refaqt/aqtuator/README.md

# AQTUATOR

A product line of linear stages.

Each stage family is a module of this repository. A Mekanika Pro milling machine is the test bench
the stages are measured on.

Folder names say what a stage is, not what it is called on a price list. A commercial name belongs
in a family's `catalog.toml` when there is one.

| Family | What |
| --- | --- |
| [`modules/flexure-ball-screw-servo-stage/`](modules/flexure-ball-screw-servo-stage/) | Linear stage with active chatter suppression: flexure guidance, ball screw, servo drive |
| [`modules/compact-stage/`](modules/compact-stage/) | Compact linear stage. Name reserved, nothing designed yet |

The flexure ball-screw servo stage is the work that started this project. Chatter — self-excited
vibration between tool and workpiece — sets the maximum depth of cut a machine can take. The work so far has been measurement:
frequency response functions at the tool and spindle, and cutting stability limits, across three
drive configurations (stepper, servo with rotary encoder feedback, servo with linear encoder
feedback). Those measurements are what an actuator design can be held against.

## Layout

This repository follows [doqs](https://github.com/refaqt/doqs), included as a submodule at
[`doqs/`](doqs/). Every folder is a module with the same internal structure.

| Folder | What |
| --- | --- |
| [`modules/`](modules/) | The stage families, each a module of its own |
| [`cad/`](cad/) | FreeCAD models |
| [`architecture/`](architecture/) | SysML requirements and block definitions |
| [`simulation/`](simulation/) | Design-time models — structural dynamics, PWM/RC trade-off |
| [`docs/`](docs/) | Activity log, decisions, mistakes, patterns |

The measurement campaigns, the firmware and the host software sit inside the family they belong to,
at [`modules/flexure-ball-screw-servo-stage/`](modules/flexure-ball-screw-servo-stage/). They move with that family if it ever becomes its own
repository.

Start with [`docs/architecture.md`](docs/architecture.md) for the technical overview, or
[`docs/log/`](docs/log/) for the chronological story — 71 entries from June 2025 onward.
For the servo drive choice, see [`docs/servo-drive-selection.md`](docs/servo-drive-selection.md).
For the linear encoder choice, see [`docs/linear-encoder-selection.md`](docs/linear-encoder-selection.md).

## Clone

```bash
git clone --recurse-submodules https://github.com/refaqt/aqtuator.git
cd aqtuator
pip install -e modules/flexure-ball-screw-servo-stage/software/identification -e modules/flexure-ball-screw-servo-stage/software/measurement-tools
```

If you already cloned without submodules, or `doqs/` / `.agents/` is empty: `bash setup-tooling.sh`
from the repo root (agents, any OS). Humans on Windows may double-click `setup-tooling.bat`. Without
`doqs/` and `.agents/`, layout validators and shared agent rules/skills are unavailable.

## Measurement data

Raw data is **not in this repository**. 1 659 files and 1.88 GB live on the `3 - Projects` Google
Drive shared drive;
[`modules/flexure-ball-screw-servo-stage/measurement/data-index.csv`](modules/flexure-ball-screw-servo-stage/measurement/data-index.csv)
describes every one of them with a checksum and parsed metadata, so the archive can be queried
without downloading it.

See [`modules/flexure-ball-screw-servo-stage/measurement/README.md`](modules/flexure-ball-screw-servo-stage/measurement/README.md) for access and
the reasoning.

## Agents

Cursor, Claude Code, and cloud agents: start at [`AGENTS.md`](AGENTS.md). Shared kit is in
[`.agents/`](.agents/); repo-specific rules and skills in [`.agents-local/`](.agents-local/).

## Hardware

- Mekanika Pro milling machine with PlanetCNC control
- ODrive S1 servo drive, linear and rotary encoder feedback. **The ODrive is for testing only. We will
  not use it in future developments.** See the
  [decision record](docs/decisions/2026-10-02_odrive-is-for-testing-only.md).
- Controllino MICRO (RP2040) for torque excitation and acquisition
- DATAQ WinDaq HiRes DAQ, 8 channels, accelerometers and impact hammer

## Licence

Copyright © 2025–2026 Refaqt (BE 0804.145.539) and contributors. Contributions are accepted under the [Refaqt Contributor Licence Agreement](https://github.com/refaqt/.github/blob/main/CLA.md).

This repository uses different licences for different kinds of content:

- **Hardware** (`cad/`, `architecture/`, `manufacturing/`, `bom/`, `builds/`, `modules/`) —
  [CERN-OHL-S v2.0](LICENSES/CERN-OHL-S-2.0.txt)
- **Firmware & software** (`simulation/`, and the `firmware/` and `software/` folders inside a
  module) — [GPL-3.0](LICENSES/GPL-3.0.txt)
- **Media & documentation** (`docs/`, and the `measurement/` folder inside a module) —
  [CC BY-SA 4.0](LICENSES/CC-BY-SA-4.0.txt)

A module carries its own `LICENSE` stub wherever its content type differs from the CERN-OHL-S that
covers `modules/`.

The REFAQT name and logo, and the AQTUATOR name and logo, are trademarks and
are not covered by the above — see [TRADEMARKS.md](TRADEMARKS.md).

See [LICENSE](LICENSE) for the full overview and directory mapping.
