refaqt/aqtuator/simulation/README.md

# Simulation

Design-time analysis: models that predict behaviour before or instead of measuring it. The measured
counterpart lives in [`modules/flexure-ball-screw-servo-stage/measurement/`](../modules/flexure-ball-screw-servo-stage/measurement/) — see
[`doqs/docs/architecture.md`](../doqs/docs/architecture.md) for the distinction.

| Case | Tool | Question |
| --- | --- | --- |
| [`encoder-stray-field`](cases/encoder-stray-field/) | Python (`magpylib`) | How strong is the linear motor field at the encoder read head, and how much does a steel plate lower it? (Magnet sizes are a worst-case guess; measure before ordering.) |
| [`housing-vibrations`](cases/housing-vibrations/) | Octave (`control`) | How do stage, housing, base and reaction masses respond to feed-driven acceleration? |
| [`mass-system`](cases/mass-system/) | Octave (`symbolic`) | Symbolic equivalent mass of the coupled two-mass system |
| [`pwm-rc-filter`](cases/pwm-rc-filter/) | Python | What PWM resolution and RC corner give the best torque-command ENOB? |
| [`short-stroke-actuator-concepts`](cases/short-stroke-actuator-concepts/) | Python | Can a two-sided 0.1 mm / > 10 Hz actuator fit 50 × 50 × 20 mm under 100 EUR? (200 N reluctance is pole-face Maxwell, not packaged continuous — Fluxthor catalog check in the case README.) |
| [`strip-seal-fatigue`](cases/strip-seal-fatigue/) | Python | Which strip material and roller size does the seal need, and how should its life be stated? (Fatigue values are measured supplier data, and they hold for dry air only.) |
| [`strip-seal-preload`](cases/strip-seal-preload/) | Python (`numpy`, `scipy`) | Which radius does a 0.25 mm strip really take over 10 mm rollers, how does the pull change it, and can 304 replace 301? (Layout read off a sketch; confirm against CAD.) |
| [`strip-seal-designer`](cases/strip-seal-designer/) | HTML + JavaScript (Node for checks) | How does the strip bend over the rollers, what force does each roller carry, and how much screw travel gives how much preload? Web page on GitHub Pages. (Magnet strip stiffness is an estimate.) |
| [`cutting-force-rejection`](cases/cutting-force-rejection/) | HTML + JavaScript (Node for checks) | How much does the stage move under a milling force? Compares a linear motor with a ball-screw servo, read at the motor or at the stage. Web page on GitHub Pages. (Coupling and axial stiffness, one sine force.) |
| [`damper-sizing`](cases/damper-sizing/) | HTML + JavaScript (Node for checks) | How fast does the stage hit its end damper after a runaway, and what damper stops it? Shows force, speed and energy along the damper stroke. Web page on GitHub Pages. (One rigid mass, no field weakening, damper force c·vⁿ.) |
| [`hard-turning-stability`](cases/hard-turning-stability/) | HTML + JavaScript (Node for checks) | Can two stacked compact stages hard turn steel at 61 to 63 HRC? Stiffness at the tool tip and stability lobes for a given depth of cut, feed and cutting speed. Web page on GitHub Pages. (Damping, thrust ratio and holder are estimates; motor loop and guides added in series.) |

Results summaries belong in `results/<case-slug>/summary.md`. Heavy outputs
(`results/<case>/exports/`) are gitignored.

## Running

```bash
octave simulation/cases/housing-vibrations/housing_vibrations.m
python simulation/cases/pwm-rc-filter/pwm_filter_optimizer.py
python3 simulation/cases/short-stroke-actuator-concepts/size_concepts.py
python3 simulation/cases/encoder-stray-field/stray_field.py
python3 simulation/cases/strip-seal-preload/strip_seal_preload.py
node simulation/cases/strip-seal-designer/check_model.mjs
node simulation/cases/cutting-force-rejection/check_model.mjs
node simulation/cases/damper-sizing/check_model.mjs
node simulation/cases/hard-turning-stability/check_model.mjs
```

Octave cases need `pkg load control` and `pkg load symbolic`.
