refaqt/aqtuator/docs/log/README.md

# Activity log

Chronological record of work on this project (engineering and business). Entries follow
`YYYY-MM-DD_topic.md`, newest listed last. Every entry must include **Role(s)**.

These entries were converted from the original `log.docx` (itself an export of the
*AQTUATOR - project log* Google Doc) and later extended. **Git is the source of truth** —
the Google Doc is retained as a historical archive and is no longer edited.

To add an entry, see [`.agents/skills/log/SKILL.md`](../../.agents/skills/log/SKILL.md).

| Date | Topic | Role(s) | Images |
| ---- | ----- | --- | -----: |
| 2025-06-26 | [Chatter mass-spring-damper model](2025-06-26_chatter-mass-spring-damper-model.md) | engineering |  |
| 2025-06-27 | [High-Z axis Z-plate modification](2025-06-27_high-z-axis-z-plate-modification.md) | engineering |  |
| 2025-08-14 | [Z motor range PlanetCNC](2025-08-14_z-motor-range-planetcnc.md) | engineering |  |
| 2025-08-28 | [Accelerometer selection IEPE](2025-08-28_accelerometer-selection-iepe.md) | engineering |  |
| 2025-09-09 | [Xcos Coselica mass-spring-damper model](2025-09-09_xcos-coselica-mass-spring-damper.md) | engineering | 2 |
| 2025-09-22 | [Actuator power requirement](2025-09-22_actuator-power-requirement.md) | engineering |  |
| 2025-09-24 | [Chatter intuitive model](2025-09-24_chatter-intuitive-model.md) | engineering |  |
| 2025-09-25 | [Laplace domain system diagram](2025-09-25_laplace-domain-system-diagram.md) | engineering |  |
| 2025-09-30 | [Milling parameters cutting stability](2025-09-30_milling-parameters-cutting-stability.md) | engineering |  |
| 2025-10-06 | [Experiment parameters tool stickout](2025-10-06_experiment-parameters-tool-stickout.md) | engineering |  |
| 2025-10-08 | [Inertia matching research](2025-10-08_inertia-matching-research.md) | engineering |  |
| 2025-10-09 | [Maximum cutting depth vs damping and stiffness](2025-10-09_max-cutting-depth-damping-stiffness.md) | engineering | 2 |
| 2025-10-10 | [Tool experiments](2025-10-10_tool-experiments.md) | engineering |  |
| 2025-10-14 | [Rotary encoder for commutation](2025-10-14_rotary-encoder-for-commutation.md) | engineering |  |
| 2025-10-16 | [Spindle speed verification](2025-10-16_spindle-speed-verification.md) | engineering |  |
| 2025-10-17 | [Meeting notes](2025-10-17_meeting-notes.md) | engineering |  |
| 2025-10-21 | [Shaft coupling selection](2025-10-21_shaft-coupling-selection.md) | engineering |  |
| 2025-11-03 | [Opta A0602 analog outputs](2025-11-03_opta-a0602-analog-outputs.md) | engineering |  |
| 2025-11-04 | [Servo motor setup](2025-11-04_servo-motor-setup.md) | engineering | 5 |
| 2025-11-05 | [Brake resistor and analog mapping](2025-11-05_brake-resistor-and-analog-mapping.md) | engineering |  |
| 2025-11-12 | [Thesis meeting](2025-11-12_thesis-meeting.md) | engineering |  |
| 2025-11-14 | [Opta analog bandwidth limit](2025-11-14_opta-analog-bandwidth-limit.md) | engineering |  |
| 2025-11-20 | [Arduino Giga system identification](2025-11-20_arduino-giga-system-identification.md) | engineering |  |
| 2025-11-24 | [Dampers and stops](2025-11-24_dampers-and-stops.md) | engineering |  |
| 2025-11-26 | [ODrive analog input stuck at 4 V](2025-11-26_odrive-analog-input-stuck-4v.md) | engineering |  |
| 2025-11-27 | [Stepper drive pulse/direction control](2025-11-27_stepper-drive-pulse-direction.md) | engineering | 1 |
| 2025-12-01 | [High speed circular motion steppers](2025-12-01_high-speed-circular-motion-steppers.md) | engineering |  |
| 2025-12-03 | [Linear encoder design](2025-12-03_linear-encoder-design.md) | engineering | 1 |
| 2025-12-10 | [NUCLEO ODrive CAN connection](2025-12-10_nucleo-odrive-can-connection.md) | engineering | 2 |
| 2025-12-18 | [Controllino CAN timing](2025-12-18_controllino-can-timing.md) | engineering |  |
| 2025-12-19 | [Stepper motor stiffness](2025-12-19_stepper-motor-stiffness.md) | engineering |  |
| 2026-01-06 | [Controllino ODrive CAN communication](2026-01-06_controllino-odrive-can-communication.md) | engineering | 1 |
| 2026-01-07 | [Multisine upload CAN torque](2026-01-07_multisine-upload-can-torque.md) | engineering |  |
| 2026-01-08 | [Controllino analog inputs](2026-01-08_controllino-analog-inputs.md) | engineering |  |
| 2026-01-09 | [Thesis meeting](2026-01-09_thesis-meeting.md) | engineering |  |
| 2026-01-12 | [ODrive limitations](2026-01-12_odrive-limitations.md) | engineering |  |
| 2026-01-15 | [E-stop design](2026-01-15_e-stop-design.md) | engineering |  |
| 2026-01-19 | [Thesis meeting](2026-01-19_thesis-meeting.md) | engineering |  |
| 2026-01-22 | [Z-axis accelerometer redesign](2026-01-22_z-axis-accelerometer-redesign.md) | engineering | 1 |
| 2026-01-27 | [Machine stiffness measurement](2026-01-27_machine-stiffness-measurement.md) | engineering |  |
| 2026-01-28 | [Controllino MCP analog scaling](2026-01-28_controllino-mcp-analog-scaling.md) | engineering |  |
| 2026-01-29 | [Stepper driver survey](2026-01-29_stepper-driver-survey.md) | engineering |  |
| 2026-02-02 | [Stability testing aluminium](2026-02-02_stability-testing-aluminium.md) | engineering |  |
| 2026-02-04 | [Steel cutting settings](2026-02-04_steel-cutting-settings.md) | engineering |  |
| 2026-02-05 | [Nanotec driver evaluation](2026-02-05_nanotec-driver-evaluation.md) | engineering |  |
| 2026-02-06 | [Controllino digital input shortage](2026-02-06_controllino-digital-input-shortage.md) | engineering |  |
| 2026-02-09 | [ODrive servo identification](2026-02-09_odrive-servo-identification.md) | engineering |  |
| 2026-02-12 | [Thesis meeting](2026-02-12_thesis-meeting.md) | engineering |  |
| 2026-02-24 | [Electrical cabinet electronics](2026-02-24_electrical-cabinet-electronics.md) | engineering | 1 |
| 2026-03-04 | [PlanetCNC step/dir/enable signals](2026-03-04_planetcnc-step-dir-enable.md) | engineering | 5 |
| 2026-03-05 | [RS-422 to TTL line receiver](2026-03-05_rs422-to-ttl-line-receiver.md) | engineering |  |
| 2026-03-10 | [ODrive motor noise on accelerometers](2026-03-10_odrive-motor-noise-on-accelerometers.md) | engineering | 2 |
| 2026-03-19 | [ODrive GUI configuration](2026-03-19_odrive-gui-configuration.md) | engineering | 7 |
| 2026-03-20 | [Stepper eigenfrequency](2026-03-20_stepper-eigenfrequency.md) | engineering |  |
| 2026-03-25 | [ODrive analog torque input](2026-03-25_odrive-analog-torque-input.md) | engineering | 9 |
| 2026-03-26 | [ODrive analog input mapping](2026-03-26_odrive-analog-input-mapping.md) | engineering |  |
| 2026-03-30 | [ODrive motor thermistor](2026-03-30_odrive-motor-thermistor.md) | engineering |  |
| 2026-03-31 | [Multisine identification](2026-03-31_multisine-identification.md) | engineering | 6 |
| 2026-04-01 | [Accelerometer system identification](2026-04-01_accelerometer-system-identification.md) | engineering | 5 |
| 2026-04-03 | [System non linearities](2026-04-03_system-non-linearities.md) | engineering | 4 |
| 2026-04-13 | [ODrive linear encoder integration](2026-04-13_odrive-linear-encoder-integration.md) | engineering | 1 |
| 2026-04-15 | [Meeting Joppe](2026-04-15_meeting-joppe.md) | engineering | 1 |
| 2026-04-16 | [Stability with flexibility](2026-04-16_stability-with-flexibility.md) | engineering | 4 |
| 2026-04-17 | [CAN cyclic identification](2026-04-17_can-cyclic-identification.md) | engineering |  |
| 2026-04-21 | [Linear motor suppliers](2026-04-21_linear-motor-suppliers.md) | engineering |  |
| 2026-04-22 | [FRF: flexible suspension vs stepper](2026-04-22_frf-flexible-vs-stepper.md) | engineering | 3 |
| 2026-04-24 | [Tap test reciprocating motion](2026-04-24_tap-test-reciprocating-motion.md) | engineering | 4 |
| 2026-04-29 | [Revert to stepper motors](2026-04-29_revert-to-stepper-motors.md) | engineering |  |
| 2026-05-07 | [FRF and compliance measurements](2026-05-07_frf-and-compliance-measurements.md) | engineering | 9 |
| 2026-05-20 | [Results so far](2026-05-20_results-so-far.md) | engineering |  |
| 2026-08-21 | [New ideas](2026-08-21_new-ideas.md) | engineering |  |
| 2026-08-21 | [doqs restructure](2026-08-21_doqs-restructure.md) | engineering |  |
| 2026-08-24 | [Reluctance actuator investigation](2026-08-24_reluctance-actuator-investigation.md) | engineering |  |
| 2026-08-27 | [Unify agent skills and rules](2026-08-27_unify-agent-skills-and-rules.md) | engineering |  |
| 2026-08-28 | [Slim AGENTS.md to thin stub](2026-08-28_slim-agents-md.md) | engineering |  |
| 2026-09-01 | [Always-latest tooling submodules](2026-09-01_always-latest-tooling-submodules.md) | engineering |  |
| 2026-09-01 | [Root launchers from setup-tooling](2026-09-01_root-launcher-install.md) | engineering |  |
| 2026-09-02 | [Short-stroke actuator concepts](2026-09-02_short-stroke-actuator-concepts.md) | engineering, hardware, simulation |  |
| 2026-09-02 | [Fluxthor reluctance force density](2026-09-02_fluxthor-reluctance-force-density.md) | engineering, simulation |  |
| 2026-09-16 | [Cloud agents can read the tooling submodules](2026-09-16_cloud-agent-tooling-refresh.md) | engineering, software |  |
| 2026-09-16 | [Checked every doqs template against this repository](2026-09-16_doqs-template-audit.md) | engineering, software |  |
| 2026-09-17 | [aqtuator moved to the one doqs command](2026-09-17_adopt-the-doqs-command.md) | engineering, software |  |
| 2026-09-17 | [An agent can now work in the open FreeCAD window](2026-09-17_freecad-mcp-bridge.md) | engineering, software, cad |  |
| 2026-09-18 | [AQTUATOR becomes a product line of linear stages](2026-09-18_stage-families-as-modules.md) | engineering |  |
| 2026-09-18 | [The FreeCAD bridge on the second computer](2026-09-18_freecad-bridge-second-computer.md) | engineering, software, cad |  |
| 2026-09-21 | [Bought parts move out of this repository](2026-09-21_bought-parts-move-to-the-parts-library.md) | engineering |  |
| 2026-09-22 | [How long the seal strip lasts, and how to say it](2026-09-22_strip-seal-fatigue.md) | engineering, simulation |  |
| 2026-09-22 | [The seal strip rollers were never the problem](2026-09-22_strip-seal-bending-radius.md) | engineering, simulation |  |
| 2026-09-22 | [The first step always runs now](2026-09-22_the-first-step-always-runs.md) | engineering, software |  |
| 2026-09-23 | [The motor field at the encoder, and a steel shield](2026-09-23_encoder-stray-field-shield.md) | engineering, simulation |  |
| 2026-09-25 | [A measured seal strip, and a way to preload ours](2026-09-25_strip-seal-thickness-and-preload.md) | engineering, measurement, hardware |  |
| 2026-09-25 | [The 0.25 mm seal strip: radius, pull, and 304 instead of 301](2026-09-25_strip-seal-radius-pull-and-304.md) | engineering, simulation |  |
| 2026-09-25 | [Drives and a motion controller for the MK21 linear stages](2026-09-25_linear-stage-drive-and-motion-controller-survey.md) | engineering, hardware, software, purchasing |  |
| 2026-09-28 | [A web page to design the seal strip and its screw preload](2026-09-28_strip-seal-designer.md) | engineering, simulation, software |  |
| 2026-09-28 | [A web page for the controller against the cutting force](2026-09-28_cutting-force-rejection.md) | engineering, simulation, software |  |
| 2026-09-28 | [The cutting force page compares a linear motor with a ball-screw servo](2026-09-28_ball-screw-servo-cases.md) | engineering, simulation, software |  |
| 2026-09-28 | [The ball screw gets its axial stiffness, and loses most of its lead](2026-09-28_ball-screw-axial-stiffness.md) | engineering, simulation, software |  |
| 2026-09-28 | [The cutting force page tunes every drive with robust rules](2026-09-28_robust-tuning-and-damping.md) | engineering, simulation, software |  |
| 2026-09-29 | [Why a lighter stage is less stiff, and why more gain does not help](2026-09-29_why-a-lighter-stage-is-less-stiff.md) | engineering, simulation |  |
| 2026-09-29 | [The cutting force page shows where chatter starts](2026-09-29_chatter-limit.md) | engineering, simulation, software |  |
| 2026-09-29 | [Servotronix drives with a faster position loop](2026-09-29_servotronix-drives-with-a-faster-loop.md) | engineering, hardware, purchasing |  |
| 2026-09-29 | [Drives from non-Israeli suppliers with an open control loop](2026-09-29_non-israeli-drives-with-open-control-loops.md) | engineering, hardware, purchasing |  |
| 2026-09-29 | [Drives below 800 euro per axis, from maker forums and open source](2026-09-29_drives-below-800-euro-per-axis.md) | engineering, hardware, purchasing |  |
| 2026-09-29 | [HIWIN, Delta and Kollmorgen follow-up](2026-09-29_hiwin-delta-kollmorgen-follow-up.md) | engineering, hardware, purchasing |  |
| 2026-09-29 | [Encoder converters and drives that read SSI or BiSS-C](2026-09-29_encoder-converter-and-ssi-biss-drives.md) | engineering, hardware, purchasing |  |
| 2026-09-29 | [The motor drive requirements are now in the SysML model](2026-09-29_motor-drive-requirements-in-sysml.md) | engineering, hardware, purchasing |  |
| 2026-09-30 | [Can the CDHD2S velocity loop run our own controller?](2026-09-30_cdhd2s-velocity-loop-custom-filter.md) | engineering, hardware, purchasing |  |
| 2026-09-30 | [Tonghang drives checked against the drive requirements](2026-09-30_tonghang-drives-checked-against-the-requirements.md) | engineering, purchasing |  |
| 2026-09-30 | [Delta ASDA-A3 drives checked against the drive requirements](2026-09-30_delta-asda-a3-checked-against-the-requirements.md) | engineering, purchasing |  |
| 2026-09-30 | [The linear stage requirements are now in the SysML model](2026-09-30_linear-stage-requirements-in-sysml.md) | engineering, hardware |  |
| 2026-09-30 | [The compact stage has its parts, its assembly and its interfaces](2026-09-30_compact-stage-parts-and-interfaces.md) | engineering, cad |  |
| 2026-10-01 | [The compact stage parts now sit in a Part container](2026-10-01_compact-stage-parts-in-a-part-container.md) | cad |  |
| 2026-10-02 | [The base has mounting holes and alignment tabs for the guide rails](2026-10-02_rail-mounting-holes-in-the-base.md) | cad, architecture |  |
| 2026-10-02 | [Comparison table of all linear encoders considered so far](2026-10-02_linear-encoder-comparison.md) | engineering, purchasing |  |
| 2026-10-02 | [One overview of all servo drives we considered](2026-10-02_servo-drive-selection-overview.md) | engineering, purchasing |  |
| 2026-10-06 | [Servo drives checked for a Bode plot tuning tool](2026-10-06_drives-checked-for-bode-plot-tuning.md) | engineering, purchasing |  |
| 2026-10-06 | [The linear encoder table has its own page](2026-10-06_linear-encoder-selection-page.md) | engineering, purchasing |  |
| 2026-10-06 | [Best linear encoder on paper, and what the short list costs](2026-10-06_linear-encoder-choice-and-prices.md) | engineering, purchasing |  |
| 2026-10-07 | [The rails are in the compact-stage assembly](2026-10-07_rails-in-the-compact-stage-assembly.md) | cad |  |
| 2026-10-07 | [How to mount the encoder scale tape in the pocket of the base](2026-10-07_mounting-the-encoder-scale-tape.md) | engineering, hardware |  |
| 2026-10-07 | [The rail blocks are in the compact-stage assembly](2026-10-07_rail-blocks-in-the-compact-stage-assembly.md) | cad |  |
| 2026-10-09 | [First draft of the bottom carriage](2026-10-09_first-draft-of-the-bottom-carriage.md) | cad |  |
| 2026-10-09 | [Carriage sides clear the base](2026-10-09_carriage-sides-clear-the-base.md) | cad |  |
| 2026-10-09 | [Stiffer bottom carriage](2026-10-09_stiffer-bottom-carriage.md) | cad |  |
| 2026-10-12 | [Linear motor pocket and cooling channel in the bottom carriage](2026-10-12_linear-motor-pocket-in-the-bottom-carriage.md) | cad |  |
| 2026-10-12 | [Water cooling fittings, and MK21 heat at 200 N](2026-10-12_water-cooling-fittings-and-mk21-heat-at-200-n.md) | engineering, purchasing |  |
| 2026-10-12 | [Idea: a path for the motor and reading head cables in the bottom carriage](2026-10-12_motor-cable-path-in-the-bottom-carriage.md) | cad | 2 |
| 2026-10-12 | [Lubrication of the guide blocks](2026-10-12_lubrication-of-the-guide-blocks.md) | engineering, cad, purchasing |  |
| 2026-10-13 | [Load and life of the HIWIN QE15 guide blocks](2026-10-13_qe15-guide-blocks-load-and-life.md) | engineering, purchasing |  |
| 2026-10-13 | [Smaller QEH15SA blocks and a thicker bottom carriage](2026-10-13_qeh15sa-blocks-and-thicker-bottom-carriage.md) | cad |  |
| 2026-10-13 | [Other makers for the QEH15SA block and EGR15U rail](2026-10-13_second-source-for-the-qe15-guide-blocks.md) | engineering, purchasing |  |
| 2026-10-13 | [Round connector for the MK21 motor cable](2026-10-13_mk21-motor-cable-connector.md) | engineering, purchasing |  |
| 2026-10-14 | [Call with Saho Robot: Lamotion encoder parts and the MK21 connector](2026-10-14_saho-robot-call-encoder-and-mk21-connector.md) | purchasing, engineering |  |
| 2026-10-14 | [The base has mounting frames for the EGR15U rails](2026-10-14_rail-frames-on-the-base.md) | cad, architecture |  |
| 2026-10-14 | [The bottom carriage has mounting frames for the guide blocks and the forcer](2026-10-14_block-and-forcer-frames-on-the-bottom-carriage.md) | cad, architecture |  |
| 2026-10-14 | [The rails in the base are 130 mm apart](2026-10-14_rails-130-mm-apart.md) | cad, architecture |  |
| 2026-10-14 | [The lower body of the bottom carriage is 2 mm narrower](2026-10-14_narrower-lower-body-of-the-bottom-carriage.md) | cad |  |
| 2026-10-14 | [The bottom carriage clears the top of the base, and the forcer pocket has a formula](2026-10-14_carriage-clears-the-top-of-the-base.md) | cad |  |
| 2026-10-14 | [The base is 200 mm wide, and the rails are 138 mm apart](2026-10-14_base-200-mm-and-rails-138-mm-apart.md) | cad, architecture |  |
| 2026-10-19 | [The forcer pocket is smaller and sits 16 mm away from the cable end](2026-10-19_smaller-forcer-pocket-moved-away-from-the-cable.md) | cad, architecture |  |
| 2026-10-19 | [The base is 210 mm wide, and the bottom carriage is 208 mm wide](2026-10-19_base-210-mm-and-wider-carriage.md) | cad, architecture |  |
| 2026-10-19 | [The forcer pocket has new clearances, and the forcer touches two short pads](2026-10-19_forcer-pocket-clearances-and-flange-pads.md) | cad |  |
| 2026-10-19 | [The bottom carriage is 2.5 mm taller, so the cable pocket can be 10 mm deep](2026-10-19_carriage-top-raised-for-10-mm-cable-pocket.md) | cad |  |
| 2026-10-19 | [DGSMARTWIN AKS drive checked for the MK21 with an EnDat 2.2 encoder](2026-10-19_dgsmartwin-aks-drive-for-mk21-with-endat.md) | engineering, purchasing |  |
| 2026-10-19 | [DGSMARTWIN SA32 absolute encoder: what to order and what to ask](2026-10-19_dgsmartwin-sa32-endat-encoder-order.md) | engineering, purchasing |  |
| 2026-10-19 | [Eddy current displacement sensors for the stage error motion test](2026-10-19_eddy-current-sensor-search.md) | engineering, purchasing |  |
| 2026-10-20 | [The bottom carriage is 1 mm lower, because the MK21 cable is only 8.3 mm thick](2026-10-20_carriage-1-mm-lower-for-8-3-mm-cable.md) | cad |  |
| 2026-10-20 | [A web page to size the end dampers of the compact stage](2026-10-20_damper-sizing-page.md) | engineering, simulation |  |
| 2026-10-20 | [When can the carriage hit the end damper hard?](2026-10-20_damper-impact-cases.md) | engineering |  |
| 2026-10-20 | [Systems that record three encoders at the same time](2026-10-20_encoder-recorder-search.md) | engineering, purchasing |  |
| 2026-10-20 | [The damper page can now calculate a polyurethane bumper](2026-10-20_bumper-on-damper-page.md) | engineering, simulation |  |
| 2026-10-20 | [The linear encoder is in the compact stage assembly](2026-10-20_encoder-in-the-compact-stage-assembly.md) | cad, architecture |  |
| 2026-10-21 | [The two carriage halves screw together in the compact stage](2026-10-21_carriage-halves-screwed-together.md) | cad, architecture |  |
| 2026-10-21 | [Where the end bumpers fit in the compact stage](2026-10-21_space-for-end-bumpers.md) | engineering, cad | 1 |
| 2026-10-22 | [Cheap inductive limit switches with a plug, and their cables](2026-10-22_inductive-limit-switches.md) | engineering, purchasing |  |
| 2026-10-22 | [Kollmorgen AKD2G checked as a replacement for the AKD, for a price request to DynamicDrives](2026-10-22_akd2g-instead-of-the-akd-for-dynamicdrives.md) | engineering, purchasing |  |
| 2026-10-22 | [Four ACE TA17-7 end stop dampers on the carriage](2026-10-22_end-stop-dampers.md) | engineering, cad, architecture | 1 |
| 2026-10-22 | [Guide blocks 10 mm closer together, and the travel check](2026-10-22_guide-blocks-10-mm-closer.md) | cad, engineering |  |
| 2026-10-22 | [Damper pockets in the end walls, and the guide blocks 20 mm closer](2026-10-22_damper-pockets-in-the-end-walls.md) | cad, engineering, architecture |  |
| 2026-10-22 | [Roller pockets back on the slope edge, and thicker walls at the read head](2026-10-22_roller-pockets-on-the-slope-edge.md) | cad |  |
| 2026-10-22 | [Roller pockets in the top carriage, linked to the bottom carriage](2026-10-22_roller-pockets-in-the-top-carriage.md) | cad |  |
| 2026-10-22 | [A printed scraper at each end of the carriage](2026-10-22_scraper-at-the-carriage-ends.md) | cad, engineering | 1 |
| 2026-10-27 | [The RSF MC 15 encoder replaces the LAMOTION encoder in the compact stage](2026-10-27_rsf-encoder-in-the-compact-stage.md) | cad, architecture |  |
| 2026-10-27 | [The compact stage uses the 240 mm RSF tape](2026-10-27_rsf-ml240-tape.md) | cad, architecture |  |
| 2026-10-28 | [New shape for the roller pockets, with R 3.5 corners](2026-10-28_roller-pocket-shape.md) | cad |  |
| 2026-10-28 | [How to close the gap at the sides of the carriage](2026-10-28_side-seal-of-the-carriage.md) | engineering, cad | 2 |
| 2026-10-28 | [Clamping the seal strip ends and setting the pull, together with the scraper](2026-10-28_strip-end-clamp-and-preload.md) | engineering, cad | 2 |
| 2026-10-28 | [Seal strip page updated to the current carriage, with the channel and friction](2026-10-28_strip-seal-designer-current-layout.md) | engineering, simulation, software |  |
| 2026-10-28 | [Seal strip page: the plastic strip on the ceiling is now a short pad](2026-10-28_strip-seal-short-ceiling-pad.md) | engineering, simulation, software |  |
| 2026-10-28 | [Seal strip rollers on flanged ball bearings, in the assembly](2026-10-28_seal-strip-rollers-in-the-assembly.md) | engineering, cad, architecture, purchasing |  |
| 2026-10-29 | [Two compact stages screw together as a cross table](2026-10-29_cross-table-mounting-holes.md) | engineering, cad, architecture |  |
| 2026-10-29 | [How to make the seal strip, and how to get edges without burrs](2026-10-29_strip-seal-edges-and-processes.md) | engineering, purchasing |  |
| 2026-10-30 | [Seal strip: corner slots, corner screws 1 mm in, and the flat strip](2026-10-30_strip-corner-slots.md) | cad |  |
| 2026-10-30 | [Scraper: what other makers do, why not felt, and a brass and TPU design](2026-10-30_scraper-brass-and-tpu.md) | engineering, cad | 1 |
| 2026-11-04 | [Seal strip: room at the 45° steps of the ears](2026-11-04_strip-ear-step-gap.md) | cad |  |
| 2026-11-04 | [Agito Akribis AGD155-EC checked, and a price request for the comparison](2026-11-04_agito-akribis-agd155-ec-price-request.md) | engineering, purchasing |  |
| 2026-11-04 | [The Akribis CASD drive looks like a Servotronix CDHD, and the two Akribis companies](2026-11-04_akribis-casd-looks-like-servotronix-cdhd.md) | engineering, purchasing |  |
| 2026-11-05 | [The second guide rail has no alignment tab now](2026-11-05_second-rail-without-tab.md) | cad, architecture |  |
| 2026-11-05 | [The magnet strips are in the compact stage](2026-11-05_magnet-strips-in-the-compact-stage.md) | cad, architecture, purchasing |  |
| 2026-11-05 | [HIWIN ED1 (E1) drive checked against the drive requirements](2026-11-05_hiwin-ed1-checked-against-the-requirements.md) | engineering, purchasing |  |
| 2026-11-05 | [The MK21 thermal sensor is now known](2026-11-05_mk21-thermal-sensor-known.md) | electrical engineering |  |
| 2026-11-05 | [Price request to HIWIN for the E1 drive and class H guides](2026-11-05_hiwin-e1-and-class-h-guides-request.md) | engineering, purchasing |  |
| 2026-11-06 | [Preliminary CE assessment of the compact stage](2026-11-06_compact-stage-ce-assessment.md) | engineering, safety |  |
| 2026-11-06 | [Forcer water cooling: O-ring seal, printed cooling block, hose route, cable clamp](2026-11-06_forcer-water-cooling-seal-and-block.md) | cad, engineering, purchasing |  |
| 2026-11-09 | [Parametric cooling block with Festo fittings, new cable clamps, screws in the assembly](2026-11-09_cooling-block-parametric-festo-fittings-cable-clamps.md) | cad, engineering, purchasing |  |
| 2026-11-09 | [CE assessment updated for the Machinery Regulation](2026-11-09_ce-assessment-for-the-machinery-regulation.md) | engineering, safety |  |
| 2026-11-09 | [Payload against speed table, damper overload, and earthing of the carriage](2026-11-09_payload-speed-table-and-earthing.md) | engineering, safety |  |
| 2026-11-09 | [DGSMARTWIN answers on the AKS drive and the SA32 encoder. We stop with them for now](2026-11-09_dgsmartwin-answers-and-stop.md) | engineering, purchasing |  |
| 2026-11-10 | [Carriage-bottom stress analysis runs again on the new part](2026-11-10_carriage-bottom-stress-analysis-rerun.md) | simulation, cad |  |
| 2026-11-10 | [Crash of the compact stage into its end stops at 2 m/s](2026-11-10_end-stop-crash-simulation.md) | simulation, engineering, safety |  |
| 2026-11-10 | [Interactive results page for the end-stop crash study](2026-11-10_crash-results-page.md) | simulation, engineering |  |
| 2026-11-10 | [HIWIN answers on the E1 drive and the EGR15U / QEH15SA guides](2026-11-10_hiwin-answers-e1-drive-and-guides.md) | engineering, purchasing |  |
| 2026-11-10 | [Short descriptions on the web pages overview](2026-11-10_describe-the-pages-overview.md) | engineering |  |
| 2026-11-11 | [Hard turning on two stacked compact stages](2026-11-11_hard-turning-stability.md) | simulation, engineering |  |
