refaqt/aqtuator/docs/decisions/README.md

# Decisions

Architecture decision records, one file per decision, per the doqs convention
`docs/decisions/YYYY-MM-DD_topic.md`.

Template: [`.agents/templates/adr.md`](../../.agents/templates/adr.md).

| Date | Entry |
| ---- | ----- |
| 2026-03-23 | [Blocking serial during real-time operation](2026-03-23_blocking-serial-during-real-time-operation.md) |
| 2026-03-23 | [Configure ODrive cyclic CAN capture by interval](2026-03-23_configure-odrive-cyclic-can-capture-by-interval.md) |
| 2026-03-23 | [Controllino GPIO label to Arduino pin mapping](2026-03-23_controllino-gpio-label-to-arduino-pin-mapping.md) |
| 2026-03-23 | [Defensive ODrive cleanup on exit](2026-03-23_defensive-odrive-cleanup-on-exit.md) |
| 2026-03-23 | [Handshake framing via READY/ACK/NACK and DATA_END](2026-03-23_handshake-framing-via-ready-ack-nack-and-data-end.md) |
| 2026-03-23 | [Use CSD/Welch for transfer estimates](2026-03-23_use-csd-welch-for-transfer-estimates.md) |
| 2026-03-25 | [Replace CAN torque with PWM->GPIO1 analog mapping](2026-03-25_replace-can-torque-with-pwm-to-gpio1-analog-mapping.md) |
| 2026-03-26 | [Runtime control-mode prompt with step/dir gating](2026-03-26_runtime-control-mode-prompt-with-step-dir-gating.md) |
| 2026-03-26 | [Spindle controller: pure discrete integrator with hold anti-windup](2026-03-26_spindle-integrator-anti-windup.md) |
| 2026-03-30 | [Hold 0 Nm at idle and gate ODrive analog endpoint](2026-03-30_hold-0-nm-at-idle-and-gate-odrive-analog-endpoint.md) |
| 2026-03-31 | [Add runtime-selectable PWM debug strategies](2026-03-31_add-runtime-selectable-pwm-debug-strategies.md) |
| 2026-03-31 | [Treat ODrive GPIO1 mode as a runtime invariant](2026-03-31_treat-odrive-gpio1-mode-as-a-runtime-invariant.md) |
| 2026-03-31 | [Update RP2040 PWM compare from timer ISR](2026-03-31_update-rp2040-pwm-compare-from-timer-isr.md) |
| 2026-04-17 | [Fix CANSimple node-id decode and store fresh torque+position pairs](2026-04-17_cansimple-node-id-decode-fix.md) |
| 2026-05-29 | [Workflow B acquisition via on-device high-rate capture](2026-05-29_workflow-b-acquisition-via-on-device-high-rate-capture.md) |
| 2026-08-27 | [Unify agent kit via refaqt-agents](2026-08-27_unify-agent-kit-via-refaqt-agents.md) |
| 2026-09-16 | [A session hook checks out the tooling submodules](2026-09-16_cloud-session-submodule-hook.md) |
| 2026-09-17 | [One doqs command, and the hook stays committed](2026-09-17_adopt-the-doqs-command.md) |
| 2026-09-18 | [Stage families are modules of AQTUATOR, not separate repositories](2026-09-18_stage-families-as-modules.md) |
| 2026-09-22 | [Strip seal material and roller size](2026-09-22_strip-seal-material-and-roller-size.md) |
| 2026-09-22 | [The first step lives in CLAUDE.md](2026-09-22_first-step-lives-in-claude-md.md) |
| 2026-09-22 | [Hide the tooling gitlinks from `git status`](2026-09-22_hide-the-tooling-gitlinks.md) |
| 2026-09-28 | [Tune each drive case with the same rule](2026-09-28_tune-each-drive-case-with-the-same-rule.md) |
| 2026-09-28 | [Robust tuning rules for the drive cases](2026-09-28_robust-tuning-rules-for-the-drive-cases.md) |
| 2026-09-30 | [Try the Servotronix polynomial velocity controller](2026-09-30_try-the-servotronix-polynomial-velocity-controller.md) |
| 2026-09-30 | [Delta ASDA-A3 is the fallback if the Servotronix drive does not work](2026-09-30_delta-asda-a3-as-fallback-drive.md) |
| 2026-10-02 | [The ODrive is a test drive only. We will not use it in future developments](2026-10-02_odrive-is-for-testing-only.md) |
| 2026-10-06 | [Kollmorgen AKD and Copley Xenus Plus are the drive candidates. Servotronix is out](2026-10-06_kollmorgen-akd-and-copley-xenus-plus-as-candidates.md) |
| 2026-10-09 | [Lay the encoder tape with a 3D-printed dummy guide block](2026-10-09_lay-the-encoder-tape-with-a-printed-dummy-block.md) |
| 2026-10-19 | [The encoder protocol follows the drive. BiSS-C is not required](2026-10-19_encoder-protocol-follows-the-drive.md) |
| 2026-10-28 | [The seal strip is 0.15 mm thick](2026-10-28_seal-strip-0-15-mm.md) |
| 2026-10-28 | [The seal strip rollers turn on two flanged ball bearings](2026-10-28_seal-strip-rollers-on-flanged-ball-bearings.md) |
| 2026-11-06 | [The forcer cooling is sealed with standard O-rings and a printed block](2026-11-06_forcer-cooling-sealed-with-standard-o-rings.md) |
| 2026-11-09 | [The cooling block runs to the side face and holds two Festo fittings](2026-11-09_cooling-block-to-the-edge-with-festo-fittings.md) |
| 2026-11-09 | [The compact stage is partly completed machinery, without limit switches](2026-11-09_compact-stage-is-partly-completed-machinery.md) |
| 2026-11-09 | [We do not continue with DGSMARTWIN for now](2026-11-09_no-dgsmartwin-for-now.md) |
