refaqt/aqtuator/simulation/cases/mass-system/README.md

# mass-system

Symbolic solve of the 5x5 linear system relating the accelerations of a coupled two-mass
arrangement, to obtain the equivalent mass `Meq` seen at the tool.

**Tool:** Octave with `pkg load symbolic`.

```bash
octave mass_system.m
```

Background in the dev-log entry
[2025-09-22 — Actuator power requirement](../../../docs/log/2025-09-22_actuator-power-requirement.md).
