refaqt/aqtuator/modules/compact-stage/simulation/cases/scraper-fit/README.md

# scraper-fit

Builds the printed scraper that sits at each end of carriage-top, and checks that it fits.
The scraper keeps chips off the seal strip before the strip goes under the carriage.

The case reads the compact-stage CAD files (base, carriage-bottom, carriage-top and the
assembly) and places each part where the assembly puts it. It does not need FreeCAD and it never
changes a CAD file. It adds a pocket to carriage-top in memory only.

## Running

Run from the repository root:

```bash
git lfs pull --include="modules/compact-stage/cad/**"
pip install cadquery-ocp numpy matplotlib shapely
python modules/compact-stage/simulation/cases/scraper-fit/run.py
```

The script stops with `FAILED` if the scraper overlaps carriage-top, carriage-bottom, the base
or a top roller.
It writes the figures to [`../../results/scraper-fit/`](../../results/scraper-fit/).

## Files

| File | What it does |
| --- | --- |
| `run.py` | Runs the fit checks, then draws all figures |
| `scraper.py` | All sizes of the scraper and the pocket, and the 3D shapes |
| `fcstd_shapes.py` | Reads the shapes out of the `.FCStd` files and places them |
| `render.py` | Cuts sections and fills them, for the figures |
| `raster.py` | Draws the 3D views pixel by pixel, so faces hide each other correctly |
| `fig_sections.py`, `fig_drawing.py`, `fig_3d.py` | The figures |

## What is assumed

- The seal strip is 0.15 mm thick (decision of 2026-10-28) and lies flat on the top of the base,
  at z = 40 mm. It has no geometry in CAD yet. The checks use a strip 186 mm wide (y = 12 to 198 mm), the widest strip
  that fits through the slope opening of the carriage.
- The top rollers have no part in CAD yet. Each one is a Ø10 × 20 mm cylinder with its axis on
  the low edge of the slanted face of carriage-top, 3.5 mm above its underside. The case checks
  this model against carriage-top (no overlap) and carriage-bottom (0.32 mm, as measured in
  FreeCAD).
- Only the start end is built. The end at the other side is the same part, turned 180°.
