refaqt/aqtuator/docs/log/2025-11-12_thesis-meeting.md

# 2025-11-12 — Thesis meeting

**Role(s):** engineering

<u>[Niels Bosmans](mailto:niels@thinkler.be)<joppe.verboven@student.kuleuven.be></u>

## Meeting Thesis

- Agenda

  - Literature study

  - Simulation model

- Notes

  - Equation PID controller ODrive

  - Machine stiffness:

    - We will measure the stiffness of the gantry with force spring + gauge.

    - Measure stiffness from ballscrew nut to spindle nose with 2 gauges

  - Integration

    - Move machine 5cm to right to have more space for spring suspension system.

- Actions

  - Find linear encoder (Niels)

  - Model of actuator and machine (Joppe)

  - Check PID controller equations (Joppe)

  - Find more papers, use AI (Joppe)
