refaqt/aqtuator/docs/log/2026-01-09_thesis-meeting.md

# 2026-01-09 — Thesis meeting

**Role(s):** engineering

<u>[Niels Bosmans](mailto:niels@thinkler.be)<joppe.verboven@student.kuleuven.be></u>

## Meeting thesis

- Agenda

  - Status update

    - Controller

    - Sensors

    - Stepper motor stiffness

  - Update thesis goal

    - FRF of accelerometer-controlled system shows higher stiffness than system with steppers

  - Plan for 2nd semester
