refaqt/aqtuator/docs/log/2026-01-15_e-stop-design.md

# 2026-01-15 — E-stop design

**Role(s):** engineering

Design E-stop

- When Mekanika E-stop is pressed, circuit is open (so normally-closed)

- When circuit is open (button is pressed), there is 5V on the E-stop terminals. (so pull-down?)

- Use this 5V do drive relay of 48V drive

- 48V, 10A power
