refaqt/aqtuator/docs/log/2026-01-22_z-axis-accelerometer-redesign.md

# 2026-01-22 — Z-axis accelerometer redesign

**Role(s):** engineering

**Redesign of accelerometers on z-axis**

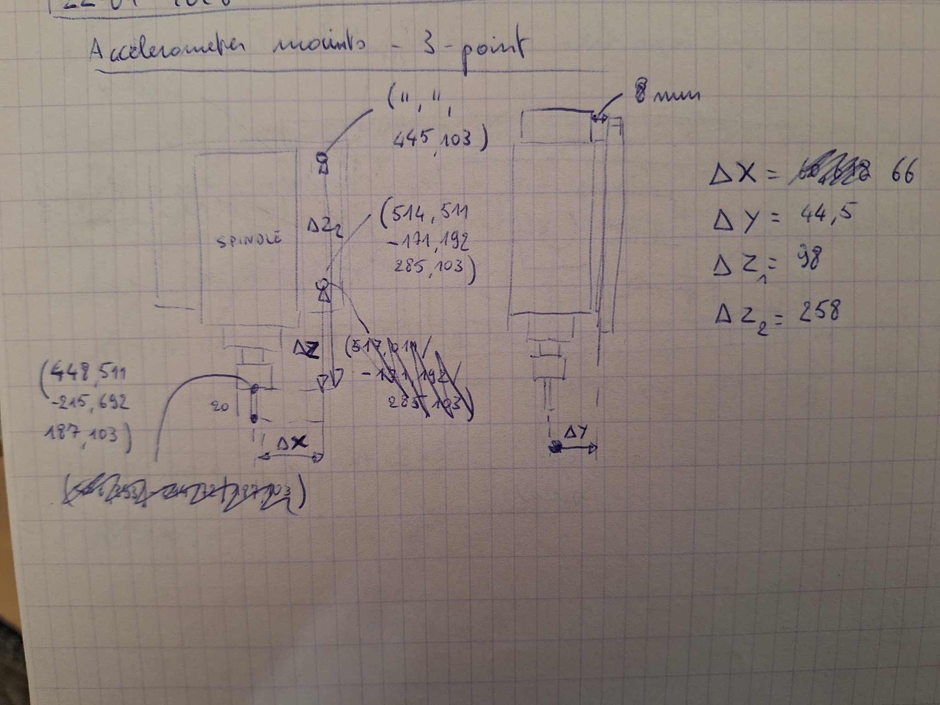
[picture p2: docs/log/images/2026-01-22-01.jpg]
