refaqt/aqtuator/docs/log/2026-02-12_thesis-meeting.md

# 2026-02-12 — Thesis meeting

**Role(s):** engineering

<u>[Niels Bosmans](mailto:niels@thinkler.be)[Joppe Verboven](mailto:joppe.verboven2003@gmail.com)</u>

**Meeting thesis**

Agenda

- Planning

  - Cabinet

  - Identification

  - Model

    - Add process

    - Add controller

    - Check eigenmodes and cuttings stiffness influence

    - Investigate damping of compliant structure

  - Design

  - Build

  - Test

- Todos overlopen

  - 3D print enclosure for ODrive

Notes

- Joppe makes planning and makes new appointment next week.
