refaqt/aqtuator/docs/linear-encoder-selection.md

# Linear encoder selection

This page shows every linear encoder we looked at for the compact stage, next to the requirements.
It is an overview, and it is still being built. The research is in the log entries linked in
[Sources](#sources). If a number here differs from a log entry, the log entry and the maker's own
data sheet win. Tell us, and we fix this page.

Last updated: 2026-10-06. The table was first made on 2026-10-02. The Heidenhain rows were read
again on 2026-10-06.

## Short answer

No encoder in the table meets all eleven requirements with a number that we read in the maker's own data sheet. ENC-11 (the allowed angle of the reading head) cannot pass or fail yet, because the stage angles are still open. It is listed as "not confirmed" in every row.

If we leave ENC-11 aside, these encoders have no failing number and no other missing number that matters. They are the short list to check first:

- RSF MS 14 MK and RSF MS 15 MK (1 Vpp, steel tape).
- Numerik Jena LIKgo, and LIKselect with no frame or with frame B (1 Vpp, steel tape).
- Numerik Jena LAKgo and LAK (absolute, BiSS-C). The data sheet does not tie the 10 m/s top speed to a resolution, so ENC-03 is open.
- AMO LMK 1005 with the high accuracy option (1 Vpp, needs an external electronics box).
- Lamotion COIN with 1 Vpp (the scale width is not given, so ENC-10 is open).
- Renishaw TONiC T1030 with an RTLC20-S tape (value taken from the earlier search).

Numerik Jena LIA, Kit L and the older LIK 21, 22, 23 and 41 parts have no published periodic error (ENC-05), so they are open on that point. They are not on the short list.

**No Heidenhain encoder meets the requirements.** On 6 October 2026 we read the current Heidenhain documents: the 02/2025 catalogue, the product sheets up to 07/2026, and the 04/2026 brochure on two-axis (Dplus) encoders. Every open Heidenhain encoder, incremental or absolute, fails at least one hard requirement on a number in those documents. Three things block them:

- Heidenhain has no BiSS-C output. Its absolute encoders (LIC) send EnDat or a Japanese serial protocol, which our drive cannot read (ENC-04).
- Most heads are 16 to 23 mm wide (ENC-06) and 46 or 50 mm long (ENC-08).
- The heads that are small enough read a glass scale that is too thick or too wide (ENC-09, ENC-10).

The three closest parts are the LIP 6081 (head fits, but the scale is 2.9 mm thick and 15 mm wide), the new LIF 6081 (head fits, but the scale is 1.13 mm thick and only made up to 130 mm long), and the LIDA 489 (thin tape, but the head is 19 × 46 mm and the tape is 13.1 mm wide).

All four makers RSF, Numerik Jena, AMO and Heidenhain belong to one group. They are not independent second sources of each other.

## What the encoder must do

The requirements are in
[`modules/compact-stage/architecture/linear-encoder.sysml`](../modules/compact-stage/architecture/linear-encoder.sysml).
That file is the source. This table is a copy for reading. Every error value is a half band:
"5 µm" means "within +/- 5 µm". The limits that say "less than" or "more than" are strict.

| Short name | Requirement |
| --- | --- |
| ENC-01 | Resolution finer than 0.2 µm |
| ENC-02 | Accuracy within +/- 5 µm over 200 mm |
| ENC-03 | Maximum speed above 3 m/s |
| ENC-04 | Output is 1 Vpp sine and cosine, or BiSS-C. Incremental and absolute are both allowed |
| ENC-05 | Periodic error within +/- 0.3 µm |
| ENC-06 | Reading head less than 15 mm wide |
| ENC-07 | Reading head less than 18 mm high |
| ENC-08 | Reading head less than 40 mm long |
| ENC-09 | Scale less than 1 mm high |
| ENC-10 | Scale less than 12 mm wide |
| ENC-11 | Reading head angle against the scale: roll, pitch and yaw each within what the data sheet allows |

## How to read the table

- A value marked "(calc)" is our own conversion. We scaled an accuracy grade in µm per metre to 200 mm. The maker does not state it for 200 mm.
- "n/c" means not confirmed. The number is not in the maker's own data sheet, or we could not open it.
- For a 1 Vpp encoder, the drive sets the resolution by cutting each signal period into steps. The table shows the signal period. We judged ENC-01 on the finest step that the data sheet allows.
- "Fails" lists only the requirements that fail on a number read in a data sheet. "Not confirmed" lists the requirements with no number.
- The head size is written as width, height and length. Width is across the direction of motion. Height is from the scale to the top of the head. Length is along the direction of motion.
- Rows for RSF, Numerik Jena, AMO, Heidenhain and Lamotion were read from the makers' own data sheets and catalogues on 2 October 2026. They list every open (exposed) model we found, incremental and absolute. Sealed (housed) models are left out.
- The Heidenhain rows were read again on 6 October 2026 from the current Heidenhain documents. The notes column names the document and edition. The LIP 382 row still comes from the 06/2021 catalogue, because the 02/2025 catalogue no longer lists it.
- For Heidenhain LIC and LIDA 400 heads, the head height is now the height of the head body (12 mm and 10 mm). The earlier 7.3 and 7.1 mm were the height of the cable outlet. Both values pass ENC-07.
- Rows under "Earlier candidates" come from the earlier searches in the business repository. They were not read again. Their verdicts are the verdicts of those searches.

## The table

| Brand | Model (head + scale) | Datasheet | Type | Principle | ENC-01 Resolution | ENC-02 Accuracy over 200 mm | ENC-03 Max speed (m/s) | ENC-04 Output | ENC-05 Periodic error (µm) | ENC-06 Head width (mm) | ENC-07 Head height (mm) | ENC-08 Head length (mm) | ENC-09 Scale height (mm) | ENC-10 Scale width (mm) | ENC-11 Roll / pitch / yaw | Fails | Not confirmed | Earlier verdict and notes |
|---|---|---|---|---|---|---|---|---|---|---|---|---|---|---|---|---|---|---|
| HEIDENHAIN | LIC 4113 / LIC 4133 / LIC 4193 (merged: same scale, other serial protocol) | [PDF](https://www.heidenhain.com/fileadmin/pdf/en/01_Products/Prospekte/PR_Exposed_Linear_Encoders_ID208960_en.pdf) | absolute | optical | 1 nm step | +/-3 um grade (+/-1, +/-5 also), ML 240-3040 | 10 (600 m/min) | EnDat 2.2 / EnDat 3 (LIC 4133) / Fanuc, Mitsubishi, Panasonic, Yaskawa | 0.02 | 19 | 12 (head body) | 46 | 3.03 (glass) | 15 | n/c / n/c / 0.55/50 mm (about 11 mrad, calc) | ENC-04, ENC-06, ENC-08, ENC-09, ENC-10 | ENC-11 | Earlier: RULED OUT 2026-09-21 (LIC 4000/4100): the drive cannot read EnDat or serial. Serial output only. Checked in edition 02/2025. |
| HEIDENHAIN | LIC 4115 / LIC 4135 / LIC 4195 (merged) | [PDF](https://www.heidenhain.com/fileadmin/pdf/en/01_Products/Prospekte/PR_Exposed_Linear_Encoders_ID208960_en.pdf) | absolute | optical | 1 nm step | +/-5 um grade, ML 140-28440 | 10 (600 m/min) | EnDat 2.2 / EnDat 3 / Fanuc, Mitsubishi, Panasonic, Yaskawa | 0.02 | 19 | 12 (head body) | 46 | n/c | 16 (extrusion) | n/c / n/c / 0.55/50 mm (about 11 mrad, calc) | ENC-04, ENC-06, ENC-08, ENC-10 | ENC-09, ENC-11 | Earlier: RULED OUT 2026-09-21 (LIC 4000/4100): the drive cannot read EnDat or serial. Tape thickness not given. Checked in edition 02/2025. |
| HEIDENHAIN | LIC 4117 / LIC 4137 / LIC 4197 (merged) | [PDF](https://www.heidenhain.com/fileadmin/pdf/en/01_Products/Prospekte/PR_Exposed_Linear_Encoders_ID208960_en.pdf) | absolute | optical | 1 nm step | +/-3 um (ML<=1040), +/-5 um (ML>=1240) | 10 (600 m/min) | EnDat 2.2 / EnDat 3 / Fanuc, Mitsubishi, Panasonic, Yaskawa | 0.02 | 19 | 12 (head body) | 46 | 2.83 (drawing, unsure) | 16 (extrusion) | n/c / n/c / 0.55/50 mm (about 11 mrad, calc) | ENC-04, ENC-06, ENC-08, ENC-09, ENC-10 | ENC-11 | Earlier: RULED OUT 2026-09-21 (LIC 4000/4100): the drive cannot read EnDat or serial. Checked in edition 02/2025. |
| HEIDENHAIN | LIC 4119 / LIC 4139 / LIC 4199 (merged) | [PDF](https://www.heidenhain.com/fileadmin/pdf/en/01_Products/Prospekte/PR_Exposed_Linear_Encoders_ID208960_en.pdf) | absolute | optical | 1 nm step | +/-3 um grade (or +/-15 um), ML 70-1020 or tape cut from roll 2, 4, 6 m | 10 (600 m/min) | EnDat 2.2 / EnDat 3 (LIC 4139) / Fanuc, Mitsubishi, Panasonic, Yaskawa | 0.02 | 19 | 12 (head body) | 46 | 0.43 (tape) | 13.14 | n/c / n/c / 0.60/50 mm (about 12 mrad, calc) | ENC-04, ENC-06, ENC-08, ENC-10 | ENC-11 | Earlier: RULED OUT 2026-09-21 (LIC 4000/4100): the drive cannot read EnDat or serial. Tape is thin enough but 13.14 wide. Checked in edition 02/2025. |
| HEIDENHAIN | LIC 4119 FS (functional safety) | [PDF](https://www.heidenhain.com/fileadmin/pdf/en/01_Products/Produktinformationen/PI_LIC4119_ID1424994_en.pdf) | absolute | optical | 1 nm step | +/-3 um grade, ML 70-1820 (selection guide 02/2025) | 10 (600 m/min) | EnDat 2.2 (SIL 2) | 0.02 | 19 | 12 (head body) | 46 | 0.43 (tape, as LIC 4119) | 13.14 | n/c / n/c / 0.55/50 mm (about 11 mrad, calc) | ENC-04, ENC-06, ENC-08, ENC-10 | ENC-11 | Earlier: RULED OUT 2026-09-21 (LIC 4000/4100): the drive cannot read EnDat or serial. Same head as LIC 4119. Product Information 02/2024. |
| HEIDENHAIN | LIC 3117 / LIC 3137 / LIC 3197 (merged) | [PDF](https://www.heidenhain.com/fileadmin/pdf/en/01_Products/Produktinformationen/PI_LIC3100_ID1312271_en.pdf) | absolute | optical | 10 nm step (8 nm with EnDat 3) | +/-15 um grade (+/-5 after software compensation), tape from roll 3, 5, 10 m | 10 (600 m/min) | EnDat 2.2 / EnDat 3 / Fanuc, Mitsubishi, Panasonic, Yaskawa | 0.1 | 19 | 12 (head body) | 46 | 2.83 (drawing, unsure) | 16 (extrusion) | n/c / n/c / 0.60/50 mm (about 12 mrad, calc) | ENC-02, ENC-04, ENC-06, ENC-08, ENC-09, ENC-10 | ENC-11 | New, not judged before. Fails on grade and output. Checked in edition 02/2025 and Product Information 11/2023. |
| HEIDENHAIN | LIC 3119 / LIC 3139 / LIC 3199 (merged) | [PDF](https://www.heidenhain.com/fileadmin/pdf/en/01_Products/Prospekte/PR_Exposed_Linear_Encoders_ID208960_en.pdf) | absolute | optical | 10 nm step (8 nm with EnDat 3) | +/-15 um grade (+/-5 after software compensation), tape from roll 3, 5, 10 m | 10 (600 m/min) | EnDat 2.2 / EnDat 3 / Fanuc, Mitsubishi, Panasonic, Yaskawa | 0.1 | 19 | 12 (head body) | 46 | 0.43 (tape) | 13.14 | n/c / n/c / 0.60/50 mm (about 12 mrad, calc) | ENC-02, ENC-04, ENC-06, ENC-08, ENC-10 | ENC-11 | New, not judged before. Checked in edition 02/2025. |
| HEIDENHAIN | LIC 2117 / LIC 2197 (merged) | [PDF](https://www.heidenhain.com/fileadmin/pdf/en/01_Products/Prospekte/PR_Exposed_Linear_Encoders_ID208960_en.pdf) | absolute | optical | 50 nm or 100 nm step | +/-15 um grade, tape from roll 3, 5, 10 m | 10 (600 m/min) | EnDat 2.2 / Fanuc, Mitsubishi, Panasonic, Yaskawa | 2 | 19 | 12 (head body) | 46 | 2.88 (drawing) | 16 (extrusion) | n/c / n/c / 1.7/50 mm (about 34 mrad, calc) | ENC-02, ENC-04, ENC-05, ENC-06, ENC-08, ENC-09, ENC-10 | ENC-11 | New, not judged before. Checked in edition 02/2025. |
| HEIDENHAIN | LIC 2119 / LIC 2199 (merged) | [PDF](https://www.heidenhain.com/fileadmin/pdf/en/01_Products/Prospekte/PR_Exposed_Linear_Encoders_ID208960_en.pdf) | absolute | optical | 50 nm or 100 nm step | +/-15 um grade, tape from roll 3, 5, 10 m | 10 (600 m/min) | EnDat 2.2 / Fanuc, Mitsubishi, Panasonic, Yaskawa | 2 | 19 | 12 (head body) | 46 | 0.33 (tape) | 12.7 | n/c / n/c / 1.7/50 mm (about 34 mrad, calc) | ENC-02, ENC-04, ENC-05, ENC-06, ENC-08, ENC-10 | ENC-11 | New, not judged before. Checked in edition 02/2025. |
| HEIDENHAIN | LIC 4113 V / LIC 4193 V (high vacuum) | [PDF](https://www.heidenhain.com/fileadmin/pdf/en/01_Products/Produktinformationen/PI_LIC4113V_LIC4193V_ID1133597_en.pdf) | absolute | optical | 1 nm step | +/-3 um grade (+/-1, +/-5 also), ML 240-3040 | 10 (600 m/min) | EnDat 2.2 / Fanuc, Mitsubishi, Panasonic, Yaskawa | 0.02 | 19 | n/c | n/c | n/c (glass scale, clamped) | n/c | n/c | ENC-04, ENC-06 | ENC-07 to ENC-11 | Earlier: RULED OUT 2026-09-21 (LIC 4000/4100): the drive cannot read EnDat or serial. Product Information 04/2026. Vacuum version of the LIC 4113. |
| HEIDENHAIN | LIC 4100 Dplus / LIC 2100 Dplus (two-axis scale, merged) | [PDF](https://www.heidenhain.com/fileadmin/pdf/en/01_Products/Produktinformationen/PI_LIC4100Dplus_ID1508595_en.pdf) | absolute | optical | 1 nm step (LIC 4100); 50 or 100 nm (LIC 2100) | +/-3 or +/-5 um grade in X, ML 240-3040 | 10 (600 m/min) | EnDat 2.2 / EnDat 3 / Fanuc, Mitsubishi, Panasonic, Yaskawa | 0.02 (LIC 4100); 0.4 (LIC 2100) | n/c (standard LIC head, 19 in the brochure) | n/c | 46 | 2.9 (glass, bonded) | 20 | n/c | ENC-04, ENC-08, ENC-09, ENC-10, ENC-05 (LIC 2100 only) | ENC-06, ENC-07, ENC-11 | New, not judged before. Adds a second track across the motion. Product Information 07/2026. |
| HEIDENHAIN | LIP 382 | [PDF](https://www.heidenhain.us/wp-content/uploads/2024/08/PR_Exposed_Linear_Encoders_ID208960_en.pdf) | incremental | optical | 1 Vpp: set by interpolation; period 0.128 um | +/-0.5 um grade, ML 70-270 | 0.127 (7.6 m/min) | 1 Vpp (via APE box) | 0.00001 | 55 (flange) | n/c | n/c | n/c | n/c | 0.5 mrad max change (axis not labelled) / n/c / n/c | ENC-03, ENC-06 | ENC-07, ENC-08, ENC-09, ENC-10, ENC-11 | New, not judged before. Very slow. Class 3B laser. From edition 06/2021. Not in the 02/2025 edition. |
| HEIDENHAIN | LIP 211 | [PDF](https://www.heidenhain.com/fileadmin/pdf/en/01_Products/Prospekte/PR_Exposed_Linear_Encoders_ID208960_en.pdf) | incremental | optical | 0.03125 nm step (EnDat) | +/-1 um or +/-3 um grade, ML 20-3040 | 2 (120 m/min) | EnDat 2.2 | 0.0004 | 20 | n/c | 27 | 2.9 (incl. glue) | 15 | n/c / n/c / 3.5 mrad | ENC-03, ENC-04, ENC-06, ENC-09, ENC-10 | ENC-07, ENC-11 | New, not judged before. Zerodur scale is thick. Checked in edition 02/2025. |
| HEIDENHAIN | LIP 291 | [PDF](https://www.heidenhain.com/fileadmin/pdf/en/01_Products/Prospekte/PR_Exposed_Linear_Encoders_ID208960_en.pdf) | incremental | optical | as LIP 211 | +/-1 um or +/-3 um grade, ML 20-3040 | 2 (120 m/min) | Fanuc / Mitsubishi serial | 0.0004 | 20 | n/c | 27 | 2.9 (incl. glue) | 15 | n/c / n/c / 3.5 mrad | ENC-03, ENC-04, ENC-06, ENC-09, ENC-10 | ENC-07, ENC-11 | New, not judged before. Checked in edition 02/2025. |
| HEIDENHAIN | LIP 281 | [PDF](https://www.heidenhain.com/fileadmin/pdf/en/01_Products/Prospekte/PR_Exposed_Linear_Encoders_ID208960_en.pdf) | incremental | optical | 1 Vpp: set by interpolation; period 0.512 um | +/-1 um or +/-3 um grade, ML 20-3040 | 1.5 (90 m/min) | 1 Vpp | 0.0004 | 20 | n/c | 27 | 2.9 (incl. glue) | 15 | n/c / n/c / 3.5 mrad | ENC-03, ENC-06, ENC-09, ENC-10 | ENC-07, ENC-11 | Earlier: RE-OPENED 2026-09-21 by the relaxed rule; no per-series error figure then. Speed 1.5 m/s is too low. Checked in edition 02/2025. |
| HEIDENHAIN | LIP 211 Dplus / LIP 281 Dplus / LIP 291 Dplus (two-axis scale, merged) | [PDF](https://www.heidenhain.com/fileadmin/pdf/en/01_Products/Prospekte/PR_MULTI-DOF_Measurement_Technology_for_Multiple_Degrees_of_Freedom_ID1349070_en.pdf) | incremental | optical | as LIP 211 / LIP 281 | +/-3 um grade in X, ML 70-720 | 2 (EnDat, serial); 1.5 (1 Vpp) | EnDat 2.2 / Fanuc / Mitsubishi / 1 Vpp (LIP 281 Dplus) | 0.0004 | n/c | n/c | n/c | n/c | n/c | n/c | ENC-03, ENC-04 (LIP 211 and 291 Dplus) | ENC-01, ENC-06 to ENC-11 | New, not judged before. Speed is too low. Multi-axis brochure 04/2026. |
| HEIDENHAIN | LIP 6081 | [PDF](https://www.heidenhain.com/fileadmin/pdf/en/01_Products/Prospekte/PR_Exposed_Linear_Encoders_ID208960_en.pdf) | incremental | optical | 1 Vpp: set by interpolation; period 4 um | +/-1 um (Zerodur) or +/-3 um grade, ML 20-3040 | 4 (240 m/min) | 1 Vpp | 0.004 | 12.7 | 6.8 | 26 | 2.9 (plus 0.13 adhesive tape when bonded) | 15 to 16 (drawing) | n/c | ENC-09, ENC-10 | ENC-01, ENC-11 | New, not judged before. Head fits, scale does not. The closest Heidenhain part on numbers. Checked in edition 02/2025. |
| HEIDENHAIN | LIP 6071 | [PDF](https://www.heidenhain.com/fileadmin/pdf/en/01_Products/Prospekte/PR_Exposed_Linear_Encoders_ID208960_en.pdf) | incremental | optical | TTL up to 500-fold: 0.008 um | +/-1 um (Zerodur) or +/-3 um grade, ML 20-3040 | 1.25 max (75 m/min); 0.0125 at 500-fold | TTL | n/c (+/-0.004 for 1 Vpp head) | 12.7 | 6.8 | 26 | 2.9 (plus 0.13 adhesive tape when bonded) | 15 to 16 (drawing) | n/c | ENC-03, ENC-04, ENC-09, ENC-10 | ENC-05, ENC-11 | New, not judged before. Checked in edition 02/2025. |
| HEIDENHAIN | LIP 6081 Dplus (two-axis scale) | [PDF](https://www.heidenhain.com/fileadmin/pdf/en/01_Products/Prospekte/PR_MULTI-DOF_Measurement_Technology_for_Multiple_Degrees_of_Freedom_ID1349070_en.pdf) | incremental | optical | 1 Vpp: set by interpolation; period 4 um | +/-3 um grade in X, ML 70-3040 | 4 (240 m/min) | 1 Vpp | 0.005 | n/c (head sits at 45 degrees) | n/c | n/c | n/c (mounting stack 10.58, as LIP 6081) | n/c | n/c | none read | ENC-01, ENC-06 to ENC-11 | New, not judged before. Two graduations at +/-45 degrees. The drawing shows a wide glass ceramic scale, but gives no scale size. Multi-axis brochure 04/2026. |
| HEIDENHAIN | LIP 6031 Dplus (two-axis scale) | [PDF](https://www.heidenhain.com/fileadmin/pdf/en/01_Products/Prospekte/PR_MULTI-DOF_Measurement_Technology_for_Multiple_Degrees_of_Freedom_ID1349070_en.pdf) | incremental | optical | 172 pm step | +/-3 um grade in X, ML 70-3040 | 4 (240 m/min) | EnDat 3 | 0.005 | n/c | n/c | n/c | n/c | n/c | n/c | ENC-04 | ENC-06 to ENC-11 | New, not judged before. Multi-axis brochure 04/2026. |
| HEIDENHAIN | LIF 6081 | [PDF](https://www.heidenhain.com/fileadmin/pdf/en/01_Products/Produktinformationen/PI_LIF6000_ID1509120_en.pdf) | incremental | optical | 1 Vpp: set by interpolation; period 4 um | +/-3 um grade, but ML only up to 130 mm | 4 (240 m/min) | 1 Vpp | 0.004 | 12.7 | 6.8 | n/c | 1.13 (drawing) | 7 | n/c | ENC-02, ENC-09 | ENC-01, ENC-08, ENC-11 | New, not judged before. Smallest Heidenhain head. Fails because the scale is too short for 200 mm and slightly too thick. Product Information 06/2026. |
| HEIDENHAIN | LIF 6071 | [PDF](https://www.heidenhain.com/fileadmin/pdf/en/01_Products/Produktinformationen/PI_LIF6000_ID1509120_en.pdf) | incremental | optical | TTL up to 500-fold: 0.008 um | +/-3 um grade, but ML only up to 130 mm | 2.5 max (150 m/min); 0.25 at 100-fold | TTL | n/c (+/-0.004 for 1 Vpp head) | 12.7 | 6.8 | n/c | 1.13 (drawing) | 7 | n/c | ENC-02, ENC-03, ENC-04, ENC-09 | ENC-05, ENC-08, ENC-11 | New, not judged before. Product Information 06/2026. |
| HEIDENHAIN | LIF 481 | [PDF](https://www.heidenhain.com/fileadmin/pdf/en/01_Products/Prospekte/PR_Exposed_Linear_Encoders_ID208960_en.pdf) | incremental | optical | 1 Vpp: set by interpolation; period 4 um | +/-1 um (Zerodur) or +/-3 um grade, ML 70-1640 | 4 (240 m/min) | 1 Vpp | 0.012 | 16 | 8 | 26 | 3.05 (incl. film) | 10 | 0.1 mrad yaw max change / n/c / n/c | ENC-06, ENC-09 | ENC-01, ENC-11 | Earlier: RE-OPENED 2026-09-21 by the relaxed rule; no per-series error figure then. Head 16 wide and scale 3 mm thick. Checked in edition 02/2025. |
| HEIDENHAIN | LIF 471 | [PDF](https://www.heidenhain.com/fileadmin/pdf/en/01_Products/Prospekte/PR_Exposed_Linear_Encoders_ID208960_en.pdf) | incremental | optical | TTL up to 100-fold: 0.04 um | +/-1 um (Zerodur) or +/-3 um grade, ML 70-1640 | 0.2 at 100-fold (12 m/min); 2 max | TTL | n/c (+/-0.012 for 1 Vpp head) | 16 | 8 | 26 | 3.05 (incl. film) | 10 | 0.1 mrad yaw max change / n/c / n/c | ENC-03, ENC-04, ENC-06, ENC-09 | ENC-05, ENC-11 | New, not judged before. Checked in edition 02/2025. |
| HEIDENHAIN | LIF 471 V / LIF 481 V / LIF 481 U (high and ultrahigh vacuum, merged) | [PDF](https://www.heidenhain.com/fileadmin/pdf/en/01_Products/Produktinformationen/PI_LIF471V_LIF481V_ID662692_en.pdf) | incremental | optical | period 4 um; TTL steps as LIF 471 | +/-3 um grade, ML 70-1640 | n/c | 1 Vpp (481 V, 481 U) / TTL (471 V) | n/c | n/c | n/c | n/c | n/c (clamped glass scale, as LIF 481) | n/c | n/c | ENC-04 (LIF 471 V only) | ENC-01, ENC-03, ENC-05 to ENC-11 | New, not judged before. Product Information 03/2024 was read for the scale only. Same scale family as LIF 481, so ENC-09 is likely to fail. |
| HEIDENHAIN | LIF 171 / LIF 181 (merged, TTL / 1 Vpp) | [PDF](https://www.heidenhain.com/fileadmin/pdf/en/01_Products/Produktinformationen/PI_LIF171_LIF181_ID595192_en.pdf) | incremental | optical | 1 Vpp: period 4 um; TTL best 0.4 um | +/-3 um (+/-1 um Zerodur up to ML 1640), ML 70-3040 | 4 for 1 Vpp (240 m/min); TTL 0.8 max | TTL (171) / 1 Vpp (181) | 0.012 | 23 | 19.9 (from mounting surface, incl. scale) | 35 | 3.3 | 20 | n/c / n/c / 1 mrad (incremental track, max change) | ENC-06, ENC-08, ENC-09, ENC-10, ENC-01, ENC-03 and ENC-04 (LIF 171 only) | ENC-01 (LIF 181), ENC-07, ENC-11 | New, not judged before. Distance-coded reference marks. Product Information 07/2018. |
| HEIDENHAIN | LIF 481 Dplus / LIF 471 Dplus (Y track added, merged) | [PDF](https://www.heidenhain.com/fileadmin/pdf/en/01_Products/Produktinformationen/PI_LIF4x1Dplus_ID1104654_en.pdf) | incremental | optical | 1 Vpp: period 4 um; TTL best 0.01 um step | +/-3 um grade in X, ML 70-3040 | 4 for 1 Vpp (240 m/min) | 1 Vpp (481) / TTL (471) | 0.012 | 16 (LIF 48 head) | n/c | n/c | n/c | n/c | n/c | ENC-06, ENC-04 (LIF 471 Dplus only) | ENC-01, ENC-07 to ENC-11 | New, not judged before. Same head as LIF 481. Product Information 02/2022. |
| HEIDENHAIN | LIDA 483 | [PDF](https://www.heidenhain.com/fileadmin/pdf/en/01_Products/Prospekte/PR_Exposed_Linear_Encoders_ID208960_en.pdf) | incremental | optical | 1 Vpp: set by interpolation; period 20 um | +/-1 um (Robax), +/-3 um or +/-5 um grade, ML 240-3040 | 10 (600 m/min) | 1 Vpp | 0.045 | 19 | 10 (head body) | 46 | 3.03 (glass) | 15 | 5 / 5 / 5 mrad (incremental track, max change) | ENC-06, ENC-08, ENC-09, ENC-10 | ENC-01, ENC-11 | Earlier: RE-OPENED 2026-09-21 by the relaxed rule; no per-series error figure then. Head 19 x 46 is too big. Checked in edition 02/2025. |
| HEIDENHAIN | LIDA 473 | [PDF](https://www.heidenhain.com/fileadmin/pdf/en/01_Products/Prospekte/PR_Exposed_Linear_Encoders_ID208960_en.pdf) | incremental | optical | TTL up to 100-fold: 0.2 um | +/-1 um (Robax), +/-3 um or +/-5 um grade, ML 240-3040 | 0.5 at 100-fold (30 m/min); 8 max | TTL | n/c (+/-0.045 for 1 Vpp head) | 19 | 10 (head body) | 46 | 3.03 (glass) | 15 | 5 / 5 / 5 mrad (incremental track, max change) | ENC-01, ENC-03, ENC-04, ENC-06, ENC-08, ENC-09, ENC-10 | ENC-05, ENC-11 | New, not judged before. Earlier list noted: not available below 240 mm. Checked in edition 02/2025. |
| HEIDENHAIN | LIDA 485 | [PDF](https://www.heidenhain.com/fileadmin/pdf/en/01_Products/Prospekte/PR_Exposed_Linear_Encoders_ID208960_en.pdf) | incremental | optical | 1 Vpp: set by interpolation; period 20 um | +/-5 um grade, ML 140-30040 | 10 (600 m/min) | 1 Vpp | 0.045 | 19 | 10 (head body) | 46 | n/c | 16 (extrusion) | 2 / 2 / 5 mrad (incremental track, max change) | ENC-06, ENC-08, ENC-10 | ENC-01, ENC-09, ENC-11 | Earlier: RE-OPENED 2026-09-21 by the relaxed rule; no per-series error figure then. Head too big. Checked in edition 02/2025. |
| HEIDENHAIN | LIDA 475 | [PDF](https://www.heidenhain.com/fileadmin/pdf/en/01_Products/Prospekte/PR_Exposed_Linear_Encoders_ID208960_en.pdf) | incremental | optical | TTL up to 100-fold: 0.2 um | +/-5 um grade, ML 140-30040 | 0.5 at 100-fold (30 m/min); 8 max | TTL | n/c (+/-0.045 for 1 Vpp head) | 19 | 10 (head body) | 46 | n/c | 16 (extrusion) | 2 / 2 / 5 mrad (incremental track, max change) | ENC-01, ENC-03, ENC-04, ENC-06, ENC-08, ENC-10 | ENC-05, ENC-09, ENC-11 | New, not judged before. Checked in edition 02/2025. |
| HEIDENHAIN | LIDA 487 | [PDF](https://www.heidenhain.com/fileadmin/pdf/en/01_Products/Prospekte/PR_Exposed_Linear_Encoders_ID208960_en.pdf) | incremental | optical | 1 Vpp: set by interpolation; period 20 um | +/-3 um (ML<=1040), +/-5 um (ML>=1240), or +/-15 um; ML 240-6040 | 10 (600 m/min) | 1 Vpp | 0.045 | 19 | 10 (head body) | 46 | 2.7 (drawing) | 16 (extrusion) | 2 / 2 / 5 mrad (incremental track, max change) | ENC-06, ENC-08, ENC-09, ENC-10 | ENC-01, ENC-11 | New, not judged before. Checked in edition 02/2025. |
| HEIDENHAIN | LIDA 477 | [PDF](https://www.heidenhain.com/fileadmin/pdf/en/01_Products/Prospekte/PR_Exposed_Linear_Encoders_ID208960_en.pdf) | incremental | optical | TTL up to 100-fold: 0.2 um | +/-3 um (ML<=1040), +/-5 um (ML>=1240), or +/-15 um; ML 240-6040 | 0.5 at 100-fold (30 m/min); 8 max | TTL | n/c (+/-0.045 for 1 Vpp head) | 19 | 10 (head body) | 46 | 2.7 (drawing) | 16 (extrusion) | 2 / 2 / 5 mrad (incremental track, max change) | ENC-01, ENC-03, ENC-04, ENC-06, ENC-08, ENC-09, ENC-10 | ENC-05, ENC-11 | New, not judged before. Checked in edition 02/2025. |
| HEIDENHAIN | LIDA 489 | [PDF](https://www.heidenhain.com/fileadmin/pdf/en/01_Products/Prospekte/PR_Exposed_Linear_Encoders_ID208960_en.pdf) | incremental | optical | 1 Vpp: set by interpolation; period 20 um | +/-3 um grade (or +/-15 um), ML 70-1020 or tape cut from roll 2, 4, 6 m | 10 (600 m/min) | 1 Vpp | 0.045 | 19 | 10 (head body) | 46 | 0.43 (tape) | 13.1 | 5 / 5 / 5 mrad (incremental track, max change) | ENC-06, ENC-08, ENC-10 | ENC-01, ENC-11 | New, not judged before. Closest on scale and speed; head and tape width fail. Checked in edition 02/2025. |
| HEIDENHAIN | LIDA 479 | [PDF](https://www.heidenhain.com/fileadmin/pdf/en/01_Products/Prospekte/PR_Exposed_Linear_Encoders_ID208960_en.pdf) | incremental | optical | TTL up to 100-fold: 0.2 um | +/-3 um grade (or +/-15 um), ML 70-1020 or tape cut from roll 2, 4, 6 m | 0.5 at 100-fold (30 m/min); 8 max | TTL | n/c (+/-0.045 for 1 Vpp head) | 19 | 10 (head body) | 46 | 0.43 (tape) | 13.1 | 5 / 5 / 5 mrad (incremental track, max change) | ENC-01, ENC-03, ENC-04, ENC-06, ENC-08, ENC-10 | ENC-05, ENC-11 | New, not judged before. Checked in edition 02/2025. |
| HEIDENHAIN | LIDA 287 / LIDA 277 (merged, 1 Vpp / TTL) | [PDF](https://www.heidenhain.com/fileadmin/pdf/en/01_Products/Prospekte/PR_Exposed_Linear_Encoders_ID208960_en.pdf) | incremental | optical | 1 Vpp: period 200 um; TTL best 2 um | +/-15 um grade (tape from roll 3, 5, 10 m) | 10 for 1 Vpp (600 m/min); TTL 5 or 2.5 | 1 Vpp (287) / TTL (277) | 2 | 21 | 8.7 | 50 | n/c | n/c | n/c / n/c / 6 mrad | ENC-02, ENC-05, ENC-06, ENC-08, ENC-04 (LIDA 277 only) | ENC-01, ENC-09, ENC-10, ENC-11 | New, not judged before. Checked in edition 02/2025. |
| HEIDENHAIN | LIDA 289 / LIDA 279 (merged, 1 Vpp / TTL) | [PDF](https://www.heidenhain.com/fileadmin/pdf/en/01_Products/Prospekte/PR_Exposed_Linear_Encoders_ID208960_en.pdf) | incremental | optical | 1 Vpp: period 200 um; TTL best 2 um | +/-15 um grade (tape from roll 3, 5, 10 m) | 10 for 1 Vpp (600 m/min); TTL 5 or 2.5 | 1 Vpp (289) / TTL (279) | 2 | 21 | 8.7 | 50 | 0.33 (tape) | 12.7 | n/c / n/c / 6 mrad | ENC-02, ENC-05, ENC-06, ENC-08, ENC-10, ENC-04 (LIDA 279 only) | ENC-01, ENC-11 | New, not judged before. Checked in edition 02/2025. |
| HEIDENHAIN | PP 281 R (two-axis grid plate) | [PDF](https://www.heidenhain.com/fileadmin/pdf/en/01_Products/Prospekte/PR_Exposed_Linear_Encoders_ID208960_en.pdf) | incremental | optical | 1 Vpp: period 4 um; steps 1 to 0.05 um | +/-2 um grade, area 68 x 68 mm (not 200 mm) | 1.2 (72 m/min) | 1 Vpp | 0.012 | n/c | n/c | n/c | 3 (grid plate) | 98 | n/c / n/c / 0.4 mrad | ENC-03, ENC-09, ENC-10 | ENC-06, ENC-07, ENC-08, ENC-11 | New, not judged before. Planar encoder, not a linear axis scale. Checked in edition 02/2025. |
| HEIDENHAIN | PP 6004 / PP 6002 with AK PP 608 (1 Vpp) or AK PP 603 (EnDat 3) | [PDF](https://www.heidenhain.com/fileadmin/pdf/en/01_Products/Prospekte/PR_MULTI-DOF_Measurement_Technology_for_Multiple_Degrees_of_Freedom_ID1349070_en.pdf) | incremental | optical | 1 Vpp: period 4 um (AK PP 608); 244 pm (EnDat 3) | +/-2 um (up to 120 x 120 mm) or +/-3 um (237 x 237 and 480 x 480 mm) | 4 (240 m/min) | 1 Vpp / EnDat 3 | 0.005 | 12.7 (as LIP 6000 head) | 6.8 | n/c | 2.9 or 10 (grid plate) | 68 to 498 (grid plate) | n/c | ENC-09, ENC-10, ENC-04 (AK PP 603 only) | ENC-01, ENC-08, ENC-11 | New, not judged before. Planar grid plate, not a linear axis scale. Multi-axis brochure 04/2026. |
| HEIDENHAIN | GAP 1081 (gap sensor on a mirror) | [PDF](https://www.heidenhain.com/fileadmin/pdf/en/01_Products/Prospekte/PR_MULTI-DOF_Measurement_Technology_for_Multiple_Degrees_of_Freedom_ID1349070_en.pdf) | incremental | optical | 1 Vpp: period 2.22 um | +/-0.2 um, but only in the gap direction (range +/-2 mm) | 0.06 (3.6 m/min) | 1 Vpp | 0.002 | n/c | n/c | n/c | n/c | n/c | n/c | ENC-02, ENC-03 | ENC-01, ENC-06 to ENC-11 | New, not judged before. Measures the height gap, not the position along the axis. Multi-axis brochure 04/2026. |
| RSF Elektronik | MS 14 MK (steel tape) | [PDF](https://www.rsf.at/wp-content/uploads/2024/10/MS14-EN.pdf) | incremental | optical | 40 um period; 1 Vpp: set by interpolation | +/-3 (calc); grade +/-15 um/m | 10 (1 Vpp) | 1 Vpp or TTL | +/-0.065 (typ, pk-pk) | 13.5 | 14.8 | 36 | 0.45 | 8 | 4.0 / 3.5 / 1.0 mrad | none | ENC-11 | New, not judged before. In the 2026-10-02 visit prep (not in CSV yet). Only grade 15 um/m, so it passes with little room. |
| RSF Elektronik | MS 14 MP (tape in Al carrier) | [PDF](https://www.rsf.at/wp-content/uploads/2024/10/MS14-EN.pdf) | incremental | optical | 40 um period; 1 Vpp: set by interpolation | +/-3 (calc); grade +/-15 um/m | 10 (1 Vpp) | 1 Vpp or TTL | +/-0.065 (typ, pk-pk) | 13.5 | 14.8 | 36 | n/c | n/c | n/c | none | ENC-09, ENC-10, ENC-11 | Same head as MK. MP drawing not read. MS 15 MP shows a 16 mm wide, 2.6 mm high carrier, so MP likely fails scale size. |
| RSF Elektronik | MS 15 MK (steel tape) | [PDF](https://www.rsf.at/wp-content/uploads/downloads/MS15-EN.pdf) | incremental | optical | 40 um period; 1 Vpp: set by interpolation | +/-1 (calc); grade +/-5 um/m (or 15) | 10 (1 Vpp) | 1 Vpp or TTL | +/-0.065 (typ, pk-pk) | 13.5 | 14.8 | 36 | 0.45 | 8 | 4.0 / 3.5 / 1.0 mrad | none | ENC-11 | New, not judged before. In the 2026-10-02 visit prep (not in CSV yet). Passes on paper with the +/-5 um/m grade. Adds two switch tracks over MS 14. |
| RSF Elektronik | MS 15 MP (tape in Al carrier) | [PDF](https://www.rsf.at/wp-content/uploads/downloads/MS15-EN.pdf) | incremental | optical | 40 um period; 1 Vpp: set by interpolation | +/-1 (calc); grade +/-5 um/m (or 15) | 10 (1 Vpp) | 1 Vpp or TTL | +/-0.065 (typ, pk-pk) | 13.5 | 14.8 | 36 | 2.6 | 16 | 4.0 / 3.5 / 1.0 mrad | ENC-09, ENC-10 | ENC-11 | New, not judged before. In the 2026-10-02 visit prep (not in CSV yet). Carrier is too big and too wide. |
| RSF Elektronik | MS 15 GK (glass, tape) | [PDF](https://www.rsf.at/wp-content/uploads/downloads/MS15-EN.pdf) | incremental | optical | 40 um period; 1 Vpp: set by interpolation | +/-0.6 (calc); grade +/-3 um/m (or 5) | 10 (1 Vpp) | 1 Vpp or TTL | +/-0.065 (typ, pk-pk) | 13.5 | 14.8 | 36 | 2.44-2.64 | 10 | 4.0 / 3.5 / 1.0 mrad | ENC-09 | ENC-11 | New, not judged before. In the 2026-10-02 visit prep (not in CSV yet). Best accuracy, but the glass is over 1 mm thick. Length only 3140 mm. |
| RSF Elektronik | MS 15 BK (glass ceramic, tape) | [PDF](https://www.rsf.at/wp-content/uploads/downloads/MS15-EN.pdf) | incremental | optical | 40 um period; 1 Vpp: set by interpolation | +/-0.6 (calc); grade +/-3 um/m (or 5) | 10 (1 Vpp) | 1 Vpp or TTL | +/-0.065 (typ, pk-pk) | 13.5 | 14.8 | 36 | 2.44-2.84 | 10 | 4.0 / 3.5 / 1.0 mrad | ENC-09 | ENC-11 | New, not judged before. In the 2026-10-02 visit prep (not in CSV yet). Same as GK but near-zero expansion. Length 1920 mm. |
| RSF Elektronik | MC 15 B + MK (steel tape) | [PDF](https://www.rsf.at/wp-content/uploads/2024/02/MC15-EN.pdf) | absolute | optical | 0.1 or 0.05 um (BiSS-C) | +/-3 (calc); grade +/-15 um/m | 10 (600 m/min) | BiSS-C (also EnDat, others) | +/-1 (approx) | 13.5 | 14.8 | 36 | 0.45 | 8 | 20 / 20 / 20 mrad | ENC-05 | ENC-11 | In CSV as MC 15 order code B. Visit prep: fails our filter at about +/-1 um. |
| RSF Elektronik | MC 15 B + MP (tape in Al carrier) | [PDF](https://www.rsf.at/wp-content/uploads/2024/02/MC15-EN.pdf) | absolute | optical | 0.1 or 0.05 um (BiSS-C) | +/-3 (calc); grade +/-15 um/m | 10 (600 m/min) | BiSS-C (also EnDat, others) | +/-1 (approx) | 13.5 | 14.8 | 36 | 2.6 | 16 | 20 / 20 / 20 mrad | ENC-05, ENC-09, ENC-10 | ENC-11 | Same head as MK. Carrier too big. Fails on error as before. |
| RSF Elektronik | MC 15 B + GK (glass, tape) | [PDF](https://www.rsf.at/wp-content/uploads/2024/02/MC15-EN.pdf) | absolute | optical | 0.1 or 0.05 um (BiSS-C) | +/-1 (calc); grade +/-5 um/m | 10 (600 m/min) | BiSS-C (also EnDat, others) | +/-1 (approx) | 13.5 | 14.8 | 36 | 2.5 | 10 | 20 / 20 / 20 mrad | ENC-05, ENC-09 | ENC-11 | Accuracy is good, but error ~1 um and the glass is too thick. |
| RSF Elektronik | MC 15 B + BK (glass ceramic, tape) | [PDF](https://www.rsf.at/wp-content/uploads/2024/02/MC15-EN.pdf) | absolute | optical | 0.1 or 0.05 um (BiSS-C) | +/-1 (calc); grade +/-5 um/m | 10 (600 m/min) | BiSS-C (also EnDat, others) | +/-1 (approx) | 13.5 | 14.8 | 36 | 2.6 | 10 | 20 / 20 / 20 mrad | ENC-05, ENC-09 | ENC-11 | Same as GK. Length 1920 mm. |
| RSF Elektronik | MS 25 MO/MK (steel tape) | [PDF](https://www.rsf.at/wp-content/uploads/2024/06/MS25-EN.pdf) | incremental | optical | 40 um period; 1 Vpp: set by interpolation | +/-1 (calc); grade +/-5 um/m (or 15) | 10 (1 Vpp) | 1 Vpp or TTL | +/-0.065 (typ, pk-pk) | 21 | 14.59 | 55 | 0.84 | 12.7 | 5.0 / 3.6 / 1.0 mrad | ENC-06, ENC-08, ENC-10 | ENC-11 | New, not judged before. Head is too big. |
| RSF Elektronik | MS 25 GK/BK (glass, tape) | [PDF](https://www.rsf.at/wp-content/uploads/2024/06/MS25-EN.pdf) | incremental | optical | 40 um period; 1 Vpp: set by interpolation | +/-0.6 (calc); grade +/-3 um/m (or 5) | 10 (1 Vpp) | 1 Vpp or TTL | +/-0.065 (typ, pk-pk) | 21 | 15.75-17.29 | 55 | n/c (tape 0.64 + glass) | 12.55 | 5.0 / 3.6 / 1.0 mrad | ENC-06, ENC-08, ENC-10 | ENC-09, ENC-11 | New, not judged before. Head too big; glass is thick, so ENC-09 likely fails. |
| RSF Elektronik | MS 25 MA/MS, MP, MT, GA (merged) | [PDF](https://www.rsf.at/wp-content/uploads/2024/06/MS25-EN.pdf) | incremental | optical | 40 um period; 1 Vpp: set by interpolation | +/-1 (calc, steel) or +/-0.6 (glass) | 10 (1 Vpp) | 1 Vpp or TTL | +/-0.065 (typ, pk-pk) | 21 | n/c | 55 | n/c | n/c | n/c | ENC-06, ENC-08 | ENC-07, ENC-09, ENC-10, ENC-11 | New, not judged before. Carrier drawings not read. Head is too big anyway. |
| RSF Elektronik | MS 45 MO/MK, MP | [PDF](https://www.rsf.at/wp-content/uploads/downloads/MS45-EN.pdf) | incremental | optical | 200 um period; 1 Vpp: set by interpolation; TTL steps n/c | +/-3 (calc); grade +/-15 um/m | 15 (1 Vpp) | 1 Vpp or TTL | +/-1 (typ, pk-pk) | 21 | 13.59 | 50 | 0.84 (MK) | 12.7 | 12.0 / 8.0 / 8.0 mrad | ENC-05, ENC-06, ENC-08, ENC-10 | ENC-11 | New, not judged before. Coarse 200 um period gives large error; head too big. |
| Numerik Jena | LIA 20 + SINGLEFLEX/DOUBLEFLEX tape | [PDF](https://www.numerikjena.com/fileadmin/Redaktion/004__PDF-Dokumente/LIA20_21/OI_LIA_082025_en.pdf) | incremental | optical | 20 um period; 1 Vpp: set by interpolation (RS-422 to 0.05 um) | +/-5 um class OK (calc from maker definition; classes 1/2/3/5) | 10 (1 Vpp) | 1 Vpp | n/c | 13.2 | 12.4 | 34 | 0.45 (0.7 DOUBLEFLEX) | 8 | 2.0 deg / 0.25 deg / 0.15 deg (roll/pitch/yaw) | none | ENC-05, ENC-11 | In the visit prep note (LIA 20). Incremental. No interpolation error found in the manual. |
| Numerik Jena | LIA 21 (as LIA 20 plus switch sensor) + same tape | [PDF](https://www.numerikjena.com/fileadmin/Redaktion/004__PDF-Dokumente/LIA20_21/OI_LIA_082025_en.pdf) | incremental | optical | 20 um period; 1 Vpp: set by interpolation (RS-422 to 0.05 um) | +/-5 um class OK (calc from maker definition; classes 1/2/3/5) | 10 (1 Vpp) | 1 Vpp | n/c | 13.2 | 12.4 | 34 | 0.45 (0.7 DOUBLEFLEX) | 8 | 2.0 deg / 0.25 deg / 0.15 deg (roll/pitch/yaw) | none | ENC-05, ENC-11 | Same numbers as LIA 20. Switch sensor is extra. New, not judged before. |
| Numerik Jena | Kit L2 bare sensor + SINGLEFLEX/DOUBLEFLEX tape | [PDF](https://www.numerikjena.com/fileadmin/Redaktion/004__PDF-Dokumente/KitL2_4/OI_Kit_L_082025_en.pdf) | incremental | optical | 20 um period; 1 Vpp: set by interpolation (RS-422 to 0.05 um) | +/-5 um class OK (calc from maker definition) | 10 (1 Vpp, no op-amp); 4 with std op-amp | 1 Vpp | n/c | 8 | 1.8 (bare, no frame) | 20 | 0.45 (0.7 DOUBLEFLEX) | 8 | 2.0 deg / 0.25 deg / 0.15 deg (roll/pitch/yaw) | none | ENC-05, ENC-11 | New, not judged before. Needs a customer frame. Frame adds height. |
| Numerik Jena | Kit L4 bare sensor + SINGLEFLEX tape (ML max 400 mm) | [PDF](https://www.numerikjena.com/fileadmin/Redaktion/004__PDF-Dokumente/KitL2_4/OI_Kit_L_082025_en.pdf) | incremental | optical | 20 um period; 1 Vpp: set by interpolation (RS-422 to 0.05 um) | +/-5 um class OK (calc from maker definition) | 10 (1 Vpp, no op-amp); 4 with std op-amp | 1 Vpp | n/c | 8 | 1.8 (bare, no frame) | 13 | 0.45 | 8 | 2.0 deg / 0.25 deg / 0.3 deg (roll/pitch/yaw) | none | ENC-05, ENC-11 | New, not judged before. One-field scanning. Tape length max 400 mm. |
| Numerik Jena | LIK 21 + SINGLEFLEX/DOUBLEFLEX tape | [PDF](https://www.numerikjena.com/fileadmin/Redaktion/004__PDF-Dokumente/LIK2x_4x/UM_LIK_eng.pdf) | incremental | optical | 20 um period; 1 Vpp: set by interpolation (RS-422 to 0.05 um) | +/-5 um class OK (calc from maker definition) | 10 (1 Vpp); 4 with std op-amp | 1 Vpp | n/c | 11 | 6 | 30 | 0.45 (0.7 DOUBLEFLEX) | 8 | n/c / n/c / n/c | none | ENC-05, ENC-11 | New, not judged before. Older manual, not on the LIK page now. |
| Numerik Jena | LIK 22 + SINGLEFLEX/DOUBLEFLEX tape | [PDF](https://www.numerikjena.com/fileadmin/Redaktion/004__PDF-Dokumente/LIK2x_4x/UM_LIK_eng.pdf) | incremental | optical | 20 um period; 1 Vpp: set by interpolation (RS-422 to 0.05 um) | +/-5 um class OK (calc from maker definition) | 10 (1 Vpp); 4 with std op-amp | 1 Vpp | n/c | 11 | 7 | 40 | 0.45 (0.7 DOUBLEFLEX) | 8 | n/c / n/c / n/c | ENC-08 | ENC-05, ENC-11 | New, not judged before. Head is 40 mm long, limit is under 40. |
| Numerik Jena | LIK 23 + SINGLEFLEX/DOUBLEFLEX tape | [PDF](https://www.numerikjena.com/fileadmin/Redaktion/004__PDF-Dokumente/LIK2x_4x/UM_LIK_eng.pdf) | incremental | optical | 20 um period; 1 Vpp: set by interpolation (RS-422 to 0.05 um) | +/-5 um class OK (calc from maker definition) | 10 (1 Vpp); 4 with std op-amp | 1 Vpp | n/c | 11 | 9.5 | 32 | 0.45 (0.7 DOUBLEFLEX) | 8 | n/c / n/c / n/c | none | ENC-05, ENC-11 | New, not judged before. Older manual. |
| Numerik Jena | LIK 41 + SINGLEFLEX tape (ML max 400 mm) | [PDF](https://www.numerikjena.com/fileadmin/Redaktion/004__PDF-Dokumente/LIK2x_4x/UM_LIK_41_eng.pdf) | incremental | optical | 20 um period; 1 Vpp: set by interpolation (RS-422 to 0.05 um) | +/-5 um class OK (calc from maker definition) | 10 (1 Vpp); 4 with std op-amp | 1 Vpp | n/c | 11 | 6 | 24 | 0.45 (0.7 DOUBLEFLEX) | 8 | n/c / n/c / n/c | none | ENC-05, ENC-11 | New, not judged before. One-field scanning. Tape length max 400 mm. |
| Numerik Jena | LIK vacuum versions of LIK 21/22/23/41 (merged, UHV) + SINGLEFLEX tape | [PDF](https://www.numerikjena.com/fileadmin/Redaktion/004__PDF-Dokumente/LIK2x_4x/UM_LIK_vac_eng.pdf) | incremental | optical | 20 um period; 1 Vpp: set by interpolation (RS-422 to 0.05 um) | +/-5 um class OK (calc from maker definition) | 10 (1 Vpp); 4 with std op-amp | 1 Vpp | n/c | 11 | 6 / 7 / 9.5 / 6 | 30 / 40 / 32 / 24 | n/c (0.45 non-vac) | n/c | n/c / n/c / n/c | ENC-08 (LIK 22 only) | ENC-05, ENC-09, ENC-10, ENC-11 | New, not judged before. Vacuum parts are a niche. Numbers per head type, same as above. |
| Numerik Jena | LIKgo (LIKG1) + MI SINGLEFLEX tape | [PDF](https://www.numerikjena.com/fileadmin/Redaktion/004__PDF-Dokumente/LIKgo_select/UM_LIKgo_en_2022_web.pdf) | incremental | optical | 20 um period; 1 Vpp: set by interpolation (RS-422 to 78 nm) | +/-3 or +/-5 um/m grade; +/-5 um OK (calc from maker definition) | 10 (1 Vpp) | 1 Vpp (or RS-422/TTL) | 0.085 (typ max, x64) | 13 | 7.5 | 28 | 0.45 | 8 | 1.0 deg / 1.0 deg / 0.2 deg (roll/pitch/yaw) | none | ENC-11 | In the visit prep note (LIKgo). Newer, smaller head, looser tolerances. Tape length max 2490 mm. |
| Numerik Jena | LIKselect A, bare sensor + MI tape | [PDF](https://www.numerikjena.com/fileadmin/Redaktion/004__PDF-Dokumente/LIKgo_select/UM_LIKselect_en_2022_web.pdf) | incremental | optical | 20 um period; 1 Vpp: set by interpolation (RS-422/TTL to 78 nm) | +/-3 or +/-5 um/m grade; +/-5 um OK (calc from maker definition) | 10 (1 Vpp) | 1 Vpp (or RS-422/TTL) | 0.085 (typ max, x64) | 8 (maker W) | 2.2 (maker D) | 16 (inferred from maker H) | 0.45 | 8 | 1.0 deg / 1.0 deg / 0.2 deg (roll/pitch/yaw) | none | ENC-11 | New, not judged before. Maker gives W x H x D = 8 x 16 x 2.2. Axis mapping is my reading. |
| Numerik Jena | LIKselect frame B angle + MI tape | [PDF](https://www.numerikjena.com/fileadmin/Redaktion/004__PDF-Dokumente/LIKgo_select/UM_LIKselect_en_2022_web.pdf) | incremental | optical | 20 um period; 1 Vpp: set by interpolation (RS-422/TTL to 78 nm) | +/-3 or +/-5 um/m grade; +/-5 um OK (calc from maker definition) | 10 (1 Vpp) | 1 Vpp (or RS-422/TTL) | 0.085 (typ max, x64) | 13 (maker W) | 8.2 (maker D) | 20.5 (inferred from maker H) | 0.45 | 8 | 1.0 deg / 1.0 deg / 0.2 deg (roll/pitch/yaw) | none | ENC-11 | New, not judged before. Maker gives 13 x 20.5 x 8.2. Axis mapping is my reading. |
| Numerik Jena | LIKselect frame C plate + MI tape | [PDF](https://www.numerikjena.com/fileadmin/Redaktion/004__PDF-Dokumente/LIKgo_select/UM_LIKselect_en_2022_web.pdf) | incremental | optical | 20 um period; 1 Vpp: set by interpolation (RS-422/TTL to 78 nm) | +/-3 or +/-5 um/m grade; +/-5 um OK (calc from maker definition) | 10 (1 Vpp) | 1 Vpp (or RS-422/TTL) | 0.085 (typ max, x64) | 15 (maker W) | 2.5 (maker D) | 20.5 (inferred from maker H) | 0.45 | 8 | 1.0 deg / 1.0 deg / 0.2 deg (roll/pitch/yaw) | ENC-06 | ENC-11 | New, not judged before. Width 15 is not under 15. Axis mapping is my reading. |
| Numerik Jena | LAKgo (LAKG2) + MA tape, +/-3 um class | [PDF](https://www.numerikjena.com/fileadmin/Redaktion/004__PDF-Dokumente/LAKgo_LAKselect/LAKgo_PI_1504435_Ver00_02_en.pdf) | absolute | optical | 78.125 nm (BiSS C); 10 nm (EnDat 2.2) | +/-3 um grade (per 1 m); +/-3 um over 200 mm (calc from maker definition) | 10 (maker gives no resolution link) | BiSS-C (unidirectional), also EnDat 2.2, SSI, 1 Vpp | 0.05 rms typ (0.03 rms ideal) | 11.5 | 10.5 | 33.5 | 0.45 (0.7 DOUBLEFLEX) | 8 | 0.5 deg / 0.5 deg / 0.25 deg (roll/pitch/yaw) | none | ENC-03, ENC-11 | CSV row "LIA / LAK series" was unclear on LAK. LAK is the absolute one. Speed at this resolution is not stated. |
| Numerik Jena | LAKselect (LAKS2) standard plate frame + MA tape | [PDF](https://www.numerikjena.com/fileadmin/Redaktion/004__PDF-Dokumente/LAKgo_LAKselect/LAKselect_PI_1510462_Ver00_01_en.pdf) | absolute | optical | 78.125 nm (BiSS C); 10 nm (EnDat 2.2) | +/-3 um grade (per 1 m); +/-3 um over 200 mm (calc from maker definition) | 10 (maker gives no resolution link) | BiSS-C (unidirectional), also EnDat 2.2, SSI, 1 Vpp | 0.05 rms typ (0.03 rms ideal) | 16 | 4.5 | 37 | 0.45 (0.7 DOUBLEFLEX) | 8 | 0.5 deg / 0.5 deg / 0.25 deg (roll/pitch/yaw) | ENC-06 | ENC-03, ENC-11 | New, not judged before. Frame is 16 wide. Sensor glass is 18.7 x 9. |
| Numerik Jena | LAK (older manual, same head as LAKgo) + MA tape | [PDF](https://www.numerikjena.com/fileadmin/Redaktion/004__PDF-Dokumente/LAK_KitLA/LAK_BA_1464148_Ver00_02_en.pdf) | absolute | optical | 78.125 nm (BiSS C); 10 nm (EnDat 2.2) | +/-3 um grade (per 1 m); +/-3 um over 200 mm (calc from maker definition) | 10 (maker gives no resolution link) | BiSS-C (unidirectional), also EnDat 2.2, SSI, 1 Vpp | 0.05 rms typ (0.03 rms ideal) | 11.5 | 10.5 | 33.5 | 0.45 (0.7 DOUBLEFLEX) | 8 | 0.5 deg / 0.5 deg / 0.25 deg (roll/pitch/yaw) | none | ENC-03, ENC-11 | CSV row "LIA / LAK series" covers this. Likely replaced by LAKgo. Tape up to 1.2 m. |
| Numerik Jena | Kit LA (older manual) standard frame + MA tape | [PDF](https://www.numerikjena.com/fileadmin/Redaktion/004__PDF-Dokumente/LAK_KitLA/KitLA_BA_1464056_Ver00_02_en.pdf) | absolute | optical | 78.125 nm (BiSS C); 10 nm (EnDat 2.2) | +/-3 um grade (per 1 m); +/-3 um over 200 mm (calc from maker definition) | 10 (maker gives no resolution link) | BiSS-C (unidirectional), also EnDat 2.2, SSI, 1 Vpp | 0.05 rms typ (0.03 rms ideal) | 16 | 4.5 | 37 | 0.45 (0.7 DOUBLEFLEX) | 8 | 0.5 deg / 0.5 deg / 0.25 deg (roll/pitch/yaw) | ENC-06 | ENC-03, ENC-11 | New, not judged before. Likely replaced by LAKselect. |
| AMO | LMKA 2010 (head, Design 20) + LMBA 2010 tape | [PDF](https://www.amo.at/wp-content/uploads/2024/08/1255440-01-A-02_Linear-Encoders_EN-3.pdf) | absolute | inductive | 0.1 um step (HA); 1 or 0.25 um std | +/-4 (calc), grade +/-20 um/m; +/-0.6 (calc) after comp. | 20 (max; not tied to step) | BiSS-C (also EnDat, Fanuc, Mitsubishi, SSI+1 Vpp) | +/-0.5 (HA); +/-2 std | 26 | 22.1 | 50 | 0.8 | 13.95 | n/c | ENC-05, ENC-06, ENC-07, ENC-08, ENC-10 | ENC-11 | Earlier verdict: "viable only with calibration". Fails on head size and periodic error. Same numbers as 2018 brochure. |
| AMO | LMK 1005 (Design 10/12 mini head) + LMB 1005 tape; HA | [PDF](https://www.amo.at/wp-content/uploads/2024/08/1255440-01-A-02_Linear-Encoders_EN-3.pdf) | incremental | inductive | 1 Vpp: 10 um period (HA), set by interpolation; TTL 0.05 um | +/-4 (calc), grade +/-20 um/m; +/-0.6 (calc) after comp. | 4 (calc: 400 kHz x 10 um); 10 max | 1 Vpp (or TTL; external electronics) | +/-0.3 (HA); +/-1.5 std | 12 | 12 | 35.5 | 0.6 | 9.95 | n/c (air gap 0.10 +/-0.05 mm only) | none (std head fails ENC-05) | ENC-11 | Earlier verdict: "WEAK" on grating period error; talk to Heidenhain on 2026-10-05. Only AMO head that passes all size limits. 500 um period needs heavy interpolation. |
| AMO | LMK 2005 (Design 20 / 21 flat head, merged) + LMB 1005 tape; HA | [PDF](https://www.amo.at/wp-content/uploads/2024/08/1255440-01-A-02_Linear-Encoders_EN-3.pdf) | incremental | inductive | 1 Vpp: 10 um period (HA), set by interpolation; TTL 0.05 um | +/-4 (calc), grade +/-20 um/m | 4 (calc: 400 kHz x 10 um); 10 max | 1 Vpp (or TTL) | +/-0.3 (HA); +/-1.5 std | 16 (D20) / 30 (D21) | 29 (D20) / 13.5 (D21) | 73 (D20) / 49 (D21) | 0.6 | 9.95 | n/c (air gap 0.10 +/-0.05 mm only) | ENC-06, ENC-07, ENC-08 | ENC-11 | New, not judged before. Same electrics as LMK 1005 but the housing is too large. |
| AMO | LMK 1010 (Design 10/12 mini head) + LMB 1010 tape; HA | [PDF](https://www.amo.at/wp-content/uploads/2024/08/1255440-01-A-02_Linear-Encoders_EN-3.pdf) | incremental | inductive | 1 Vpp: 20 um period (HA), set by interpolation; TTL 0.1 um | +/-4 (calc), grade +/-20 um/m; +/-0.6 (calc) after comp. | 8 (calc: 400 kHz x 20 um); 20 max | 1 Vpp (or TTL; external electronics) | +/-0.5 (HA); +/-2 std | 12 | 12 | 35.5 | 0.8 | 9.95 | n/c (air gap 0.15 +/-0.10 mm only) | ENC-05 | ENC-11 | New, not judged before. Small head, but periodic error is above the limit. |
| AMO | LMK 2010 (Design 20 / 21 flat head, merged) + LMB 1010 tape; HA | [PDF](https://www.amo.at/wp-content/uploads/2024/08/1255440-01-A-02_Linear-Encoders_EN-3.pdf) | incremental | inductive | 1 Vpp: 20 um period (HA), set by interpolation; TTL 0.1 um | +/-4 (calc), grade +/-20 um/m | 8 (calc: 400 kHz x 20 um); 20 max | 1 Vpp (or TTL) | +/-0.5 (HA); +/-2 std | 16 (D20) / 30 (D21) | 29 (D20) / 13.5 (D21) | 73 (D20) / 49 (D21) | 0.8 | 9.95 | n/c (air gap 0.15 +/-0.10 mm only) | ENC-05, ENC-06, ENC-07, ENC-08 | ENC-11 | New, not judged before. D21 dimensions taken from the 2005 drawing layout, not checked on its own page. |
| AMO | LMK 2030 (Design 20 / 21) + LMB 1030 tape | [PDF](https://www.amo.at/wp-content/uploads/2024/08/1255440-01-A-02_Linear-Encoders_EN-3.pdf) | incremental | inductive | 1 Vpp: 3000 to 93.75 um period; TTL step 3 um | +/-10 (calc), grade +/-50 um/m; +/-2 (calc) after comp. | 60 max | 1 Vpp (or TTL) | +/-4 | 16 (D20) / 30 (D21) | 29 (D20) / 13.5 (D21) | 73 (D20) / 49 (D21) | 0.8 | 13.95 | n/c (air gap 0.40 +/-0.20 mm only) | ENC-01, ENC-02, ENC-05, ENC-06, ENC-07, ENC-08, ENC-10 | ENC-11 | New, not judged before. Coarse 3000 um grating. Not suited. |
| AMO | LMT 4005 / 4010 / 4030 and LMTA 4010 (scale in steel carrier, merged) | [PDF](https://www.amo.at/wp-content/uploads/2024/08/1255440-01-A-02_Linear-Encoders_EN-3.pdf) | incremental (LMT) / absolute (LMTA) | inductive | n/c (scale only; see head rows) | +/-4 (calc) for +/-20 um/m grade; +/-10 (calc) for +/-50 um/m | n/c (set by head) | n/c (scale only) | n/c (scale only) | n/c | n/c | n/c | 5.1 | 14 (LMT 4005/4010) / 18 (4030, LMTA) | n/c | ENC-09, ENC-10 | ENC-02 (head dependent), ENC-11 | New, not judged before. Carrier is too tall and too wide. Use the LMB tape instead. |
| AMO | LMK 3010 + LMF 3010 / LMKA 3010 + LMFA 3010 (guided rail, not open) | [PDF](https://www.amo.at/wp-content/uploads/2024/08/1255440-01-A-02_Linear-Encoders_EN-3.pdf) | incremental and absolute | inductive | 1 Vpp 20 um period (HA) or TTL 0.1 um; absolute 0.1 um | +/-4 (calc), grade +/-20 um/m | 5 (limited by mechanics; 3 in 2018 selection table) | 1 Vpp / TTL; BiSS-C (LMKA) | +/-0.5 (HA); +/-2 std | 44 | about 40.75 | 75 | 16.4 (LMF) / 20.7 (LMFA) | 15 (LMF) / 20 (LMFA) | n/c | ENC-05, ENC-06, ENC-07, ENC-08, ENC-09, ENC-10 | ENC-11 | Earlier verdict: "viable only with calibration" for LMKA 3010 (CSV row). Guided rail, listed for completeness. |
| LAMOTION | AHBS BiSS-C head + AHLZ steel tape 25 um | [PDF](http://www.lamotion.cn//file/pdf/AHBS_ReadHead(BISS_C)_V1.01.pdf) | absolute | optical | 20 nm (also 50/100/500 nm) | +/-2 (calc), grade +/-10 um/m | 15 (all resolutions) | BiSS-C | +/-0.075 | 16.5 | 18.4 | 36 | 0.4 (0.2 tape + 0.2 glue) | 8 | +/-0.25 / +/-0.25 / +/-0.5 deg (roll/pitch/yaw) | ENC-06, ENC-07 | ENC-11 | New, not judged before. Same head as the AHBS+ALi row; only the tape differs. Ride height 0.8 +/-0.075 mm. |
| LAMOTION | AHBS BiSS-C head + ALi Invar tape 25 um | [PDF](http://www.lamotion.cn//file/pdf/AHBS_ReadHead(BISS_C)_V1.01.pdf) [PDF](http://www.lamotion.cn//file/pdf/ALi_%20Low-expansion%20linear%20encoder_V1.02.pdf) | absolute | optical | 20 nm (also 50/100/500 nm) | n/c (line accuracy +/-1 or +/-2 um per 1 m) | 15 (all resolutions) | BiSS-C | +/-0.075 | 16.5 | 18.4 | 36 | 1.6 (+0.4 glue) | 14.9 | +/-0.25 / +/-0.25 / +/-0.5 deg (roll/pitch/yaw) | ENC-06, ENC-07, ENC-09, ENC-10 | ENC-02, ENC-11 | Earlier: STRONGEST NEW CANDIDATE, blocked on price only. The sheets now show head and tape are too big, and the two sheets differ on accuracy. |
| LAMOTION | AHBS Panasonic head + AHLZ or ALi tape | [PDF](http://www.lamotion.cn//file/pdf/AHBS_ReadHead(Panasonic)_V1.01.pdf) | absolute | optical | 20 nm (also 50/100/500 nm) | +/-2 (calc) with AHLZ, grade +/-10 um/m | 15 | Panasonic serial (not BiSS-C) | +/-0.075 | 16.5 | 18.4 | 36 | 0.4 AHLZ / 1.6 ALi | 8 AHLZ / 14.9 ALi | n/c in this sheet (BiSS-C sheet: 0.25 / 0.25 / 0.5 deg) | ENC-04, ENC-06, ENC-07 | ENC-11 | New, not judged before. CSV row notes a Panasonic version is also sold. Same housing as the BiSS-C head. |
| LAMOTION | ABS BiSS-C head + ALZ steel tape 50 um | [PDF](http://www.lamotion.cn//file/pdf/ABS_ReadHead(BISS_C)_)_V1.44.pdf) | absolute | optical | 50 nm (also 100/500 nm) | +/-2 (calc), grade +/-10 um/m | 15 (all resolutions) | BiSS-C | +/-0.15 | 16.5 | 18.4 | 36 | 0.4 (0.2 tape + 0.2 glue) | 8 | +/-0.5 / +/-0.5 / +/-0.5 deg (roll/pitch/yaw) | ENC-06, ENC-07 | ENC-11 | Earlier: STRONG, cheaper LAMOTION option. Head is 16.5 wide and 18.4 high, so it fails two size limits. Ride height 0.8 +/-0.15 mm. |
| LAMOTION | ABS Panasonic head + ALZ steel tape | [PDF](http://www.lamotion.cn//file/pdf/ABS_ReadHead(Panasonic)_V1.44.pdf) | absolute | optical | 50 nm (also 100/500 nm) | +/-2 (calc), grade +/-10 um/m | 15 | Panasonic serial (not BiSS-C) | +/-0.15 | 16.5 | 18.4 | 36 | 0.4 | 8 | +/-0.5 / +/-0.5 / +/-0.5 deg (from text) | ENC-04, ENC-06, ENC-07 | ENC-11 | New, not judged before. Same hardware as the ABS BiSS-C row, other protocol. |
| LAMOTION | COIN C4 TTL head + CLS steel tape 40 um | [PDF](http://www.lamotion.cn//file/pdf/COIN_ReadHead_V2.25.pdf) | incremental | optical | 0.1 um (TTL; also 0.2/0.5/1/5 um) | +/-2 (calc), grade +/-10 um/m | 2 at 0.1 um (4 at 0.2 um, 8 at 0.5 um) | Differential TTL | +/-0.055 | 13.6 | 6.1 or 6.5 | 32 | 0.4 (incl. glue) | n/c | +/-1 / +/-1 / +/-1 deg (roll/pitch/yaw) | ENC-03, ENC-04 | ENC-10, ENC-11 | Earlier (Render row): PARTIAL, fits technically, buy from LAMOTION. TTL is not allowed and speed at 0.1 um is only 2 m/s. |
| LAMOTION | COIN C4 SinCos 1 Vpp head + CLS tape (merged: tape as above) | [PDF](http://www.lamotion.cn//file/pdf/COIN_ReadHead_V2.25.pdf) | incremental | optical | 40 um period; 1 Vpp: set by interpolation | +/-2 (calc), grade +/-10 um/m | 8 (1 Vpp) | 1 Vpp sin/cos (+ REF) | +/-0.055 | 13.6 | 6.1 or 6.5 | 32 | 0.4 (incl. glue) | n/c | +/-1 / +/-1 / +/-1 deg (roll/pitch/yaw) | none by a number | ENC-10, ENC-11 | Earlier (Render row): PARTIAL, fits technically but Chinese LAMOTION part. Best size fit of the open LAMOTION heads. Position tolerance 0.8 +/-0.08 mm. |
| LAMOTION | D2 TTL head + D2S steel tape 20 um | [PDF](http://www.lamotion.cn//file/pdf/D2_ReadHead_V2.26.pdf) | incremental | optical | 0.5 um (TTL; also 1 um) | n/c (grade +/-15 um; no length given) | 2.5 | Differential TTL | +/-0.04 | 16.4 | 14.4 | 36 | 0.2 (0.1 tape + 0.1 glue) | 6 | +/-1 / +/-1 / +/-1 deg (roll/pitch/yaw) | ENC-01, ENC-03, ENC-04, ENC-06 | ENC-02, ENC-11 | New, not judged before. Older TTL head; fails resolution, speed, output and width. |
| LAMOTION | AM4 TTL head + M4 steel tape 40 um | [PDF](http://www.lamotion.cn//file/pdf/AM4_GratingRules_V1.54.pdf) | incremental | optical | 0.5 um (TTL; also 1 um) | +/-2 (calc), grade +/-10 um/m | 2.5 | Differential TTL | +/-0.08 | 13 | 10.3 | 34 | 0.2 (incl. glue) | 6 | n/c | ENC-01, ENC-03, ENC-04 | ENC-11 | New, not judged before. Small head, but TTL only and slow. |
| LAMOTION | RU2 TTL head + RUS steel tape 20 um (RUS-127 slot tape also) | [PDF](http://www.lamotion.cn//file/pdf/RU2_%20Readhead_V2.22.pdf) | incremental | optical | 0.1 um (TTL; down to 20 nm) | +/-1 (calc), grade +/-5 um/m | 2 at 0.1 um with 5 MHz clock (12 nominal) | Differential TTL | +/-0.04 | 16.4 | 14.4 | 36 | 0.4 (0.2 tape + 0.2 glue) | 8 (RUS-127: 12.7) | +/-1 / +/-1 / +/-1 deg (roll/pitch/yaw) | ENC-03, ENC-04, ENC-06 | ENC-11 | New, not judged before. Best accuracy of the TTL heads, but TTL only and 16.4 wide. Ride height 2.1 +/-0.1 mm. |
| LAMOTION | RX2 TTL head + RXS steel tape 20 um | [PDF](http://www.lamotion.cn//file/pdf/RX2_GratingRules_V2.57.pdf) | incremental | optical | 0.1 um (TTL; down to 10 nm) | +/-1 (calc), grade +/-5 um/m | 2 at 0.1 um (5 at 0.5 um and up) | Differential TTL | +/-0.04 | 16.4 | 14.4 | 36 | 0.4 (incl. glue) | 8 | +/-1 / +/-1 / +/-1 deg (roll/pitch/yaw) | ENC-03, ENC-04, ENC-06 | ENC-11 | New, not judged before. Same head as the 1 Vpp row, TTL option. |
| LAMOTION | RX2 SinCos 1 Vpp head + RXS steel tape 20 um | [PDF](http://www.lamotion.cn//file/pdf/RX2_GratingRules_V2.57.pdf) | incremental | optical | 20 um period; 1 Vpp: set by interpolation | +/-1 (calc), grade +/-5 um/m | 5 (1 Vpp) | 1 Vpp sin/cos (+ REF) | +/-0.04 | 16.4 | 14.4 | 36 | 0.4 (incl. glue) | 8 | +/-1 / +/-1 / +/-1 deg (roll/pitch/yaw) | ENC-06 | ENC-11 | New, not judged before. Only fails head width (16.4 mm). Scale size is from the drawing. |
| LAMOTION | RX2 head + RXi Invar tape 20 um (TTL or 1 Vpp) | [PDF](http://www.lamotion.cn//file/pdf/RXi_%20Low-expansion%20linear%20encoder_V1.02.pdf) [PDF](http://www.lamotion.cn//file/pdf/RX2_GratingRules_V2.57.pdf) | incremental | optical | TTL 10 nm to 1 um or 20 um 1 Vpp period | n/c (line accuracy +/-1 um per 1 m) | 4 (RXi sheet) or 5 (RX2 sheet) | Differential TTL or 1 Vpp | +/-0.04 | 16.4 | 14.4 | 36 | 1.6 (+0.4 glue) | 14.9 | +/-1 / +/-1 / +/-1 deg (roll/pitch/yaw) | ENC-06, ENC-09, ENC-10 | ENC-02, ENC-11 | New, not judged before. Invar tape is too thick and wide. The two sheets give different speeds. |
| ARCS Precision Technology | LDOE / Standard / SLIM | [page](https://www.arcs.tw/product_d.php?pid=38) | incremental | optical (glass, sealed) | n/c | n/c (5+L/200 um) | n/c | TTL; RS-422 | n/c | n/c | n/c | n/c | n/c | n/c | n/c | ENC-04 | ENC-01, ENC-02, ENC-03, ENC-05, ENC-06, ENC-07, ENC-08, ENC-09, ENC-10, ENC-11 | Ruled out: sealed digital readout scales. No 1 Vpp or BiSS-C. Taiwanese. |
| ATO | ATO-LE-AGD200 | n/c | absolute | optical | 20 to 29 bit (um n/c) | 1.1 (calc, +/-5 um/m grating) | n/c | BiSS-C or SSI | n/c | 15 | 14 | 36 | n/c | n/c | n/c | ENC-06 | ENC-01, ENC-02, ENC-03, ENC-05, ENC-09, ENC-10, ENC-11 | Weak. Cheapest open option, but the maker is never named. Repeatability +/-1 um. Price USD 572.54 for the head. |
| ATTO Motion | ALR + ALE-G glass / ALE-S steel scale | n/c | absolute | optical | 12.5 nm | n/c | 50 | BiSS-C; also A/B/Z | <0.025 | 13.1 | 10 | 36 | n/c | n/c | n/c | none recorded | ENC-02, ENC-09, ENC-10, ENC-11 | DROPPED 2026-09-28. The encoder cannot be found again. Earlier verdict: promising but unproven. Best per-period figure found. Scale pitch 204.8 um. Drawing and table sizes do not agree. |
| Broadcom | AEDR-9830-100 chip (no scale sold) | [PDF](https://docs.broadcom.com/docs/AEDR-9830-DS) | incremental | optical | 5 um digital; finer with ext. interpolation | n/c | n/c | analog sin/cos or digital A/B/I | n/c | 4 | 1.05 | 4 | n/c | n/c | n/c | none recorded | ENC-01, ENC-02, ENC-03, ENC-04, ENC-05, ENC-09, ENC-10, ENC-11 | Chip only, USD 38.09. Scale pitch 79.8 um. A do-it-yourself head would need a made-to-order scale. Not clear that analog output is 1 Vpp. Analog output meets the per-period rule; digital does not. |
| Broadcom | HEDS-9200 transmissive module | [PDF](https://docs.broadcom.com/docs/AV02-3653EN) | incremental | optical | n/c | n/c | n/c | digital pulses only | n/c | n/c | n/c | n/c | n/c | n/c | n/c | ENC-04 | ENC-01, ENC-02, ENC-03, ENC-05, ENC-06, ENC-07, ENC-08, ENC-09, ENC-10, ENC-11 | Fails: pulses only. Plastic C-shaped module for film scales. No price on Farnell, withdrawn by TME. |
| CARMAR Accuracy | LAB absolute scale (e.g. LAB001-R010-800) | [PDF](https://www.carmar-tech.com/file/output/1165/%E7%B5%95.pdf) | absolute | optical (glass, sealed) | 0.01 to 5 um | 3 (200 to 600 mm) | n/c | BiSS-C; SSI; optional 1 Vpp | n/c | n/c | n/c | n/c | n/c | n/c | n/c | none recorded | ENC-01, ENC-03, ENC-05, ENC-06, ENC-07, ENC-08, ENC-09, ENC-10, ENC-11 | Ruled out: sealed aluminium housing, IP53. Ask if an open head version exists. 20 um signal period. Scale lengths from 200 mm in 50 mm steps. |
| Celera Motion (MicroE) | Aura / Aura P absolute encoder | [page](https://www.celeramotion.com/microe/products/linear-encoders/nano/aura-series/) | absolute | optical | n/c | 0.22 to 1.1 (calc, glass +/-1 um/m, tape +/-5 um/m) | n/c | BiSS-C | n/c | n/c | n/c | n/c | n/c | n/c | n/c | none recorded | ENC-01, ENC-02, ENC-03, ENC-05, ENC-06, ENC-07, ENC-08, ENC-09, ENC-10, ENC-11 | Corrects an earlier mistake: Celera does sell absolute optical with BiSS-C. Not confirmed that the linear version covers 220 mm. Per-period figure not published. |
| Celera Motion (MicroE) | Mercury II MII5000 series | [page](https://celeramotion.com/microe/products/optical-rotary-encoders/compact/mercury-ii-series-mii5000) | incremental | optical | to 1.2 nm | n/c | n/c | A-quad-B; serial and analog variants | n/c | n/c | 11 (sensor) | n/c | n/c | n/c | n/c | none recorded | ENC-02, ENC-03, ENC-04, ENC-05, ENC-06, ENC-08, ENC-09, ENC-10, ENC-11 | Corrected 2026-09-21. Family is incremental, but the maker also sells absolute Aura. Eligible under the relaxed rule if a 1 Vpp variant exists. |
| Celera Motion (MicroE) | Optira | [PDF](https://inmoco.co.uk/wp-content/uploads/2022/01/Optira-Series-Datasheet.pdf) | incremental | optical | to 5 nm | 1.1 (calc, tape +/-5 um/m) | n/c | digital from head (1 Vpp n/c) | n/c | 13 | 3.7 | 11.4 | n/c | n/c | n/c | none recorded | ENC-03, ENC-04, ENC-05, ENC-09, ENC-10, ENC-11 | Compact head. Interpolation and gain control are inside the head. Glass scales to +/-1 um/m. Link is a distributor copy of the maker data sheet. |
| Changchun Rongde Optics (Roundss) | RLA700 / RLA900 | [page](https://www.roundssencoder.com/pro_li.asp) | absolute | optical | 1 um to 5 nm | n/c | n/c | BiSS-C; SSI; DRIVE-CLiQ; Modbus RTU; RS485 | n/c | n/c | n/c | n/c | n/c | n/c | n/c | none recorded | ENC-01, ENC-02, ENC-03, ENC-05, ENC-06, ENC-07, ENC-08, ENC-09, ENC-10, ENC-11 | Excluded, kept for reference. Hard to trust: they send ambiguous specifications. Three storefronts are one company. |
| Changchun Yuheng Optics | PTL-1A / PTL-1B (glass or steel tape) | n/c | absolute | optical | 0.01 um | n/c | 6 | BiSS-C, 21 to 28 bit | n/c | n/c | n/c | n/c | n/c | n/c | n/c | none recorded | ENC-02, ENC-05, ENC-06, ENC-07, ENC-08, ENC-09, ENC-10, ENC-11 | DROPPED 2026-09-28. Makes only closed encoders. Earlier verdict: Chinese candidate 1. Published lengths only 60 and 160 mm. No accuracy figure. |
| Chieftek Precision | OE1 | [PDF](https://chieftek.com/wp-content/uploads/2026/06/20260610-OE1_en.pdf) | absolute | optical | 17 to 23 bit per turn | n/c | n/c | BiSS-C | n/c | n/c | n/c | n/c | n/c | n/c | n/c | none recorded | ENC-01, ENC-02, ENC-03, ENC-05, ENC-06, ENC-07, ENC-08, ENC-09, ENC-10, ENC-11 | Partial: rotary only (glass discs 18 to 138 mm). Ask about a linear version. Linear ME1 and MSS are magnetic. |
| Delta Electronics | MSR-LEH series | [PDF](https://www.deltaww.com/IA/downloadcenter/catalogue/2.Motion/Linear%20Motion/DELTA_IA-ASM_LU-ECML_C_EN_20220106.pdf) | n/c (absolute not stated) | optical | 4 nm (comm.); 1 or 0.5 um (pulse) | n/c | n/c | Delta servo serial; or TTL A/B/Z | n/c | n/c | n/c | n/c | n/c | n/c | n/c | ENC-04 | ENC-02, ENC-03, ENC-05, ENC-06, ENC-07, ENC-08, ENC-09, ENC-10, ENC-11 | DROPPED 2026-09-28. Proprietary protocol. Earlier verdict: ruled out. Made for linear motor feedback, but the catalogue never says absolute. |
| Dongguan Handing Optical | LS40 read head + L4 steel tape | n/c | incremental | optical | 0.5 um or 1 um | n/c | 4.5 | differential TTL with origin | <0.15 | 12 | 10.6 | 32 | n/c | n/c | n/c | ENC-01, ENC-04 | ENC-02, ENC-09, ENC-10, ENC-11 | Ruled out: TTL only, so a lost edge is a silent error. Rebrands LAMOTION parts, so not a separate source. Has English documents. |
| Dongguan Smartwin (DGSMARTWIN) | SA32 absolute optical linear scale | [page](https://www.zhiyingmotor.com/products/linear-encoder.html) | absolute | optical | 0.5 um and 1 um grades | 1.1 (calc, +/-5 um/m) | 3 (at 0.5 um) | differential RS-422 or EnDat 2.2 | n/c | n/c | n/c | n/c | n/c | n/c | n/c | ENC-03, ENC-04 | ENC-01, ENC-05, ENC-06, ENC-07, ENC-08, ENC-09, ENC-10, ENC-11 | DROPPED 2026-09-28. Output is differential RS-422 or EnDat 2.2 only. Earlier verdict: lead only. Resolution not stated separately. No data sheet download. |
| Easson (Zhuhai) | GS64 / GS65 exposed range; absolute range not identified | n/c | n/c | optical | n/c | n/c | n/c | TTL or differential only | n/c | n/c | n/c | n/c | n/c | n/c | n/c | ENC-04 | ENC-01, ENC-02, ENC-03, ENC-05, ENC-06, ENC-07, ENC-08, ENC-09, ENC-10, ENC-11 | DROPPED 2026-09-28. Output is TTL or differential only. Earlier verdict: unjudgeable. No model data. |
| Fagor Automation | TAA + L2ABC (EXA, adhesive tape) | [PDF](https://fagorautomation.com/wp-content/uploads/cat_encoders_estandar_en.pdf) | absolute | optical | 0.01 um | 2.2 (calc, +/-10 um/m) | n/c | BiSS-C; also SSI | n/c | 19 | n/c | n/c | n/c | n/c | n/c | ENC-06 | ENC-03, ENC-05, ENC-07, ENC-08, ENC-09, ENC-10, ENC-11 | DROPPED 2026-09-28. Read head width 19 mm is too wide. Earlier verdict: strong, best fit on paper. Graduation pitch 40 um. Price not public. |
| Fagor Automation | EXT (exposed absolute, tensioned tape) | [PDF](https://fagorautomation.com/wp-content/uploads/cat_encoders_estandar_en.pdf) | absolute | optical | 0.01 um | 1.1 (calc, +/-5 um/m) | n/c | SSI; BiSS also listed | n/c | 19 | n/c | n/c | n/c | n/c | n/c | ENC-06 | ENC-03, ENC-05, ENC-07, ENC-08, ENC-09, ENC-10, ENC-11 | DROPPED 2026-09-28. Read head width 19 mm is too wide. Earlier verdict: better Fagor choice than EXA. Lengths 140 to 30040 mm. |
| Fagor Automation | ITA / ITT exposed incremental (1 Vpp model ITRP) | [PDF](https://fagorautomation.com/wp-content/uploads/cat_encoders_estandar_en.pdf) | incremental | optical | 5 um to 0.025 um by model | 1.1 (ITT) / 2.2 (ITA) (calc) | n/c | 1 Vpp (ITRP) or TTL | n/c | 19 | n/c | n/c | n/c | n/c | n/c | ENC-06 | ENC-03, ENC-05, ENC-07, ENC-08, ENC-09, ENC-10, ENC-11 | DROPPED 2026-09-28. Read head width 19 mm is too wide. Earlier verdict: in scope under the relaxed rule. All models carry an alarm signal. |
| Givi Misure | GVS 204 / 508 / 608 / 808 | [PDF](https://www.givimisure.it/wp-content/uploads/2022/06/ST04_A57_B_GVS608HI_GIVI_ENG.pdf) | absolute | optical (glass, closed) | to 10 nm (GVS 608) | 5 standard; 3 high accuracy | n/c | SSI; BiSS-C; 1 Vpp optional | n/c | n/c | n/c | n/c | n/c | n/c | n/c | none recorded | ENC-03, ENC-05, ENC-06, ENC-07, ENC-08, ENC-09, ENC-10, ENC-11 | DROPPED 2026-09-28. Closed encoders. Earlier verdict: probably ruled out on construction. Interface is a good match. Link is the GVS 608 HI sheet. |
| Gurley Precision Instruments | LA18 / LA20 / LA24 / LA25 / LA35 | [page](https://www.gurley.com/product/gurley-model-la24-absolute-linear-encoder/) | absolute | optical (sealed) | 0.5 um (SSI) | 0.7 (calc, LA24 +/-3 um/m) | n/c | SSI; BiSS; RS-422 | n/c | n/c | n/c | n/c | n/c | n/c | n/c | ENC-01 | ENC-03, ENC-05, ENC-06, ENC-07, ENC-08, ENC-09, ENC-10, ENC-11 | Ruled out on construction: sealed body. Resolution 0.5 um only just meets the old target. |
| HIWIN | Positioning measurement system | [page](https://www.hiwinmikro.tw/zh/product/positioning-measurement-system) | absolute | magnetic | n/c | n/c | n/c | n/c | n/c | n/c | n/c | n/c | n/c | n/c | n/c | none recorded | ENC-01, ENC-02, ENC-03, ENC-04, ENC-05, ENC-06, ENC-07, ENC-08, ENC-09, ENC-10, ENC-11 | Ruled out: magnetic sensing next to a linear motor. Integrated with the guideway. Taiwanese. |
| HONTKO | Linear Wire Encoder range | n/c | absolute | draw wire | coarse | n/c | n/c | RS-485; analog | n/c | n/c | n/c | n/c | n/c | n/c | n/c | ENC-04 | ENC-02, ENC-03, ENC-05, ENC-06, ENC-07, ENC-08, ENC-09, ENC-10, ENC-11 | Ruled out: draw-wire sensors only. No linear scale product. Taiwanese. |
| iC-Haus | iC-PZ205 chip + PZ linear code strip | [PDF](https://www.ichaus.de/wp-content/uploads/PZ-Series_datasheet_F1en.pdf) | absolute | optical (reflective) | up to 22 bit (um n/c) | n/c | n/c | BiSS; SSI; SPI; ABZ; analog sin/cos | 0.5 deg el. INL (um n/c) | 5 | n/c | 5 | n/c | n/c | n/c | none recorded | ENC-01, ENC-02, ENC-03, ENC-05, ENC-07, ENC-09, ENC-10, ENC-11 | Best fit for open hardware: one chip plus a printed strip, BiSS straight to the drive. Need the strip pitch to convert INL to um. Link is the 85-page data sheet. |
| Leine Linde | RLA 4200 | [page](https://www.leinelinde.com/products/incremental-encoders/4000-linear/rla-4200/) | absolute | inductive | n/c | 2 (linearity +5 um/m) | n/c | SSI; also EnDat | n/c | n/c | n/c | n/c | n/c | n/c | n/c | ENC-04 | ENC-01, ENC-03, ENC-05, ENC-06, ENC-07, ENC-08, ENC-09, ENC-10, ENC-11 | Best inductive part. Made for steel mills, so size is probably large. Scale 140, 200 or 260 mm. Price unknown. |
| Magnescale (Sony) | Laserscale BS78 | [PDF](https://www.magnescale.com/en/product/catalog/Laserscale_en.pdf) | incremental | optical | to 2.1 pm | n/c (+/-0.04 um over 40 mm) | n/c | BiSS-C; A/B; 1 Vpp; USB | n/c | n/c | n/c | n/c | n/c | n/c | n/c | none recorded | ENC-02, ENC-03, ENC-05, ENC-06, ENC-07, ENC-08, ENC-09, ENC-10, ENC-11 | Outstanding but probably overspecified (semiconductor metrology). Signal pitch 138 nm. Confirm length range first. |
| Mitutoyo | ABS ST700 series (open type) | [PDF](https://www.mitutoyo.com/webfoo/wp-content/uploads/2048_Open_Type_ABS_ST700.pdf) | absolute | inductive | 0.1 um | 6.1 (5+5L/1000 um) | n/c | Mitutoyo, FANUC, Mitsubishi, Panasonic, Yaskawa serial | n/c | 50 | 11 | 28 | n/c | n/c | n/c | ENC-02, ENC-04, ENC-06 | ENC-03, ENC-05, ENC-09, ENC-10, ENC-11 | Ruled out: the drive cannot read it. Electromagnetic induction, not optical. IP65. |
| Ningbo Hopo Technology | Not identified | n/c | absolute (claimed) | optical and magnetic | 0.1 um (claimed) | n/c | n/c | SSI; BiSS (claimed) | n/c | n/c | n/c | n/c | n/c | n/c | n/c | none recorded | ENC-01, ENC-02, ENC-03, ENC-04, ENC-05, ENC-06, ENC-07, ENC-08, ENC-09, ENC-10, ENC-11 | Chinese candidate 2. Nothing can be checked without contacting them. Asked for a datasheet on 2026-09-28, no reply yet. |
| Novotechnik | TLM series | [PDF](https://www.novotechnik.com/resources/manuals/TLM.pdf) | absolute | inductive (CSV) | n/c | 30 (linearity, length n/c) | n/c | SSI; Start/Stop; analog | n/c | n/c | n/c | n/c | n/c | n/c | n/c | ENC-02, ENC-04 | ENC-01, ENC-03, ENC-05, ENC-06, ENC-07, ENC-08, ENC-09, ENC-10, ENC-11 | Weak: housed transducer, not a compact open scale. Anodised aluminium housing. Data sheet calls the principle magnetostrictive, not inductive. |
| PI (Physik Instrumente) | PIOne (in-house stage encoder) | [PDF](https://www.pi-usa.us/fileadmin/user_upload/pi_us/files/product_datasheets/D711_Nanomneter_Measurement_Datasheet.pdf) | incremental | optical (interferometer) | 20 pm RMS and better | 0.15 per 300 mm (grating) | n/c | sin/cos or quadrature; BiSS | ~0.005 (our estimate) | 12 | 9.5 | 23 | n/c | n/c | n/c | none recorded | ENC-03, ENC-04, ENC-09, ENC-10, ENC-11 | From the piezo stage file. Not sold as a separate part in the earlier notes. Signal period 0.5 um. Meant for travel above 1 mm. |
| POSIC | AP9201L | [page](https://www.posic.com/EN/absolute-linear-encoder-ap9201l.html) | absolute | inductive | 0.02 um | n/a (absolute range 19 mm) | n/c | SSI (single-ended 5 V) | n/c | n/c | <5 (with scale) | n/c | n/c | n/c | n/c | ENC-02, ENC-04 | ENC-03, ENC-05, ENC-06, ENC-08, ENC-09, ENC-10, ENC-11 | Ruled out: absolute range 19 mm against 220 mm. A near miss. Insensitive to magnetic fields. Prices inside the old budget. |
| Precizika Metrology | LK18 / LK18B / LK18T | [page](https://www.precizika.com/downloads/) | absolute | optical (closed) | 0.05 or 0.1 um | 5 | n/c | SSI; BiSS-C; FANUC | n/c | n/c | n/c | 325 (sealed body at ML 220) | n/c | n/c | n/c | ENC-08 | ENC-03, ENC-05, ENC-06, ENC-07, ENC-09, ENC-10, ENC-11 | Ruled out: closed type, about 0.6 kg. Only open absolute is the MK, which is magnetic. Document faults found in STEP file and IP rating. Link is the downloads page. |
| Renishaw | RL26BBT050B30A + RTLA30 (RESOLUTE) | [PDF](https://www.renishaw.com/media/pdf/en/519451ac9986446394a06d0f8f236688.pdf) | absolute | optical | 50 nm | 1.1 (calc, +/-5 um/m) | n/c | BiSS-C 26 bit | 0.04 | 16.5 | 17.2 | 36 | n/c | n/c | n/c | ENC-06 | ENC-03, ENC-09, ENC-10, ENC-11 | Recommended in the first report: the benchmark. Price EUR 1111 (500 mm scale min). Scale pitch 30 um. Jitter 10 nm RMS. |
| Renishaw | EL32BBB100F30A + RTLA50 (EVOLUTE) | [PDF](https://www.renishaw.com/media/pdf/en/66c0b3b785aa47e99161e5d96f83e525.pdf) | absolute | optical | 100 nm | n/c (RTLA50 +/-5 or +/-15 um/m) | n/c | BiSS-C 32 bit | n/c | n/c | n/c | n/c | n/c | n/c | n/c | none recorded | ENC-02, ENC-03, ENC-05, ENC-06, ENC-07, ENC-08, ENC-09, ENC-10, ENC-11 | Alternative: saves only about EUR 60 over RESOLUTE. Confirm the scale accuracy grade first. |
| Renishaw | T1030-15A (TONiC) + RTLC20-S tape | [PDF](https://www.renishaw.com/resourcecentre/en/details/Data-sheet-TONiC-encoder-system--128629?lang=en) | incremental | optical | to 1 nm (with Ti interface) | 1.1 (calc, +/-5 um/m) | 10 (3.24 at 0.1 um) | 1 Vpp (A/B/Z via Ti) | 0.03 | 13.5 | 10 | 35 | 0.4 | 8 | n/c | none recorded | ENC-11 | Strongest new candidate: best per-period figure in the search. Needs the Ti interface (EUR 52.90) and an interpolator to reach the drive. Head EUR 404. RELM20 spar gives +/-1 um up to 1 m. Alarm output and reference mark. |
| Renishaw | ATOM2D0-100 (ATOM 20 um) | [PDF](https://www.renishaw.com/media/pdf/en/e71069b9a23d422c9d580f57749c25cb.pdf) | incremental | optical | set by interface | 1.1 (calc, scale +/-5 um/m) | n/c | 1 Vpp | 0.075 | 12.7 | 7.85 | 20.5 | n/c | n/c | n/c | none recorded | ENC-01, ENC-03, ENC-09, ENC-10, ENC-11 | Not in the shortlist. Shop shows no price. Link is the ATOM DX data sheet (same family). Needs an interface box. |
| Renishaw | ATOM4D0-100 (ATOM 40 um) | [PDF](https://www.renishaw.com/media/pdf/en/e71069b9a23d422c9d580f57749c25cb.pdf) | incremental | optical | set by interface | 1.1 (calc, scale +/-5 um/m) | n/c | 1 Vpp | n/c | 12.7 | 7.85 | 20.5 | n/c | n/c | n/c | none recorded | ENC-01, ENC-02, ENC-03, ENC-05, ENC-09, ENC-10, ENC-11 | Cheapest published compact optical head, EUR 292. Per-period figure not published for this part. Link is the ATOM DX data sheet (same family). |
| Renishaw | A4A0Y15A10F (ATOM DX 40 um) | [PDF](https://www.renishaw.com/media/pdf/en/e71069b9a23d422c9d580f57749c25cb.pdf) | incremental | optical | 0.1 um (series to 2.5 nm) | 1.1 (calc, scale +/-5 um/m) | n/c | digital RS422 A/B/Z | 0.12 (40 um); 0.075 (20 um) | 12.7 | 10.85 | 20.5 | n/c | n/c | n/c | ENC-04 | ENC-01, ENC-05, ENC-09, ENC-10, ENC-11 | No interface box needed, but output is A/B/Z so edge counting returns. Head EUR 487. |
| Renishaw | ASTRiA | n/c | absolute | inductive | n/c | n/c | n/c | BiSS-C unidirectional | n/c | n/c | n/c | n/c | n/c | n/c | n/c | none recorded | ENC-01, ENC-02, ENC-03, ENC-05, ENC-06, ENC-07, ENC-08, ENC-09, ENC-10, ENC-11 | Does not qualify: rotary only. Kept so the inductive search is complete. |
| Renishaw | RGH24 (RG2 tape) | [PDF](https://www.renishaw.com/resourcecentre/download?data=26596&lang=en&userLanguage=en) | incremental | optical | n/c | n/c | n/c | n/c | n/c | n/c | n/c | n/c | n/c | n/c | n/c | none recorded | ENC-01, ENC-02, ENC-03, ENC-04, ENC-05, ENC-06, ENC-07, ENC-08, ENC-09, ENC-10, ENC-11 | Only a second-hand listing (Nanomotion LS4 stage). Not used in conclusions. Link is the installation guide. |
| Resson Technologies (Easson, Rasson brands) | GS10 to GS35; RL470 to RL665 | [PDF](http://www.resson.com.tw/uploads/files/02af2213a0673382d94b0aa46d158d26.pdf) | incremental | optical (glass, sealed) | n/c | 2.2 (calc, +/-10 um/m) | n/c | TTL; RS-422 | n/c | n/c | n/c | n/c | n/c | n/c | n/c | ENC-04 | ENC-01, ENC-03, ENC-05, ENC-06, ENC-07, ENC-08, ENC-09, ENC-10, ENC-11 | Ruled out: sealed digital readout scales, IP53, no 1 Vpp. Taiwanese. |
| Shanghai Hengxiang Optical Electronics | Not identified | n/c | absolute (claimed) | optical | claimed 40 um to 0.0125 um | n/c | n/c | differential RS-422 only | n/c | n/c | n/c | n/c | n/c | n/c | n/c | ENC-04 | ENC-02, ENC-03, ENC-05, ENC-06, ENC-07, ENC-08, ENC-09, ENC-10, ENC-11 | DROPPED 2026-09-28. Output is differential RS-422 only. Earlier verdict: ruled out, fails the document test. Quote request only. |
| Sino and Noxin (Guangzhou) | Open and absolute open scales; no model reached | n/c | absolute (stated) | optical | n/c | n/c | n/c | SSI and BiSS-C (stated) | n/c | n/c | n/c | n/c | n/c | n/c | n/c | none recorded | ENC-01, ENC-02, ENC-03, ENC-04, ENC-05, ENC-06, ENC-07, ENC-08, ENC-09, ENC-10, ENC-11 | Weak: trace to the factory first. Shared sales site. Claims to replace Renishaw, Fagor and Heidenhain. |
| SmarAct | METIRIO read head (bare OEM) | [PDF](https://www.smaract.com/pdf-details/en/metirio-readhead) | incremental | optical | <1 nm (0.4 nm at 20 mm/s) | 1.1 (calc, scale 5 um/m) | n/c | 1 Vpp + RS485 reference | n/c | 5.1 | 1.7 | 6.6 | 1.5 | 5 | n/c | ENC-09 | ENC-03, ENC-05, ENC-11 | Smallest head found. Scale 225 x 5 x 1.5 mm black glass, pitch 20 um. Interface module is a separate part. Price on request. |
| SmarAct | METIRIO D1c / METIRIO A1 (housed) | [page](https://www.smaract.com/en/metrology/metirio-encoder/product/metirio-readhead) | incremental | optical | <1 nm | 1.1 (calc, scale 5 um/m) | n/c | 1 Vpp + reference | n/c | 11.2 / 10 | 6.2 / 4 | 15 / 17 | 1.5 | 5 | n/c | ENC-09 | ENC-03, ENC-05, ENC-11 | A1 is the vacuum version with Teflon cable. Same 20 um glass scale. |
| Tai Chuang (maker not named) | GPS 40R | n/c | incremental | optical | 0.5 to 5 um | 1.1 (calc, +/-5 um/m) | n/c | TTL only | n/c | n/c | n/c | n/c | n/c | n/c | n/c | ENC-01, ENC-04 | ENC-03, ENC-05, ENC-06, ENC-07, ENC-08, ENC-09, ENC-10, ENC-11 | Ruled out: no 1 Vpp and no BiSS. Reseller of CARMAR and Mitutoyo. The +/-5 um/m is stated as repeatability. Taiwanese. |
| Turck | LI-Q25L series | [PDF](https://www.turck.us/attachment/100003779.pdf) | absolute | inductive | 16 bit over range, about 3.4 um at 220 mm | n/c | n/c | analog 4-20 mA / 0-10 V; IO-Link | n/c | n/c | n/c | n/c | n/c | n/c | n/c | ENC-01, ENC-04 | ENC-02, ENC-03, ENC-05, ENC-06, ENC-07, ENC-08, ENC-09, ENC-10, ENC-11 | Ruled out: about 3.4 um resolution, no BiSS-C or SSI. Factory sensor, not a servo encoder. Q25 housing. |
| US Digital | EM2 module + LIN film strip | [PDF](https://www.usdigital.com/datasheets/em2-datasheet.pdf) | incremental | optical (transmissive) | set by strip pitch | n/c | n/c | TTL A/B/Z, single-ended 5 V | n/c | n/c | n/c | n/c | n/c | n/c | n/c | ENC-04 | ENC-01, ENC-02, ENC-03, ENC-05, ENC-06, ENC-07, ENC-08, ENC-09, ENC-10, ENC-11 | DROPPED 2026-09-28. Chip-based, no reliable way to mount it. Earlier verdict: ruled out by the new rule. Reference case for TTL. Cheap, open, well documented. |
| Zettlex (Celera Motion) | IncOder / IncOder CORE (rotary only) | [page](https://www.celeramotion.com/zettlex/products/core/incoder-core/) | absolute | inductive | up to 22 bit (rotary) | n/c | n/c | BiSS-C; SSI; SPI | n/c | n/c | n/c | n/c | n/c | n/c | n/c | none recorded | ENC-01, ENC-02, ENC-03, ENC-04, ENC-05, ENC-06, ENC-07, ENC-08, ENC-09, ENC-10, ENC-11 | Does not qualify: rotary only. Kept so the inductive search is complete. |

## Sources

- [Comparison table of all linear encoders considered so far](log/2026-10-02_linear-encoder-comparison.md)
  holds the open questions, the next steps and the list of documents that were read.
- [The linear encoder requirements are now in the SysML model](log/2026-10-02_linear-encoder-requirements.md)
  explains each requirement.
- [Mistake: loop rate taken from a trade article](mistakes/2026-09-29_loop-rate-from-a-trade-article.md)
  sets the rule that a number that decides a pass or a fail must come from the maker's own document.
