refaqt/aqtuator/docs/log/2026-09-25_linear-stage-drive-and-motion-controller-survey.md

# 2026-09-25 — Drives and a motion controller for the MK21 linear stages

**Role(s):** engineering, hardware, software, purchasing

## Goal

Find affordable servo drives for the linear stages, and a motion controller that runs our own
control laws. Each stage uses a MAXWELL MK21 iron core linear motor and a 1 Vpp linear
incremental encoder (an encoder that gives analog sine and cosine signals of 1 V peak to peak).
Also answer whether LinuxCNC can be the motion controller and the EtherCAT master.

## Work Done

### Short answer, after the requirements changed

Later the same day the requirements changed. The peak force of 512 N is needed at
10 000 mm/min, and the drive position loop only needs 4 kHz. The stages use an optical linear
encoder. This changes the answer:

- **A drive fed from 230 VAC is needed.** The peak force at full speed needs about 160 V on the
  drive's internal DC bus. A 230 VAC drive has about 325 V.
- **The best fit is now the Elmo Gold Oboe 6/230.** The Servotronix CDHD2-003 is the second
  choice, and now meets the 4 kHz loop requirement.
- **A small DIN rail PC can run LinuxCNC at 4 kHz,** if it has an Intel network chip and a tuned
  real-time kernel. Measured worst case delays on such PCs are 22 to 70 µs.
- **The user interface can run in a browser on a laptop.** A small server on the LinuxCNC PC
  connects the browser to LinuxCNC.

The sections below the first survey give the details. The first survey is kept as it was.

Later correction: the CDHD2 also has an 8 kHz position controller, and the CDHD2 is now a legacy
model. See [Servotronix drives with a faster position loop](2026-09-29_servotronix-drives-with-a-faster-loop.md).

Later search: for drives from non-Israeli suppliers with a position loop of at least 8 kHz and
free filters, see [Drives from non-Israeli suppliers with an open control loop](2026-09-29_non-israeli-drives-with-open-control-loops.md).

### First short answer

- **48 VDC is too low for full force at 10 000 mm/min.** At that speed a 48 V drive gives about
  120 to 170 N, depending on coil temperature. The continuous force is 181 N. Pick a drive
  that accepts 80 to 95 VDC. The peak force of 512 N needs a mains voltage drive.
- **No affordable drive meets every requirement.** The Elmo Gold line comes closest. The ACS
  UDMnt meets more of the list, but it only works with an ACS controller.
- **Two requirements cannot be met by any low voltage drive we found.** No drive sends data over
  EtherCAT faster than its own position loop runs. And no drive lets you load any transfer
  function into its loop. Both are met by closing the loop in the PC, as described below.
- **LinuxCNC can be the EtherCAT master.** People run it at 1 to 4 kHz. 8 kHz is not proven.
  For the fast loop, a small real-time program on the same PC is safer.

### What the MK21 needs from a drive

All motor values come from the MAXWELL data sheet in the parts library
([`maxwell-mk2-iron-core-linear-motor.pdf`](../../modules/stoq/modules/maxwell/docs/datasheets/maxwell-mk2-iron-core-linear-motor.pdf)).

| MK21 value | Data sheet |
| --- | ---: |
| Continuous force, current | 181 N, 2.0 Arms |
| Peak force, current (1 s) | 512 N, 5.9 Arms |
| Force constant | 92.5 N/Arms |
| Back EMF constant, line to line | 53.4 V per m/s |
| Resistance, line to line, 25 °C / 120 °C | 13.8 Ω / 19.0 Ω |
| Inductance, line to line | 64.0 mH |
| Highest allowed bus voltage | 600 VDC |

At 10 000 mm/min (0.167 m/s) the back EMF is small, about 9 Vrms line to line. The coil
resistance sets the voltage. The bus voltage needed for a given force is:

| Force at 10 000 mm/min | Coil at 25 °C | Coil at 120 °C |
| --- | ---: | ---: |
| 181 N, continuous | 51 V | 65 V |
| 512 N, peak | 119 V | 158 V |

The other way round, this is the force a given bus voltage allows:

| Bus voltage | Standing still, 25 °C / 120 °C | At 10 000 mm/min, 25 °C / 120 °C |
| ---: | ---: | ---: |
| 48 V | 236 / 172 N | 168 / 122 N |
| 60 V | 296 / 215 N | 227 / 165 N |
| 80 V | 394 / 286 N | 325 / 236 N |

This is a hand calculation, not a measurement. It assumes a sine commutated drive that uses
90 % of the bus voltage, and a magnet period of 30 mm. The drive current must be at least
2 Arms continuous and about 6 Arms peak. Many drives rate current as a peak value: 2 Arms is
2.8 A peak, and 5.9 Arms is 8.3 A peak.

### The drives we checked

| Drive | Bus voltage | 1 Vpp input | Position loop | Shortest EtherCAT cycle | Bode and tuning tool | Result |
| --- | --- | --- | --- | --- | --- | --- |
| Elmo Gold Solo Whistle 5/100, Gold Twitter | 12 to 95 V | Yes, up to ×8192 | 12.5 kHz | 250 µs in the 2013 guide; newer pages say 100 µs | Yes, with plant identification | **Best fit** |
| ACS UDMnt, sin/cos option | 12 to 80 V | Yes, up to ×16 384 | 20 kHz (current loop) | Set by the ACS master | Yes, in the ACS master | Strong, but needs an ACS master |
| Servotronix CDHD2-LV-003 | 20 to 90 V | Yes, up to ×16 384 | 4 kHz (velocity 8 kHz) | 250 µs | Not found | Position loop too slow |
| Technosoft iPOS8010 BX-CAT | 12 to 80 V | Yes | 1 kHz by default | 200 µs | Not found | Loop too slow |
| Novanta (Ingenia) Everest, Capitan, Denali | 7 to 80 V | **No** | 25 kHz | 250 µs | Yes | Rejected |
| Synapticon Circulo | 14 to 58 V | **No** | Not checked | 250 µs | Not checked | Rejected |
| Beckhoff ELM7211 | 8 to 48 V | **No**, only Beckhoff motor encoders | 16 kHz (velocity) | Not checked | Not checked | Rejected |
| Beckhoff AX8108 with the 1 Vpp option | 100 to 480 VAC | Yes | Current loop at 62.5 µs | 62.5 µs, with up to 128 samples per cycle | Yes | Meets almost everything, but mains voltage and a high price |
| HIWIN D2T, HIWIN E1 | 200 to 240 VAC | E1 only with an external box | 16 kHz (D2T) | Not checked | Yes | Mains voltage only |

We found no public prices, except for one Beckhoff encoder terminal. Ask for quotes before
you choose. Chinese low voltage EtherCAT drives (Kinco, Leadshine, Inovance, Googol) may
exist with a 1 Vpp input, but we found no data sheet that confirms it.
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
