refaqt/aqtuator/docs/log/2026-09-29_drives-below-800-euro-per-axis.md

# 2026-09-29 — Drives below 800 euro per axis, from maker forums and open source

**Role(s):** engineering, hardware, purchasing

## Goal

The drives in [Drives from non-Israeli suppliers with an open control loop](2026-09-29_non-israeli-drives-with-open-control-loops.md)
cost 800 to 1,400 euro per axis. That is too much. Find what makers use on a budget: look in
maker forums, at open source drives, and at cheap Chinese and used drives. The requirements stay
the same: 230 VAC (a DC bus of at least about 170 V), 2.0 Arms continuous and 5.9 Arms peak, a
1 Vpp encoder, a position loop of at least 8 kHz, an open control loop with free filters, and no
Israeli suppliers.

## Work Done
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
