refaqt/aqtuator/docs/log/images/2025-09-09-01.png

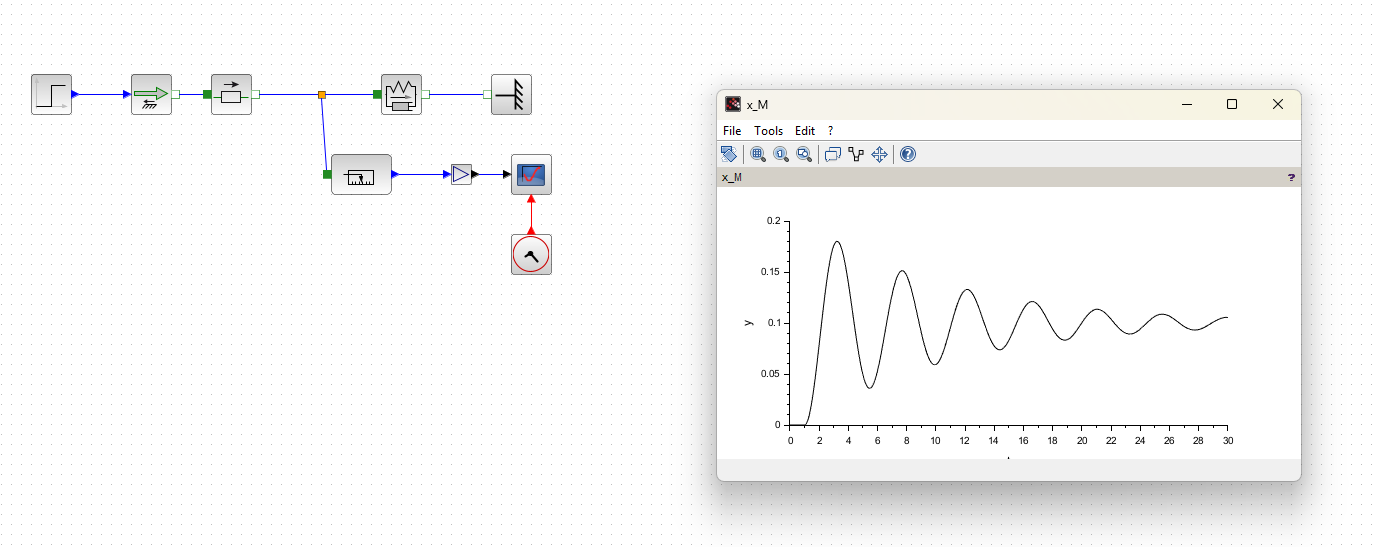
docs/log/images/2025-09-09-01.png
