refaqt/aqtuator/docs/log/images/2025-09-09-02.png

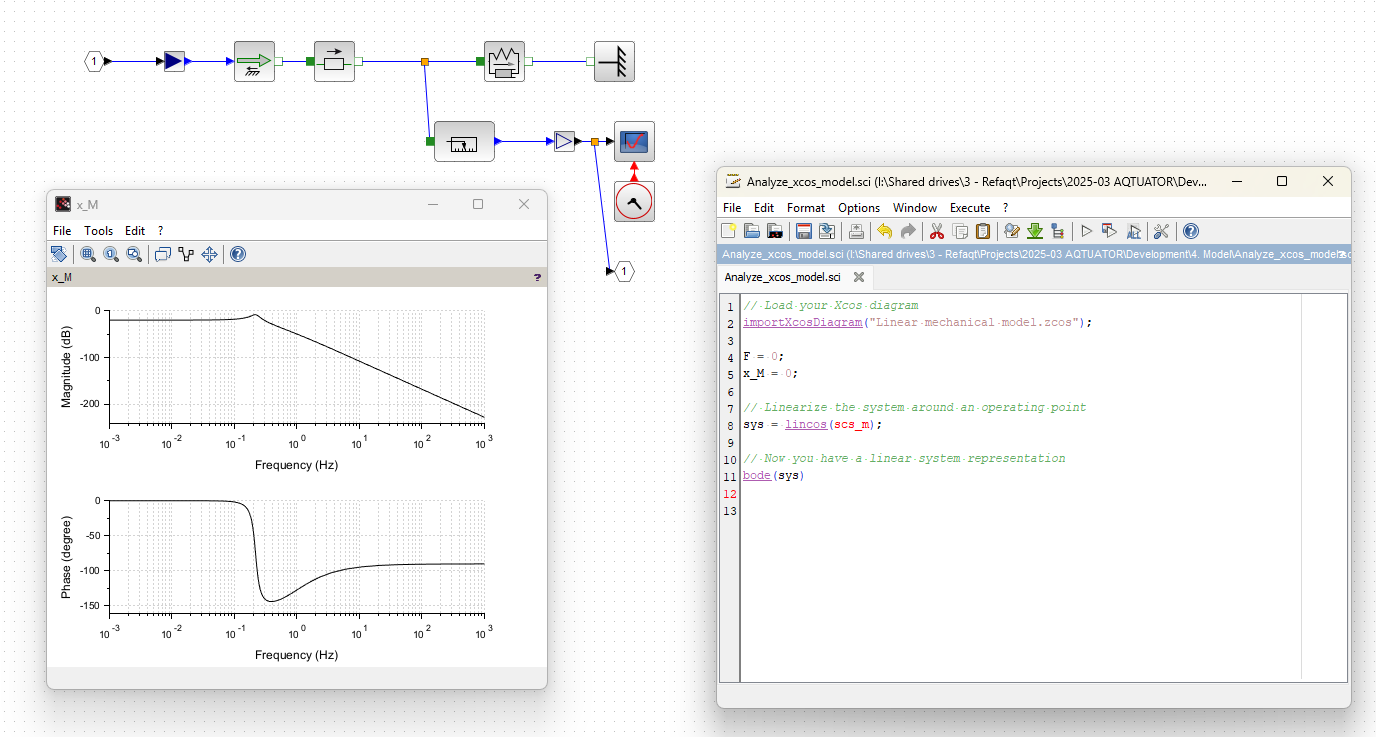
docs/log/images/2025-09-09-02.png
