refaqt/aqtuator/docs/log/images/2025-10-09-02.png

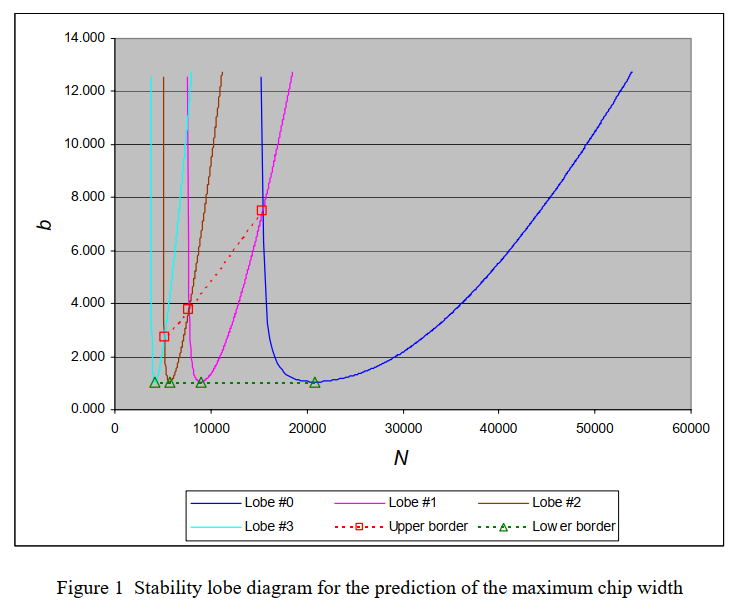
docs/log/images/2025-10-09-02.png
