refaqt/aqtuator/docs/log/images/2025-11-27-01.jpg

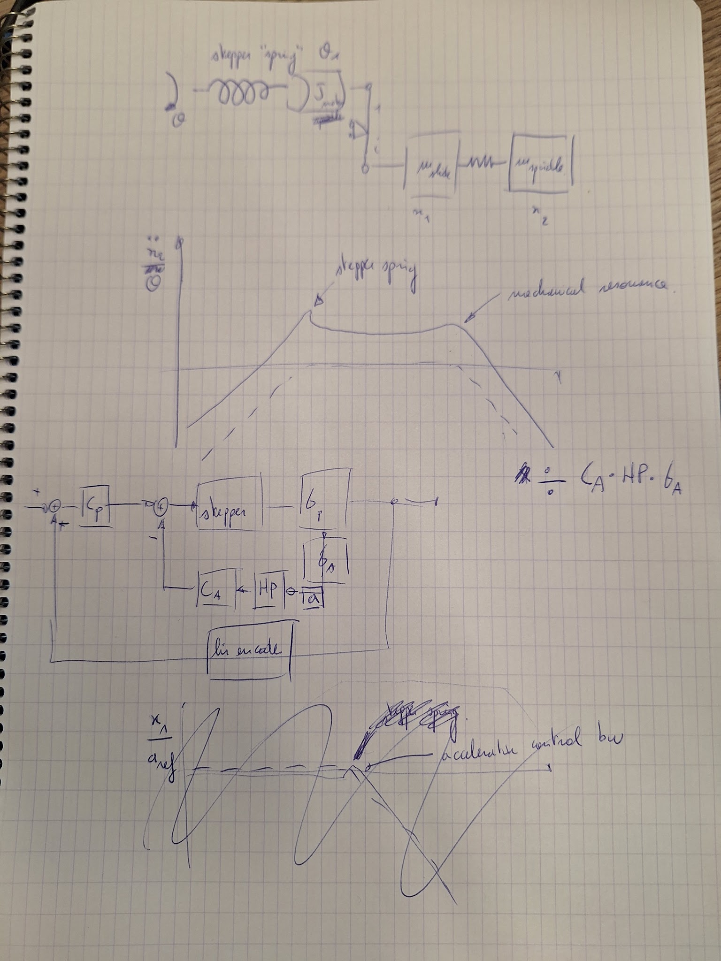
docs/log/images/2025-11-27-01.jpg
