refaqt/aqtuator/docs/log/images/2025-12-10-02.png

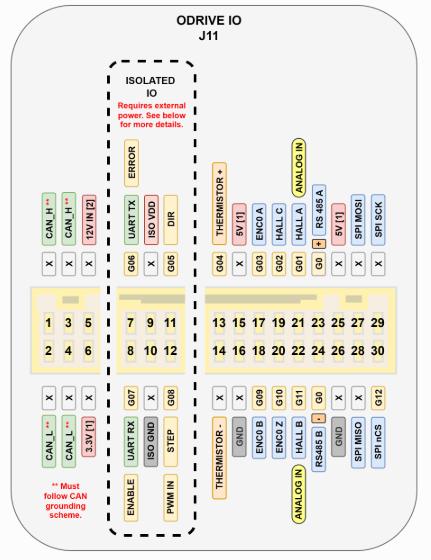
docs/log/images/2025-12-10-02.png
