refaqt/aqtuator/docs/log/images/2026-01-06-01.png

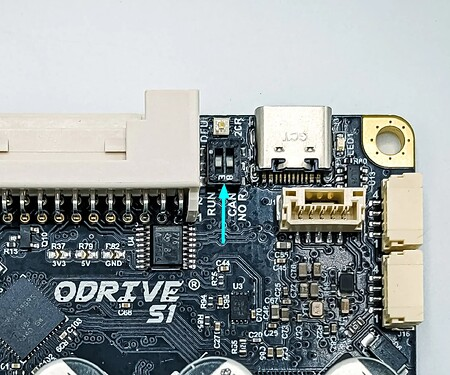
docs/log/images/2026-01-06-01.png
