refaqt/aqtuator/docs/log/images/2026-03-19-01.png

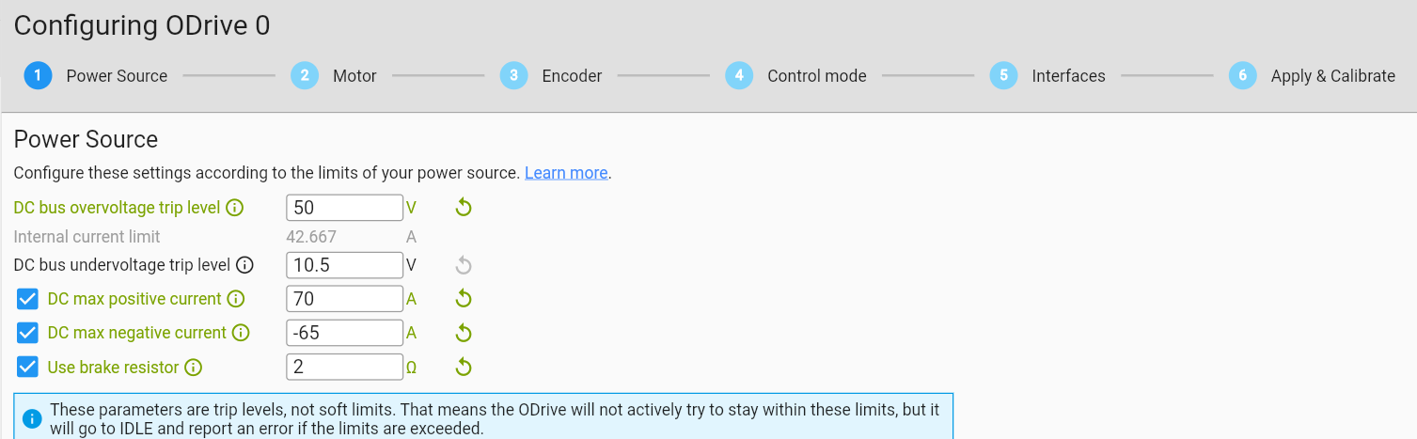
docs/log/images/2026-03-19-01.png
