refaqt/aqtuator/docs/log/images/2026-03-19-02.png

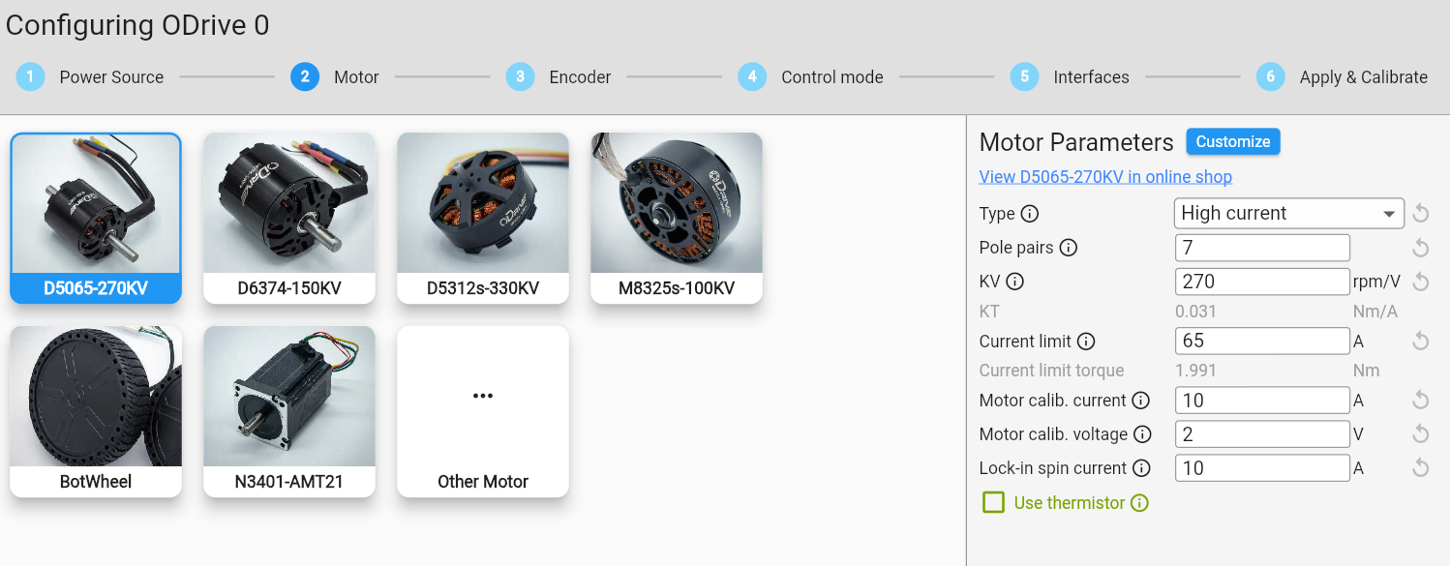
docs/log/images/2026-03-19-02.png
