refaqt/aqtuator/docs/log/images/2026-03-19-07.png

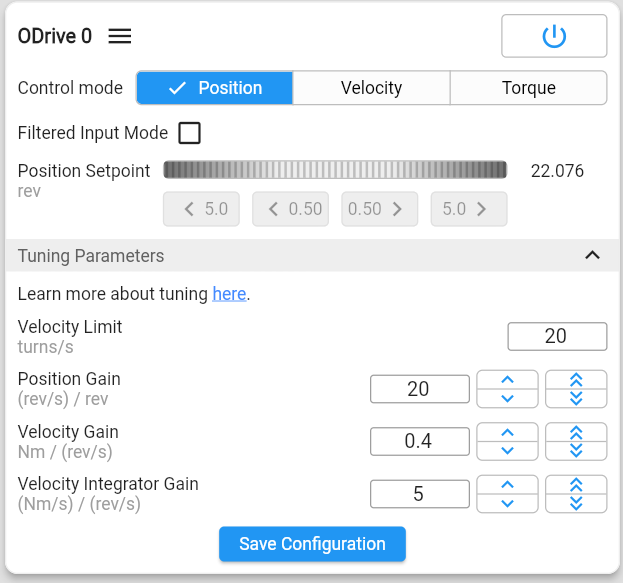
docs/log/images/2026-03-19-07.png
