refaqt/aqtuator/docs/log/images/2026-03-25-01.png

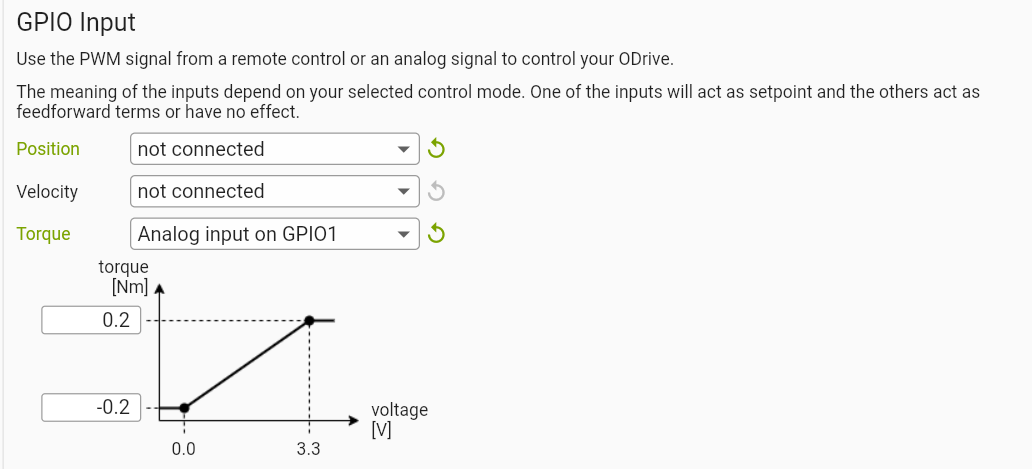
docs/log/images/2026-03-25-01.png
