refaqt/aqtuator/docs/log/images/2026-03-25-03.png

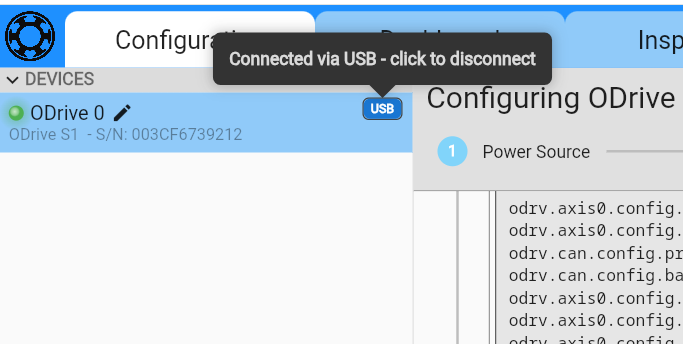
docs/log/images/2026-03-25-03.png
