refaqt/aqtuator/docs/log/images/2026-03-25-04.png

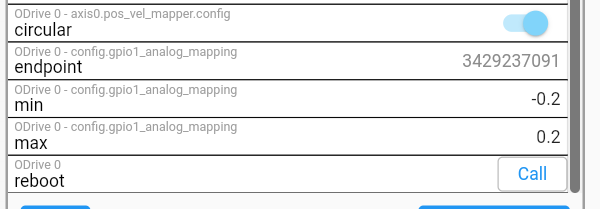
docs/log/images/2026-03-25-04.png
