refaqt/aqtuator/docs/log/images/2026-03-25-05.jpg

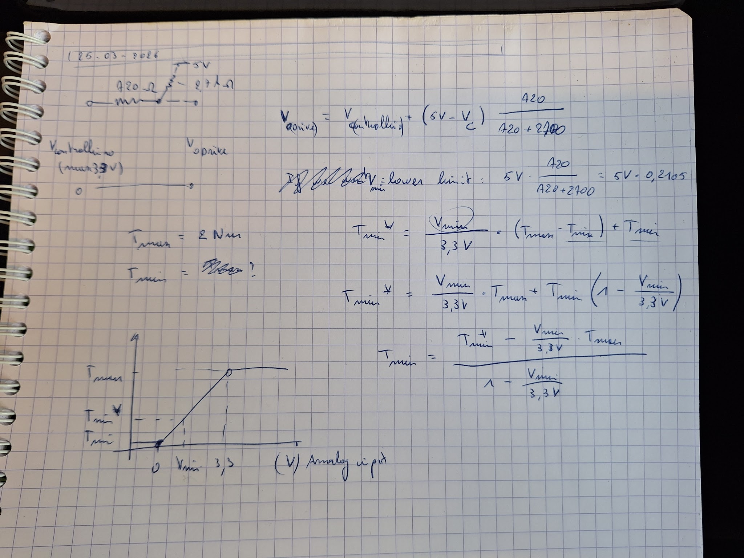
docs/log/images/2026-03-25-05.jpg
