refaqt/aqtuator/docs/log/images/2026-03-25-09.png

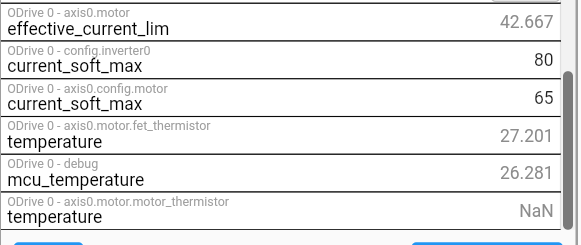
docs/log/images/2026-03-25-09.png
