refaqt/aqtuator/docs/log/images/2026-03-31-01.png

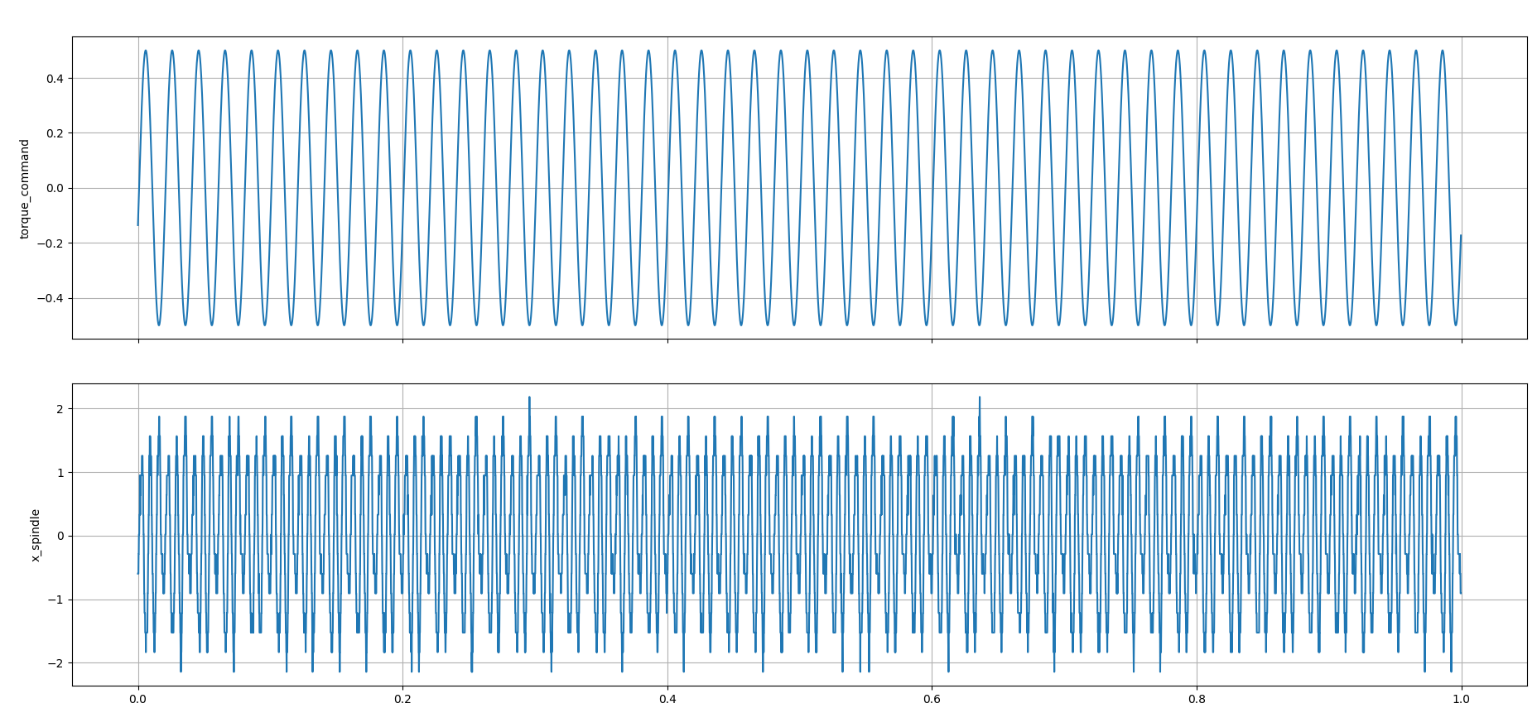
docs/log/images/2026-03-31-01.png
