refaqt/aqtuator/docs/log/images/2026-03-31-03.png

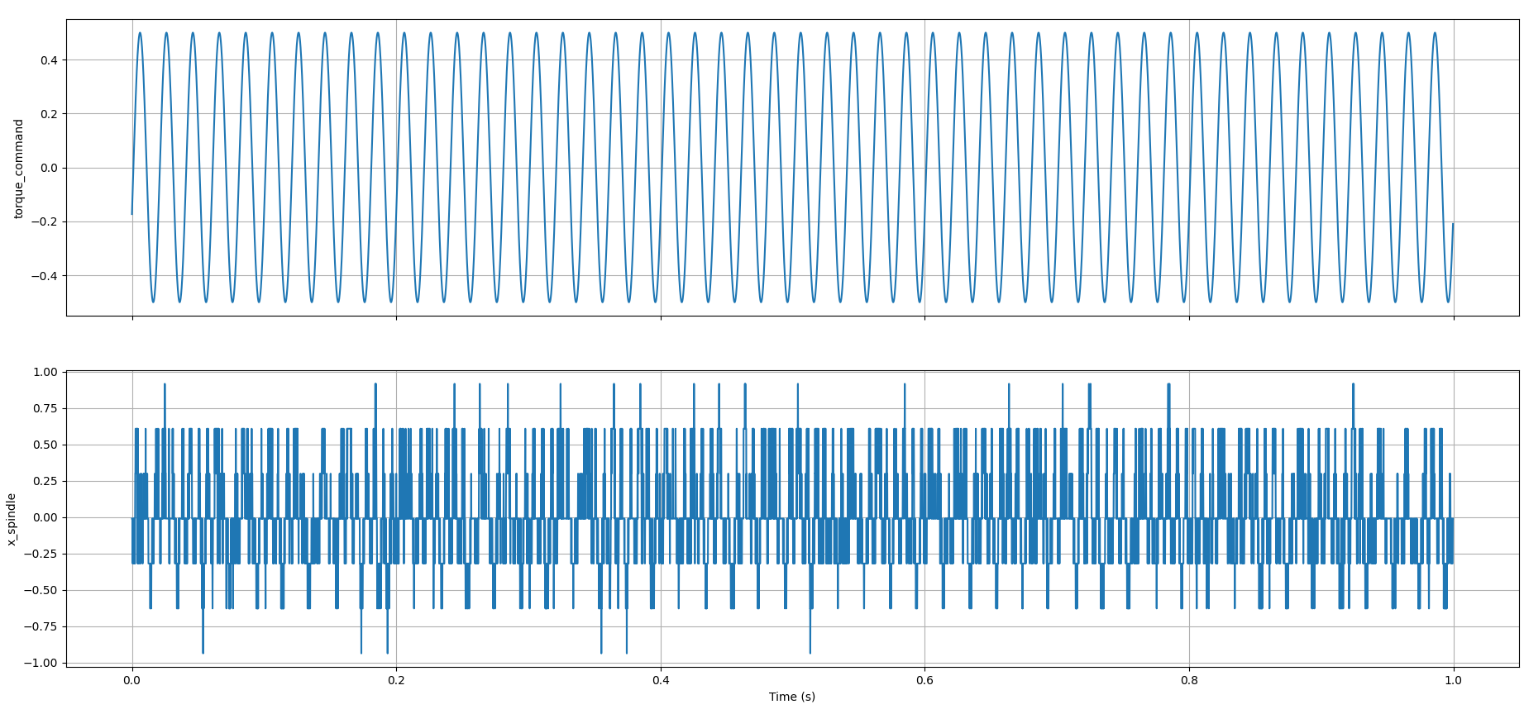
docs/log/images/2026-03-31-03.png
