refaqt/aqtuator/docs/log/images/2026-03-31-04.png

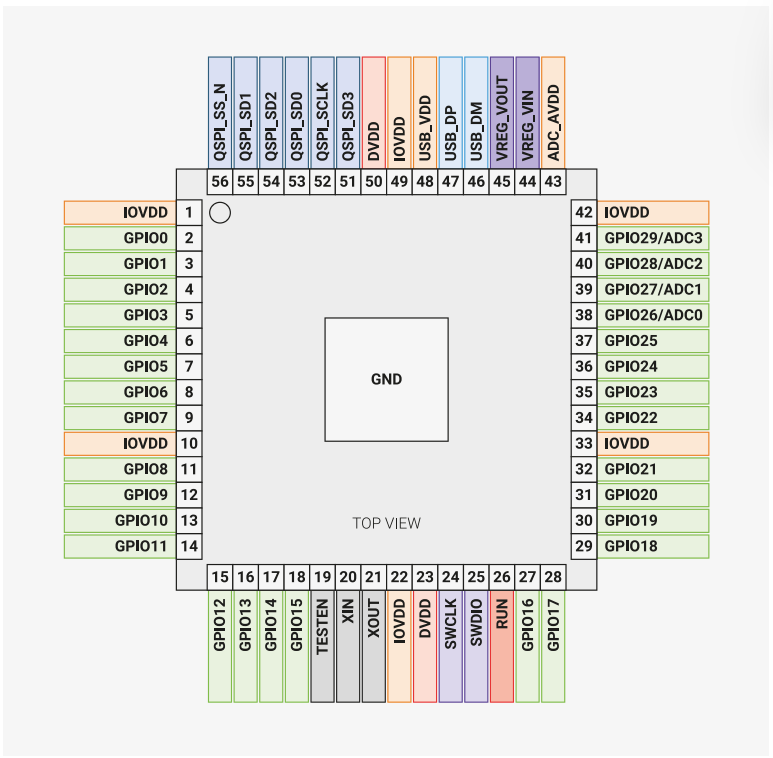
docs/log/images/2026-03-31-04.png
