refaqt/aqtuator/docs/log/images/2026-03-31-06.png

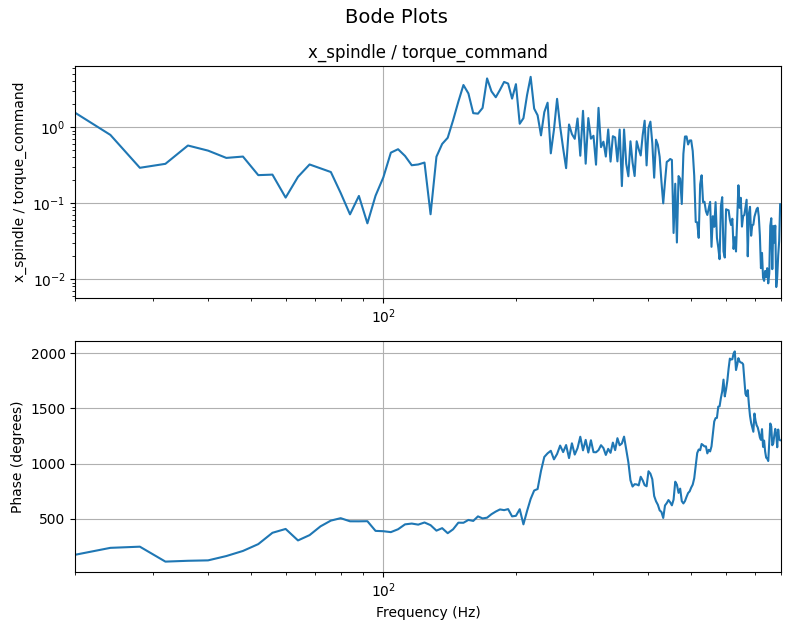
docs/log/images/2026-03-31-06.png
