refaqt/aqtuator/docs/log/images/2026-04-01-01.png

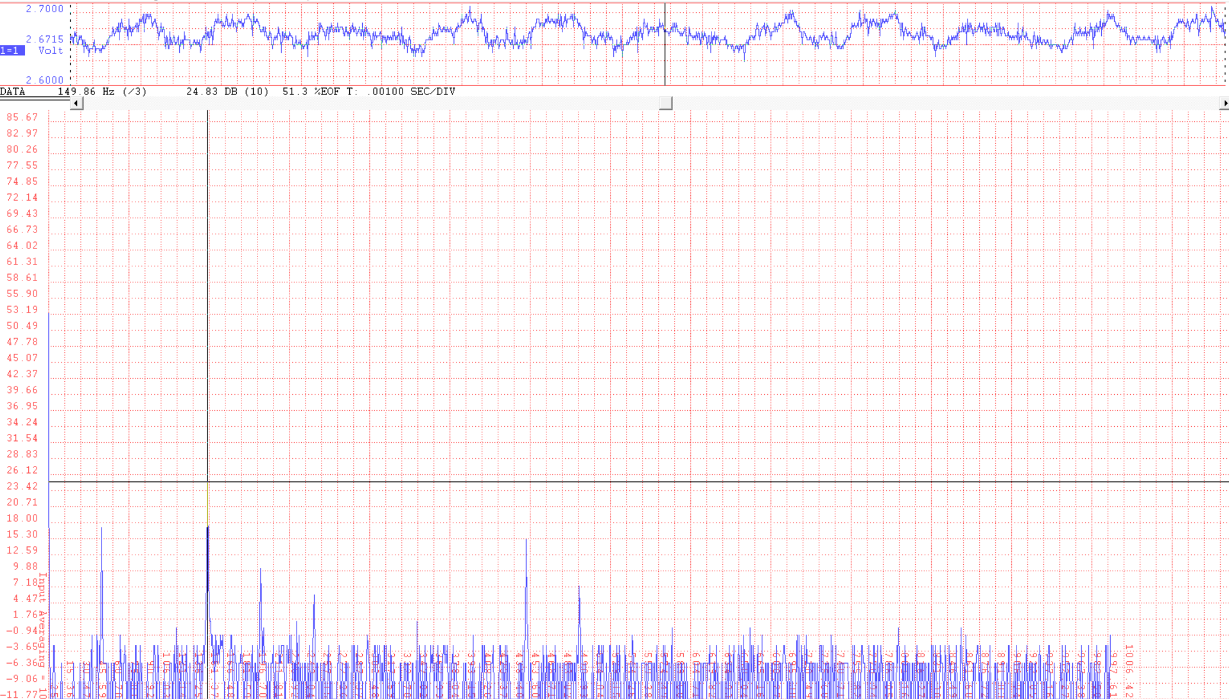
docs/log/images/2026-04-01-01.png
