refaqt/aqtuator/docs/log/images/2026-04-01-02.png

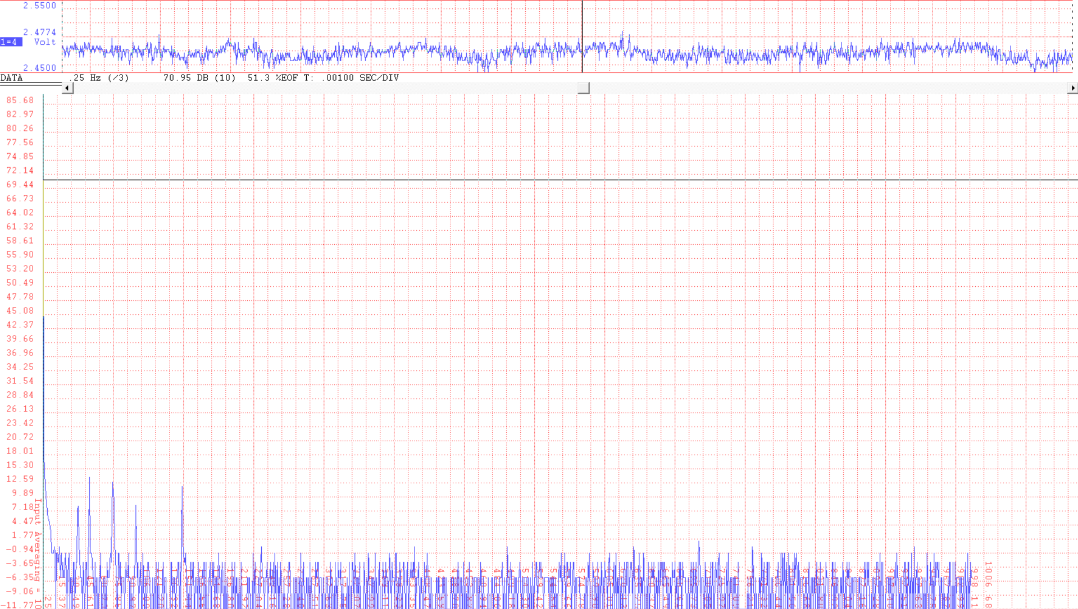
docs/log/images/2026-04-01-02.png
