refaqt/aqtuator/docs/log/images/2026-04-01-05.png

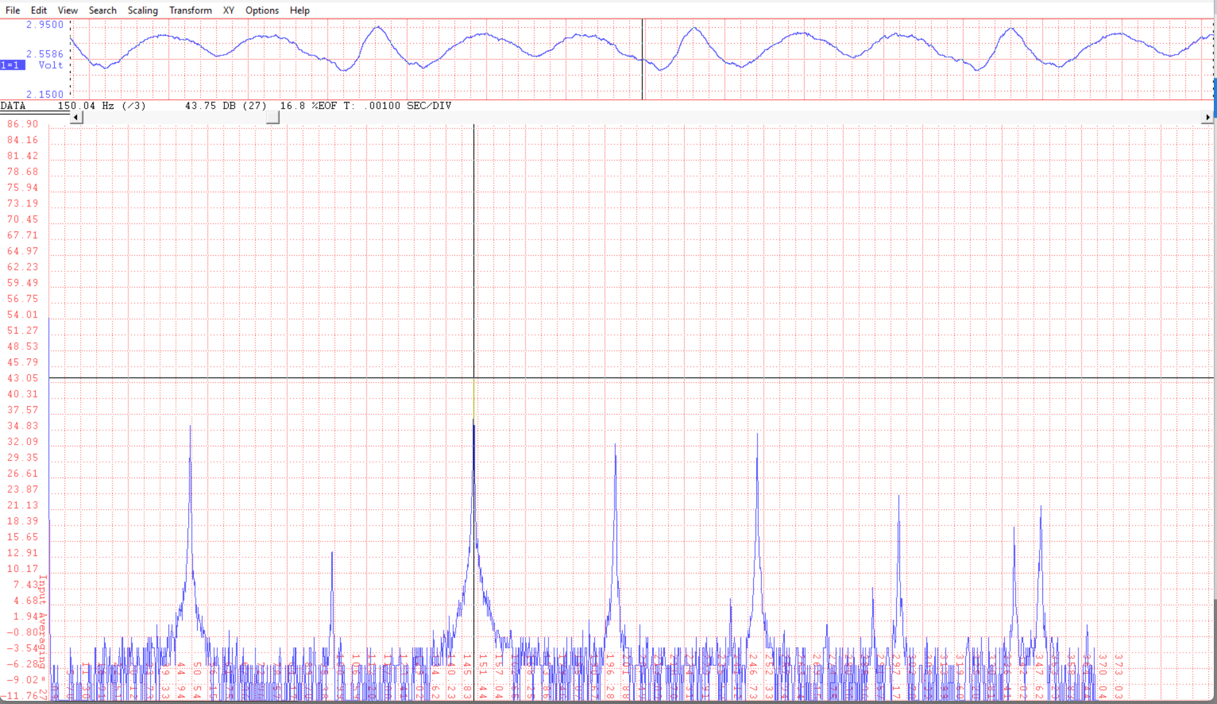
docs/log/images/2026-04-01-05.png
