refaqt/aqtuator/docs/log/images/2026-04-03-02.png

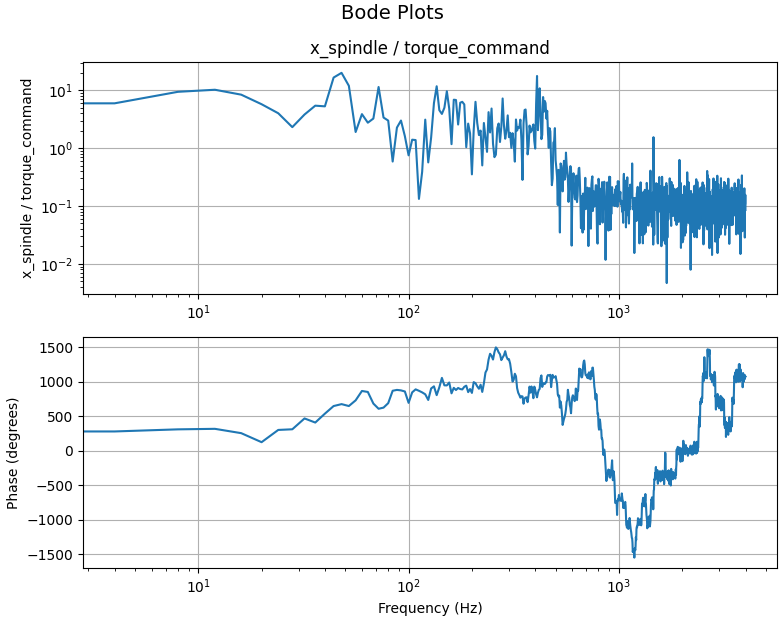
docs/log/images/2026-04-03-02.png
