refaqt/aqtuator/docs/log/images/2026-04-03-03.jpg

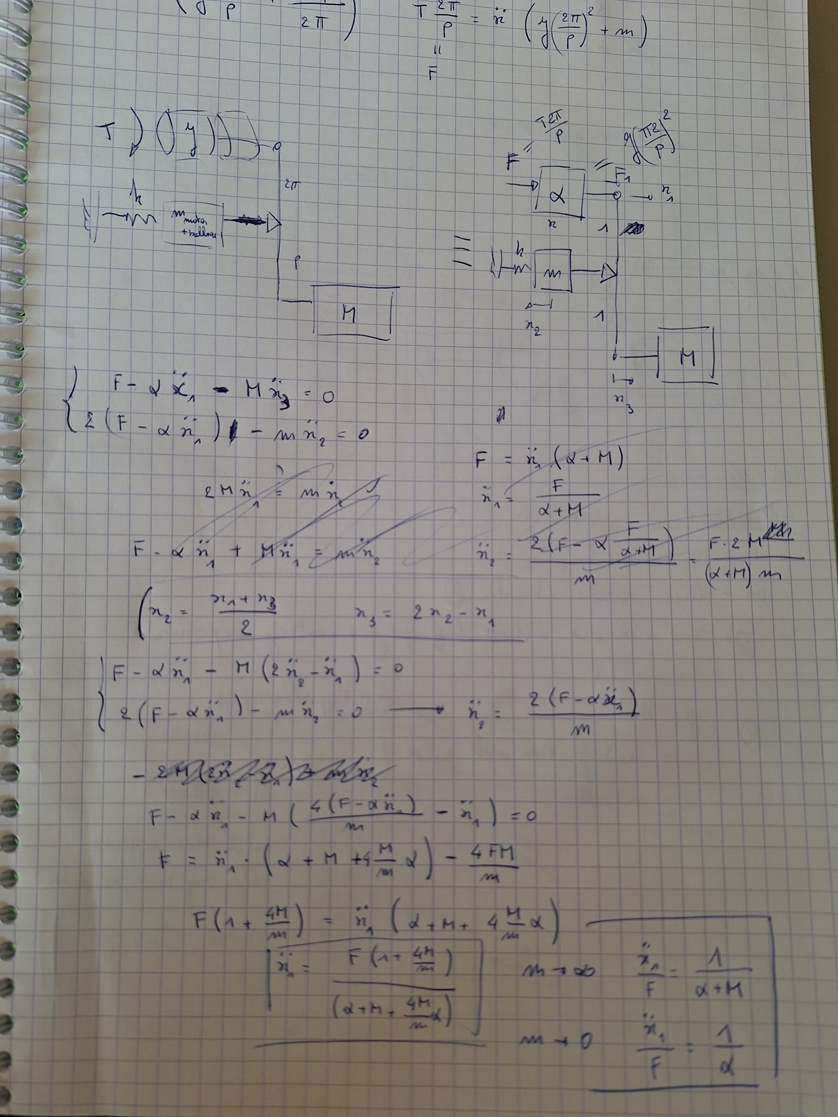
docs/log/images/2026-04-03-03.jpg
