refaqt/aqtuator/docs/log/images/2026-04-03-04.jpg

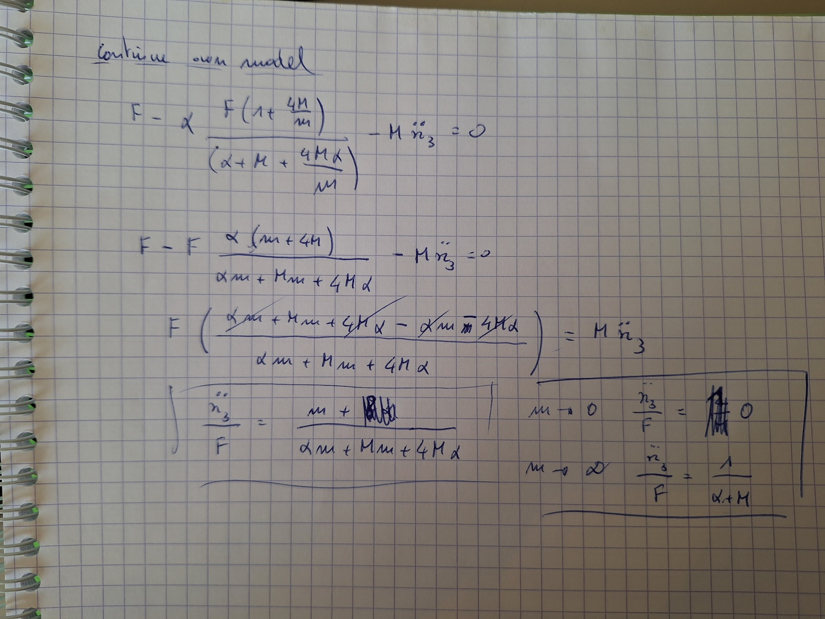
docs/log/images/2026-04-03-04.jpg
