refaqt/aqtuator/docs/log/images/2026-04-13-01.png

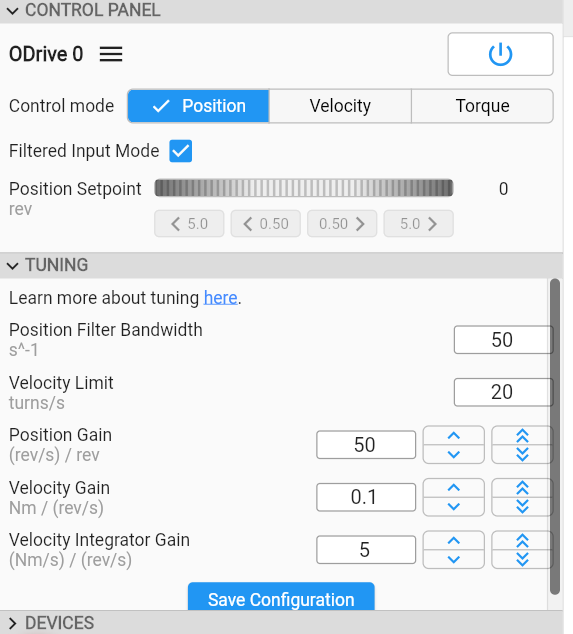
docs/log/images/2026-04-13-01.png
