refaqt/aqtuator/docs/log/images/2026-04-16-01.png

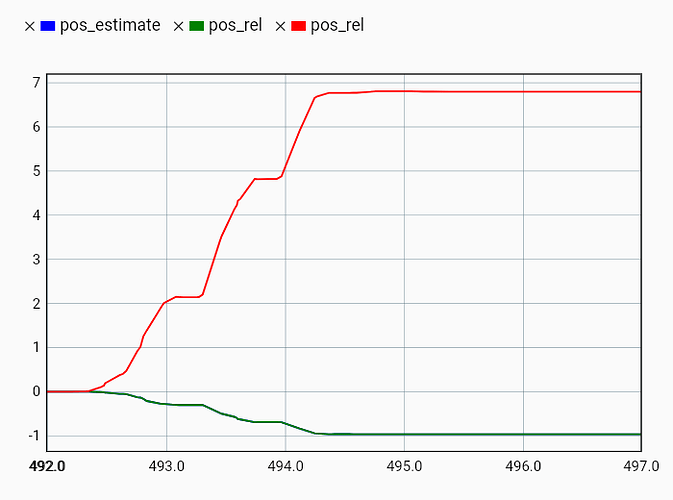
docs/log/images/2026-04-16-01.png
