refaqt/aqtuator/docs/log/images/2026-04-16-03.png

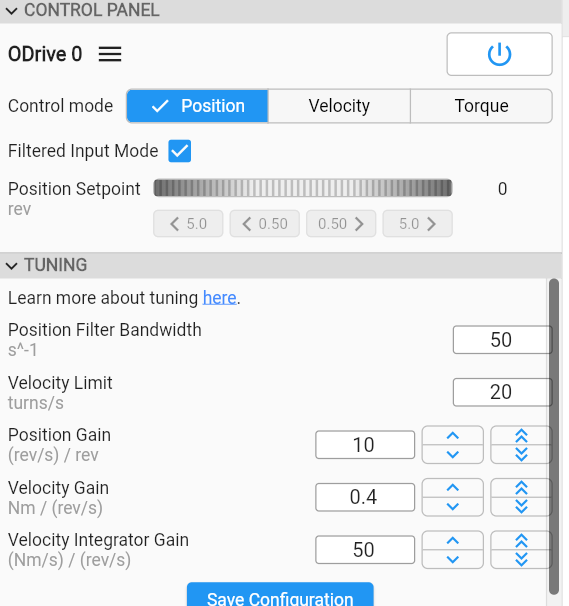
docs/log/images/2026-04-16-03.png
