refaqt/aqtuator/docs/log/images/2026-04-16-04.png

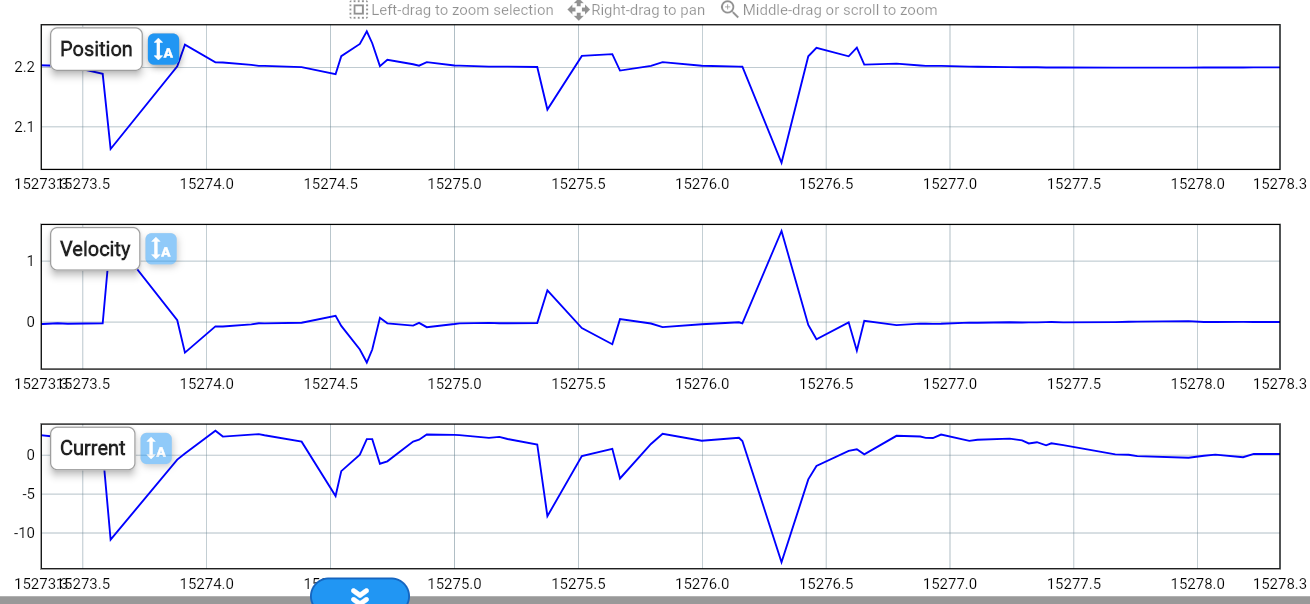
docs/log/images/2026-04-16-04.png
