refaqt/aqtuator/docs/log/images/2026-04-22-02.png

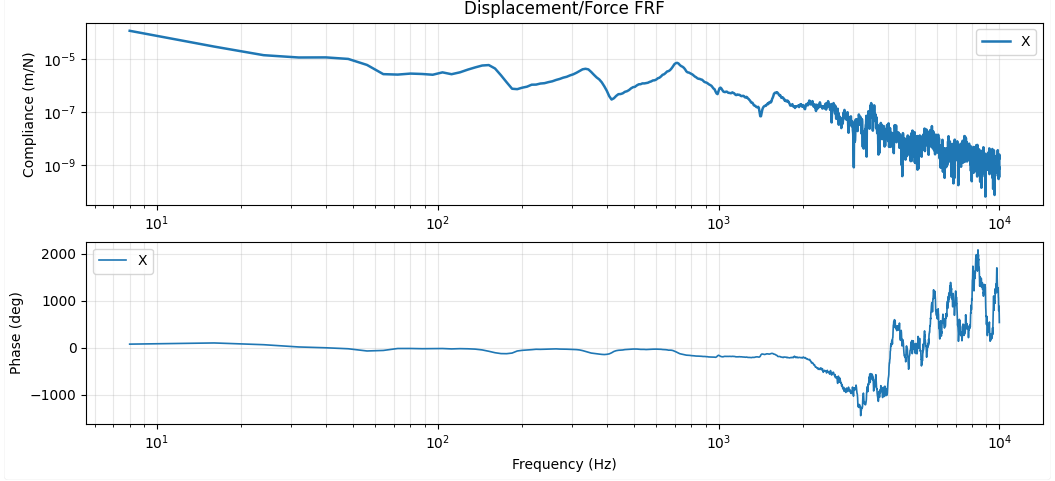
docs/log/images/2026-04-22-02.png
