refaqt/aqtuator/docs/log/images/2026-10-12-02.jpg

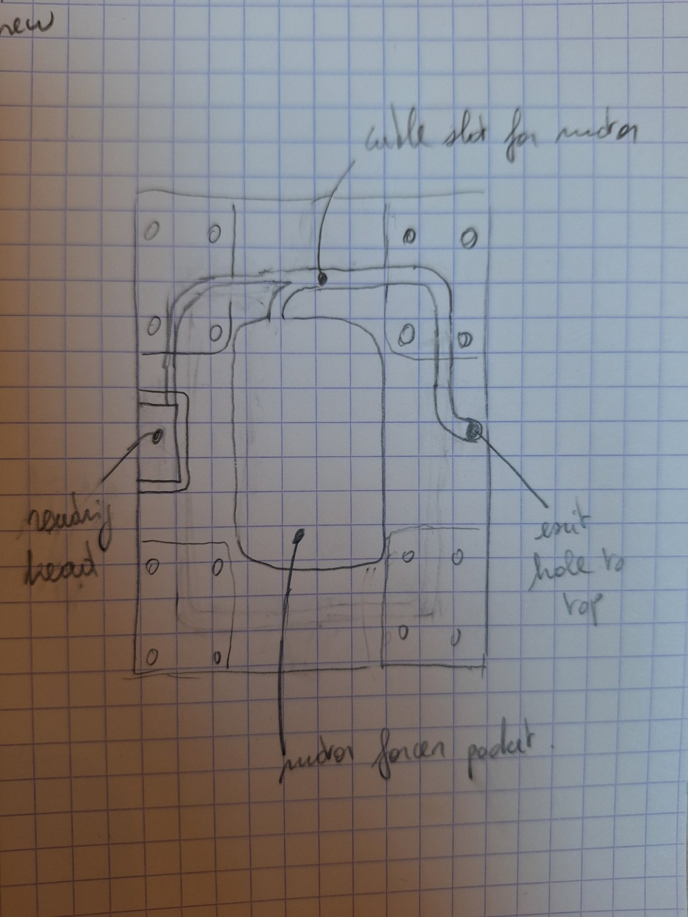
docs/log/images/2026-10-12-02.jpg
