refaqt/aqtuator/docs/log/images/2026-10-22-01.png

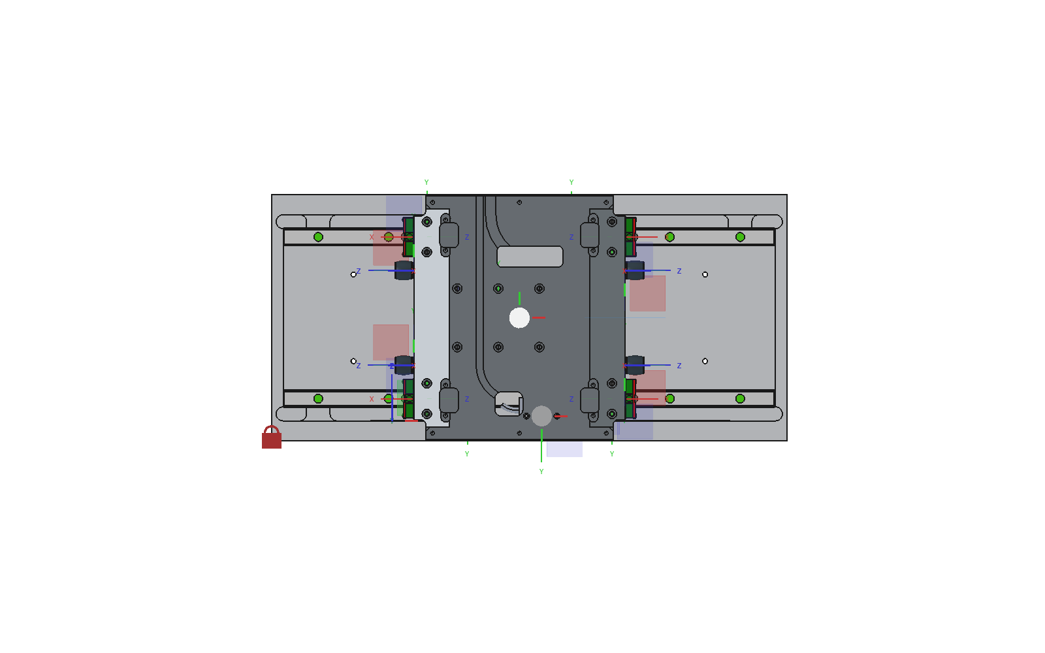
docs/log/images/2026-10-22-01.png
