refaqt/aqtuator/docs/log/images/2026-10-28-04.png

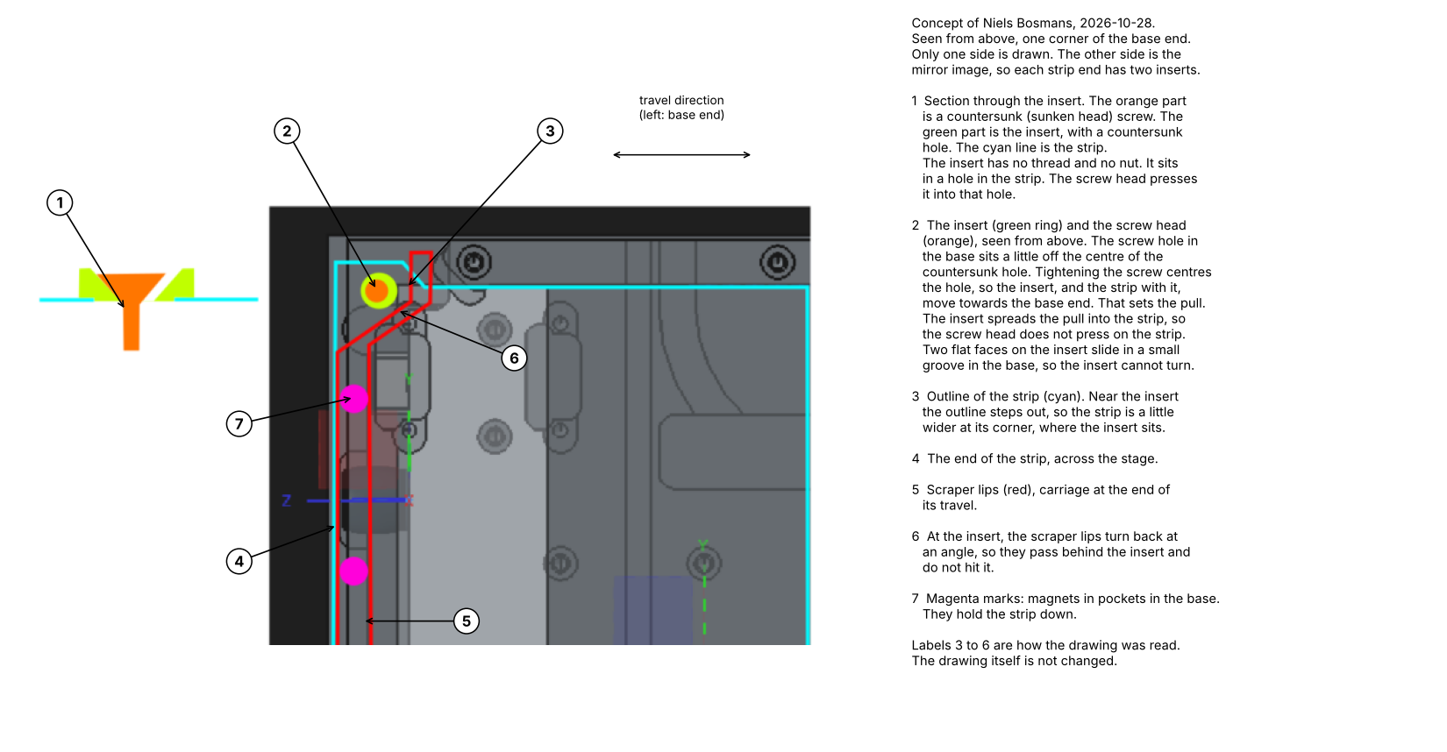
docs/log/images/2026-10-28-04.png
