refaqt/aqtuator/docs/log/2026-04-21_linear-motor-suppliers.md

# 2026-04-21 — Linear motor suppliers

**Role(s):** engineering

- Linear motor suppliers:

  - [<u>https://sahorobot.en.alibaba.com/productgrouplist-959299481/Ironless_Linear_Motor.html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</u>](https://sahorobot.en.alibaba.com/productgrouplist-959299481/Ironless_Linear_Motor.html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)
