refaqt/aqtuator/modules/compact-stage/bom/bom.csv

id | name | spec | category | qty | unit | unit_mass_g | equiv_class | brand | brand_pn | part | notes
SW-001 | Limit Switch | Inductive sensor M8x1, PNP, normally closed, 2 mm flush, 10-30 V DC, built-in M8 3-pin plug | electrical | 2 | pc |  | IND-M8-PNP-NC-2MM-M8PLUG | autosen | AI052 |  | One limit switch at each end of travel. Mass not yet checked against the datasheet.
ELC-001 | Limit Switch Cable | M8 3-pin A-coded socket, straight, to open ends, 2 m, PVC, rated for drag chains | electrical | 2 | pc |  | M8-3P-SOCKET-OPEN-2M-DRAGCHAIN | autosen | AA068 |  | One cable per limit switch. Mass not yet checked against the datasheet.
MEC-001 | End Stop Damper | stroke 7 mm; length 16 mm; body 17 mm; impact face 15 mm; 22 mm when fully compressed; M4 stud 4 mm long; 1.7 Nm max; 6 Nm per stroke (9 Nm emergency stop) | mechanical | 4 | pc | 4 |  | ACE | TA17-7 | stoq:ace/ta-damper#TA17-7 | One damper at each corner of the carriage ends. Each is held by an M4 square nut in a slot in carriage-bottom.
SW-002 | Linear Encoder Read Head | RSF AK MC 15 B absolute scanning head, BiSS C, 0.1 um step, 36 x 13.5 x 14.8 mm, 0.5 m cable, 15-pin D-sub; air gap 0.55 +-0.25 mm; 2 x M3 thread 26 mm apart, max 1.2 Nm | electrical | 1 | pc | 51 |  | RSF Elektronik | AK-MC15-B-0.5M-SUBD15 | stoq:rsf/mc15-readhead#AK-MC15-B-0.5M-SUBD15 | On carriage-bottom with two M3 x 16 screws. Set the gap with the 0.55 mm gap foil that comes with the head. Ask RSF for the ID number of the 0.5 m cable before ordering.
SW-003 | Linear Encoder Scale | RSF MC 15 MK absolute steel tape scale, 240 mm measuring length, 260 mm long, tape 8 x 0.25 mm on adhesive tape 6 x 0.2 mm, +-15 um/m | mechanical | 1 | pc | 4 |  | RSF Elektronik | MB-MC15-MK-ML240 | stoq:rsf/mc15-mk-scale#MB-MC15-MK-ML240 | Stuck on the inside of the side wall of the base with the TMT Mx 15 MK mounting tool. No end clamps.
MEC-002 | Roller Bearing | Flanged ball bearing 2 x 6 x 3 mm, flange 7.5 x 0.8 mm, shields on both sides (ZZ) | mechanical | 16 | pc |  | BRG-F692ZZ | NSK | F692ZZ | stoq:nsk/miniature-flanged-metric#F692ZZ | Two in each of the eight seal strip rollers. The flange rests on the end of the roller sleeve. Order the shielded F692ZZ: the open F692 is narrower. NSK gives no mass.
MEC-003 | Roller Axle | Parallel pin ISO 8734, hardened steel, type A, 2 mm (m6) x 28 mm | mechanical | 8 | pc | 0.69 | PIN-ISO8734-2X28-A | ISO | 2X28-A | stoq:iso/iso-8734#2X28-A | The fixed axle of each seal strip roller. Two countersunk screws clamp it against the wall and the floor of the axle slot.
MEC-004 | Roller Washer | Plain washer ISO 7092, size 2 (for M2), 2.2 x 4.5 x 0.3 mm, 200 HV, A2 stainless steel | mechanical | 16 | pc | 0.03 | WSH-ISO7092-2-A2 | ISO | 2-200HV-A2 | stoq:iso/iso-7092#2-200HV-A2 | Two in each seal strip roller, between the inner ring of each bearing and the pocket wall.
MEC-005 | Strip Preload Screw | Hexagon socket countersunk head screw ISO 10642, M4 x 10, A2 stainless steel | mechanical | 2 | pc |  | SCR-ISO10642-M4X10-A2 | ISO | M4x10-A2 |  | Fitting tool. One at each end of the seal strip. Its cone pushes the outer edge of the strip hole and so sets the pull. Taken out after the corner screws are tight. Mass not yet checked.
MEC-006 | Strip Corner Screw | Hexagon socket button head screw with collar ISO 7380-2, M4 x 10, A2 stainless steel | mechanical | 4 | pc |  | SCR-ISO7380-2-M4X10-A2 | ISO | M4x10-A2 |  | One at each corner of the seal strip. Clamps the strip ear on the base after the pull is set. Mass not yet checked.
MEC-007 | Magnet Strip Long | Neodymium magnet tape, self-adhesive, 3 x 0.5 mm, cut to 417.5 mm | mechanical | 2 | pc |  | MAG-TAPE-3X0.5-L417.5 | generic | 3X0.5X417.5 | stoq:generic/ndfeb-magnet-tape#3X0.5X417.5 | One on each long side of the magnet ring in the base, adhesive face down on the ring floor. It holds the seal strip flat. Cut from the roll 3X0.5X500: order 3 rolls per base (one roll gives one long and three short pieces, the third roll two short pieces). The seller gives no mass.
MEC-008 | Magnet Strip Short | Neodymium magnet tape, self-adhesive, 3 x 0.5 mm, cut to 21.5 mm | mechanical | 8 | pc |  | MAG-TAPE-3X0.5-L21.5 | generic | 3X0.5X21.5 | stoq:generic/ndfeb-magnet-tape#3X0.5X21.5 | Four in each end leg of the magnet ring, one on each piece of solid floor between a corner cavity, a damper slot and the split at the preload screw. Adhesive face down. Cut from the roll 3X0.5X500 (see MEC-007). The seller gives no mass.
