refaqt/aqtuator/modules/compact-stage/cad/params/default.csv

alias | value | unit | basis | source | description
roller_d | 10 | mm | design | docs/decisions/2026-10-28_seal-strip-rollers-on-flanged-ball-bearings.md | Outside diameter of a seal strip roller. The same as roller_d in carriage-bottom Sketch013
roller_l | 20 | mm | design | docs/decisions/2026-10-28_seal-strip-rollers-on-flanged-ball-bearings.md | Length of a seal strip roller over the two bearing flanges. The same as roller_l in carriage-bottom Sketch013
bearing_d_out | 6 | mm | catalogue | stoq:nsk/miniature-flanged-metric#F692ZZ outer_d | Outside diameter of the F692ZZ bearing: the hole of the sleeve
bearing_flange_w | 0.8 | mm | catalogue | stoq:nsk/miniature-flanged-metric#F692ZZ flange_c1 | Width of the F692ZZ flange. The flange rests on the end of the sleeve
sleeve_l | =roller_l - 2 * bearing_flange_w | mm |  |  | Length of the sleeve: the roller length without the two flanges
strip_t | 0.15 | mm | design | docs/decisions/2026-10-28_seal-strip-0-15-mm.md | Thickness of the seal strip. The strip pocket in the base is as deep
strip_end_gap | 1 | mm | design | Niels Bosmans 2026-10-29 | Room between each end of the seal strip and the end face of the base
strip_edge_gap | 0.2 | mm | design | base Pocket005 | Room between the seal strip outline and the wall of its pocket in the base. The pocket body is 186 mm wide; the strip 185.6 mm. The strip keeps 0.2 mm to the slope openings of the carriage (186 mm) on each side
strip_corner_hole_d | 4.5 | mm | design | ISO 273 medium for M4 | Width of the slot in each strip corner for the ISO 7380-2 M4 clamp screw
strip_corner_slot_l | 1 | mm | design | Niels Bosmans 2026-10-30 | Length of each corner slot along X (centre to centre). It is centred on the screw. So the strip can slide 0.5 mm each way under the collar while the preload is set. The 45° steps of the strip ears sit half this length further towards the strip ends than the pocket steps; so the strip keeps strip_edge_gap at the steps over the whole slide
strip_preload_hole_d | 5 | mm | design | simulation/cases/strip-seal-fit | Hole at each strip end for the ISO 10642 M4 preload screw. It sits off the screw axis towards the strip middle
strip_pull | 270 | N | design | simulation/cases/strip-seal-fit | Pull in the seal strip after the preload screws are tight. No carriage contact from 190 to 350 N
cooling_block_gap | 0.15 | mm | design | carriage-bottom Sketch037 | Room on each side between the printed cooling block and the wall of its pocket in carriage-bottom
cooling_block_top_gap | 0.1 | mm | design | carriage-bottom Pad | Room between the top of the cooling block and the top face of carriage-bottom. The seal strip runs 1 mm above that face
port_oring_id | 5 | mm | catalogue | ERIKS O-ring NBR 70 36624 5x1.5 | Inside diameter of the O-ring that seals each cooling port between the block and the pocket floor
port_oring_cs | 1.5 | mm | catalogue | ERIKS O-ring NBR 70 36624 5x1.5 | Cross-section of the port O-ring
port_groove_depth | 1.1 | mm | design | Face seal 25 to 30 % squeeze | Depth of the port O-ring groove in the bottom of the block
port_groove_w | 2.0 | mm | design | Face seal groove width about 1.35 x cross-section | Width of the port O-ring groove. The outer wall touches the O-ring outside diameter; water pushes from inside
cooling_passage_d | 2.0 | mm | design |  | Diameter of the water passages inside the cooling block. With the port groove under it and the top over it | it leaves 0.9 mm walls
hose_od | 4 | mm | catalogue | stoq:festo/pun-h#197383 | Outside diameter of the cooling hose (Festo PUN-H-4X0 | 75)
hose_id | 2.6 | mm | catalogue | stoq:festo/pun-h#197383 | Inside diameter of the cooling hose (Festo PUN-H-4X0 | 75)
carriage_top_z | 27.5 | mm | design | carriage-bottom Pad | Height of the top face of carriage-bottom above its bottom face
carriage_edge_x | 208 | mm | design | carriage-bottom w_carrier | X of the side face of carriage-bottom where the hoses and cables leave
cooling_pocket_depth | 5 | mm | design | carriage-bottom Pocket024 | Depth of the cooling block pocket in the top of carriage-bottom
cooling_body_x0 | 108.5 | mm | design | carriage-bottom Sketch037 block_x3 | Left end of the cooling block pocket
cooling_body_y0 | 78.5 | mm | design | carriage-bottom Sketch037 block_y0 | Lower side of the wide part of the cooling block pocket
cooling_body_y1 | 100.5 | mm | design | carriage-bottom Sketch037 block_y2 | Upper side of the wide part of the cooling block pocket
cooling_body_r | 3 | mm | design | 6 mm end mill | Corner radius of the wide part of the pocket
cooling_arm_w | 12 | mm | design | docs/decisions/2026-11-09_cooling-block-to-the-edge-with-festo-fittings.md | Width of the arm of the pocket from the wide part to the side face
cooling_arm_x0 | 150 | mm | design | docs/decisions/2026-11-09_cooling-block-to-the-edge-with-festo-fittings.md | X where the centre line of the arm leaves the wide part
cooling_arm_y0 | =(cooling_body_y0 + cooling_body_y1) / 2 | mm |  |  | Y of the centre line of the wide part. The screws in the wide part sit on it
cooling_arm_bend_x | 186 | mm | design | docs/decisions/2026-11-09_cooling-block-to-the-edge-with-festo-fittings.md | X where the centre line of the arm turns parallel to X
cooling_arm_y | 100.5 | mm | design | docs/decisions/2026-11-09_cooling-block-to-the-edge-with-festo-fittings.md | Y of the centre line of the arm at the side face. Between the carriage-top joint screw (y 90) and the motor cable slot (y 110)
cooling_arm_r | 10 | mm | design | Niels Bosmans 2026-11-09 (a fluent curved pocket) | Radius of the four bends of the arm
cooling_end_r | 3 | mm | design | 6 mm end mill | Corner radius at the open end of the arm pocket
cooling_pocket_end_x | =carriage_edge_x + 4 | mm |  |  | End of the arm pocket outside the side face: the pocket is open to the side
port_a_x | 118.35 | mm | design | carriage-bottom Sketch039 port_a_x | X of cooling port A (end of the port lead)
port_a_y | 84.5 | mm | design | carriage-bottom Sketch039 port_a_y | Y of cooling port A
port_b_x | 114.25 | mm | design | carriage-bottom Sketch039 port_b_x | X of cooling port B (on the second channel pass)
port_b_y | 94.5 | mm | design | carriage-bottom Sketch039 port_b_y | Y of cooling port B
cooling_passage_offset | 3.5 | mm | design | docs/decisions/2026-11-09_cooling-block-to-the-edge-with-festo-fittings.md | Distance from the centre line of the arm to each water passage. Leaves 1.5 mm to the tapped screw holes on the centre line
cooling_screw_a_x | 128 | mm | design | carriage-bottom Hole006 | X of the first block screw in the wide part
cooling_screw_b_x | 140 | mm | design | carriage-bottom Hole007 | X of the second block screw in the wide part
cooling_screw_c_x | 198 | mm | design | docs/decisions/2026-11-09_cooling-block-to-the-edge-with-festo-fittings.md | X of the block screw near the side face. Niels Bosmans 2026-11-09: one screw here. 6 mm of carriage-bottom under the arm | open from below
cooling_screw_d | 2.5 | mm | catalogue | ISO 10642 M2.5 | Nominal diameter of the M2.5 block screws
cooling_tap_depth | 4 | mm | design | 2026-11-06 cooling block | Depth of the M2.5 holes tapped in the printed block
fit_thread_d | 5 | mm | catalogue | https://ftp.festo.com/public/PNEUMATIC/SOFTWARE_SERVICE/Documentation/2025/JA/NPQH_EN.PDF | M5 thread of the Festo NPQH-D-M5-Q4-P10 (page 5 D1)
fit_thread_l | 4 | mm | catalogue | https://ftp.festo.com/public/PNEUMATIC/SOFTWARE_SERVICE/Documentation/2025/JA/NPQH_EN.PDF | Thread length of the NPQH-D-M5-Q4-P10 (page 5 L2)
fit_hex_af | 9 | mm | catalogue | https://ftp.festo.com/public/PNEUMATIC/SOFTWARE_SERVICE/Documentation/2025/JA/NPQH_EN.PDF | Hex of the NPQH-D-M5-Q4-P10 across flats (page 5)
fit_tap_depth | 5 | mm | design | docs/decisions/2026-11-09_cooling-block-to-the-edge-with-festo-fittings.md | Depth of the M5 tapped hole: thread length plus 1 mm
fit_wall | 2 | mm | design | Niels Bosmans 2026-11-09 | Printed wall around each M5 thread
fit_pitch | 11 | mm | design | docs/decisions/2026-11-09_cooling-block-to-the-edge-with-festo-fittings.md | Distance between the two fittings. The hex is 10.4 mm across corners; an internal 2.5 mm hex key tightens them
fit_head_l | =fit_tap_depth + 4 | mm |  |  | Length of the head of the block outside the side face
fit_head_r | 2 | mm | design |  | Corner radius of the head in the plan view
fit_jog_x0 | =carriage_edge_x + 1 | mm |  |  | Where each passage leaves the arm line and turns towards its fitting
fit_jog_x1 | =carriage_edge_x + 3.5 | mm |  |  | Where each passage is on the axis of its fitting
motor_cable_d | 8.3 | mm | catalogue | MK21 data sheet | Outside diameter of the MK21 motor cable
read_head_cable_d | 3.7 | mm | catalogue | docs/log/2026-11-06_forcer-water-cooling-seal-and-block.md | Outside diameter of the read head cable
motor_cable_y | 114.5 | mm | design | carriage-bottom Sketch025 | Y of the motor cable slot centre line at the side face
read_head_cable_y | 124 | mm | design | carriage-bottom Sketch030 | Y of the read head slot centre line
cable_clamp_l | 10 | mm | design | docs/decisions/2026-11-09_cooling-block-to-the-edge-with-festo-fittings.md | Length of a cable clamp along the cable. It ends flush with the side face
cable_clamp_side_gap | 0.1 | mm | design | Niels Bosmans 2026-11-09 | Room between a cable clamp and the walls of its cable slot on each side
cable_clamp_squeeze | 0.2 | mm | design | Niels Bosmans 2026-11-09 | How much higher the clamp stack (both halves and the cable) is than its cable slot is deep
motor_cable_dip | 5 | mm | design | docs/decisions/2026-11-09_cooling-block-to-the-edge-with-festo-fittings.md | Extra depth of the motor cable slot in its bend. The cable stays low under the cooling block
carriage_side_bottom_z | 16.5 | mm | design | carriage-bottom Pocket010 (up to face) | Height of the underside of carriage-bottom near the side face
screw_recess_depth | 0.3 | mm | design | carriage-bottom Pocket028 | Recess under each countersunk screw head in the underside of carriage-bottom
motor_cable_bend_x | 186.75 | mm | design | carriage-bottom Sketch025 | X of the centre of the motor cable bend
motor_cable_bend_y | 79.5 | mm | design | carriage-bottom Sketch025 | Y of the centre of the motor cable bend
motor_slot_w | 9 | mm | design | carriage-bottom Sketch025 | Width of the motor cable slot
motor_slot_depth | 9 | mm | design | carriage-bottom Pocket014 | Depth of the motor cable slot
motor_cable_dip_start | 5 | deg | design | docs/decisions/2026-11-09_cooling-block-to-the-edge-with-festo-fittings.md | Where the deeper part of the motor cable slot starts | measured round the bend from where the bend is parallel to Y. Keeps its rounded end 2 mm away from the step in the underside of carriage-bottom at x = 191 mm
motor_cable_dip_angle | 45 | deg | design | docs/decisions/2026-11-09_cooling-block-to-the-edge-with-festo-fittings.md | Part of the bend (from where the bend is parallel to Y) that is motor_cable_dip deeper
read_head_slot_w | 6 | mm | design | carriage-bottom Sketch030 | Width of the read head cable slot
read_head_slot_depth | 5 | mm | design | carriage-bottom Pocket019 | Depth of the read head cable slot
