refaqt/aqtuator/(list of files, cad)

Other CAD files:
modules/compact-stage/cad/assemblies/compact-stage/compact-stage.FCStd
modules/compact-stage/cad/assemblies/roller/roller.FCStd
modules/compact-stage/cad/parts/base/base.FCStd
modules/compact-stage/cad/parts/carriage-bottom/carriage-bottom.FCStd
modules/compact-stage/cad/parts/carriage-top/carriage-top.FCStd
modules/compact-stage/cad/parts/cooling-block/cooling-block.FCStd
modules/compact-stage/cad/parts/motor-cable-clamp/motor-cable-clamp.FCStd
modules/compact-stage/cad/parts/read-head-cable-clamp/read-head-cable-clamp.FCStd
modules/compact-stage/cad/parts/roller-sleeve/roller-sleeve.FCStd
modules/compact-stage/cad/parts/sealing-clamp/sealing-clamp.FCStd
modules/compact-stage/cad/parts/sealing-strip/sealing-strip.FCStd
