refaqt/aqtuator/manufacturing/README.md

# Manufacturing

Fabrication drawings, CAM and assembly guides. Not yet populated.
