refaqt/aqtuator/docs/log/2025-11-04_servo-motor-setup.md

# 2025-11-04 — Servo motor setup

**Role(s):** engineering

- Setup servo motor

  - Position measurement (RS485_encoder_group0 \> raw):

    - 1/(0.52716105-0.52709941) = 16223.232

      - Ok

  - Raw32 is the bit-value and is most accurate

- Spinout error

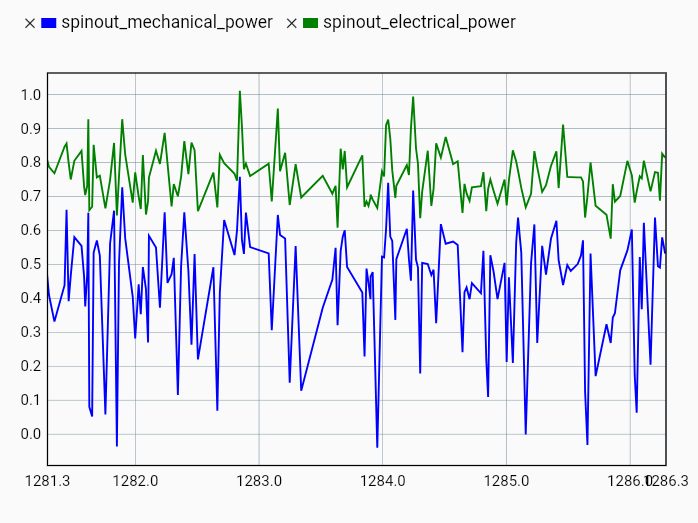
[picture p55: docs/log/images/2025-11-04-01.png]
  - Velocity control, 0.5 Gain

  - Velocity control, 0.8 gain

    - \
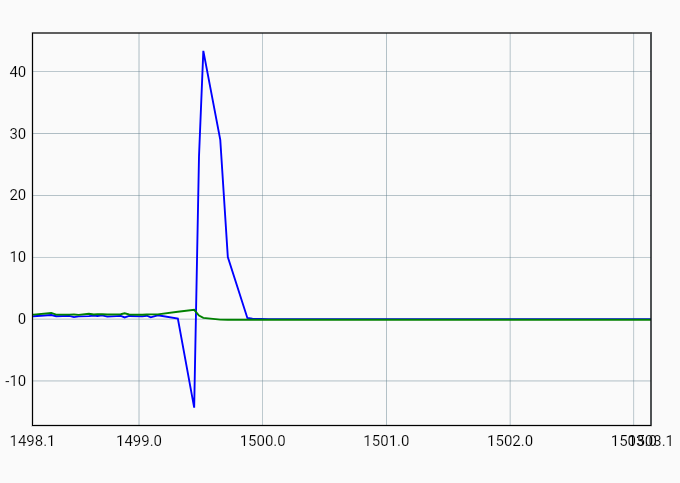
[picture p56: docs/log/images/2025-11-04-03.png]
      

    - Increase limits to mechanical power spinout limit to -20:\
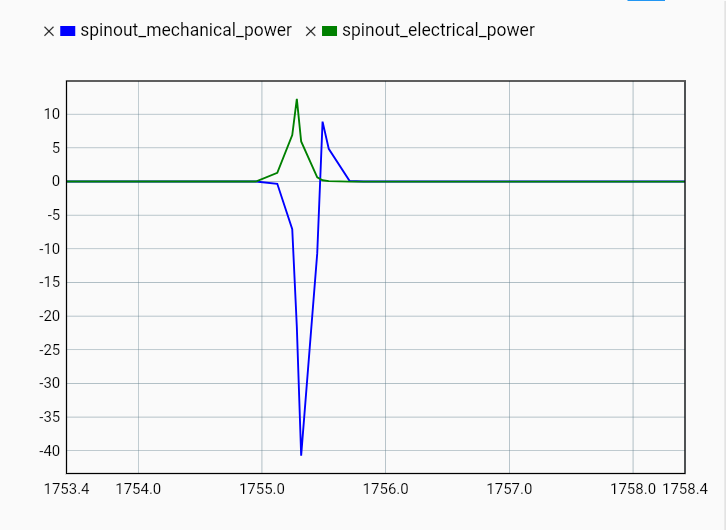
[picture p57: docs/log/images/2025-11-04-04.png]
      

    - Increase limits to mechanical power spinout limit to -100:\
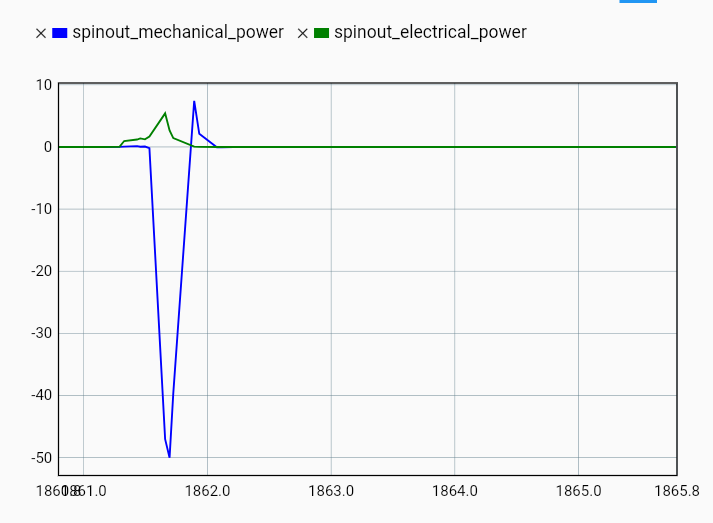
[picture p58: docs/log/images/2025-11-04-05.png]
