refaqt/aqtuator/builds/README.md

# Builds

Lockfiles pinning module versions for physical machine instances. Not yet populated.
See [`doqs/docs/architecture.md`](../doqs/docs/architecture.md).
