refaqt/aqtuator/simulation/results/README.md

# Simulation results

One folder per case, each with a `summary.md`. Heavy exports are gitignored.
