refaqt/aqtuator/modules/flexure-ball-screw-servo-stage/firmware/adc-test/README.md

# adc-test

6-channel 8 kHz ADC acquisition test using the RP2040 ADC and the MCP3564RT on the Controllino
MICRO. Reference for the acquisition path in
[`../torque-excitation`](../torque-excitation/); not part of any workflow.
