refaqt/aqtuator/docs/log/2025-10-06_experiment-parameters-tool-stickout.md

# 2025-10-06 — Experiment parameters tool stickout

**Role(s):** engineering

- Paramaters of following experiments

  - Tool stickout 26.77 mm

  - [<u>https://www.fraeser-shop.de/vhm-hpc-fraeser-alu-ohne-fase-6-mm-hp-al3l-dlc-060ha.html</u>](https://www.fraeser-shop.de/vhm-hpc-fraeser-alu-ohne-fase-6-mm-hp-al3l-dlc-060ha.html)

- Slotting experiments - X-direction

  - S24000, F1800 (f0.025)

    - Ap 1 mm

      - High-frequency chatter

  - S20000, F1500 (f0.025)

    - Ap 1 mm

      - Same high-frequency chatter

  - S24000, F1800

    - Ap 2 mm

      - High frequency chatter worse than at Ap 1 mm

      - Chatter marks approximately 1.5 per mm

        - ~45 Hz (I didn’t hear this low frequency)

- Ap 2 mm, Ae 5mm

  - S24000, F1800

    - High-frequency chatter

    - Caused by rubbing at entry of tool?

- Ap 2 mm, Ae 3 mm

  - S24000, F1800

    - No chatter

- Previous experiments had a broken tool (small corner broken on tool tip

- Ap 4mm, Ae 6mm

  - S24000, F1800

    - No chatter! Best result so far!

- Experiments

  - Tool

    - [<u>https://www.phantom.eu/nl-nl/producten/frezen-hss-vhm/schachtfrezen-ruwprofiel/alu-vhm-ruwfrees/35540-phantom-volhardmetaal-ruwfrees-aluminium-lang-rond/355400600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</u>](https://www.phantom.eu/nl-nl/producten/frezen-hss-vhm/schachtfrezen-ruwprofiel/alu-vhm-ruwfrees/35540-phantom-volhardmetaal-ruwfrees-aluminium-lang-rond/355400600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)

    - Phantom <span class="mark">355400600</span>

    - <span class="mark">Stickout: 26.22 mm</span>

  - <span class="mark">Common Cutting parameters</span>

    - <span class="mark">S14000</span>

    - <span class="mark">F2100</span>

    - <span class="mark">Ae 6 mm</span>

  - <span class="mark">Experiment 1</span>

    - <span class="mark">Pars</span>

      - <span class="mark">f 0.05 mm</span>

      - <span class="mark">F2100</span>

    - <span class="mark">Ap 2mm</span>

      - <span class="mark">High frequency chatter (tool broken?)</span>

    - <span class="mark">Ap 4mm</span>

      - <span class="mark">Spindle stops and gets stuck</span>

  - <span class="mark">Experiment 2</span>

    - <span class="mark">Pars</span>

      - <span class="mark">F 0.025</span>

      - <span class="mark">F1050</span>

    - <span class="mark">Ap 4mm</span>

      - <span class="mark">Spindle slows down and in the end gets stuck</span>

        - <span class="mark">Broken tool? Nothing visible…</span>

- <span class="mark">Experiments</span>

  - <span class="mark">Tool</span>

    - <span class="mark">Blue-Master FT73 D6</span>

      - [<span class="mark"><u>https://www.bluemaster.es/assets/media/26_CATALOGUE_BM_TECHNICAL_INFORMATION.pdf</u></span>](https://www.bluemaster.es/assets/media/26_CATALOGUE_BM_TECHNICAL_INFORMATION.pdf)

      - <span class="mark">[<u>https://www.bluemaster.es/assets/media/09_CATALOGUE_BM_END_MILLS.pdf</u>](https://www.bluemaster.es/assets/media/09_CATALOGUE_BM_END_MILLS.pdf)</span>

      - <span class="mark">3 flutes</span>

      - <span class="mark">D6 mmm</span>

  - <span class="mark">Parameters</span>

    - <span class="mark">S10000</span>

    - <span class="mark">f0.04 mm/tooth</span>

    - <span class="mark">Ae 6 mm</span>

    - <span class="mark">Tool stickout approx 25 mm</span>

  - <span class="mark">Experiment 1</span>

    - <span class="mark">Ap 2mm</span>

      - <span class="mark">Chatter</span>

- <span class="mark">Experiments</span>

  - <span class="mark">Tool</span>

    - <span class="mark">Phantom 36.130.0602</span>

      - [<span class="mark"><u>https://www.phantom.eu/nl-nl/producten/frezen-hss-vhm/schachtfrezen-gladde-snijkant/alu-z1-vhm-frees/36130-phantom-volhardmetaal-eensnijderfrees-aluminium-21-/361300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</u></span>](https://www.phantom.eu/nl-nl/producten/frezen-hss-vhm/schachtfrezen-gladde-snijkant/alu-z1-vhm-frees/36130-phantom-volhardmetaal-eensnijderfrees-aluminium-21-/361300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)

  - <span class="mark">Parameters</span>

    - <span class="mark">S24000</span>

    - <span class="mark">f0.017 mm/tooth</span>

    - <span class="mark">Ae 6 mm</span>

    - <span class="mark">Tool stickout 25 mm</span>

  - <span class="mark">Experiment 1</span>

    - <span class="mark">Ap 2 mm</span>

      - <span class="mark">No chatter</span>

    - <span class="mark">Ap 3 mm</span>

      - <span class="mark">Chatter</span>

- <span class="mark">Experiments</span>

  - <span class="mark">Tool</span>

    - <span class="mark">Hans Treiber / Fortis 19144060</span>

      - [<span class="mark"><u>https://www.fraeser-shop.de/vhm-schaftfraeser-kurz-scharfkantig-ohne-fase-6-mm-19144060.html</u></span>](https://www.fraeser-shop.de/vhm-schaftfraeser-kurz-scharfkantig-ohne-fase-6-mm-19144060.html)

  - <span class="mark">Left 150 mm side of the vacuum table</span>

  - <span class="mark">Parameters</span>

    - <span class="mark">S14000</span>

    - <span class="mark">F1008 mm/min</span>

    - <span class="mark">f0.024 mm/tooth</span>

    - <span class="mark">Tool stickout 25 mm</span>

    - <span class="mark">Ae 6mm</span>

  - <span class="mark">Ap 2mm</span>

    - <span class="mark">Chatter</span>
