refaqt/aqtuator/docs/log/2025-10-10_tool-experiments.md

# 2025-10-10 — Tool experiments

**Role(s):** engineering

- <span class="mark">Experiments</span>

  - <span class="mark">Tool</span>

    - <span class="mark">Hans Treiber / Fortis 19144060</span>

      - [<span class="mark"><u>https://www.fraeser-shop.de/vhm-schaftfraeser-kurz-scharfkantig-ohne-fase-6-mm-19144060.html</u></span>](https://www.fraeser-shop.de/vhm-schaftfraeser-kurz-scharfkantig-ohne-fase-6-mm-19144060.html)

  - <span class="mark">Right 150 mm side of the vacuum table</span>

  - <span class="mark">Parameters</span>

    - <span class="mark">S14000</span>

    - <span class="mark">F1008 mm/min</span>

    - <span class="mark">f0.024 mm/tooth</span>

    - <span class="mark">Tool stickout 25 mm</span>

    - <span class="mark">Ae 6mm</span>

  - <span class="mark">Ap 1mm</span>

    - <span class="mark">Chatter</span>

- <span class="mark">Experiments</span>

  - <span class="mark">Tool</span>

    - <span class="mark">Hans Treiber / Fortis 19144060</span>

      - [<span class="mark"><u>https://www.fraeser-shop.de/vhm-schaftfraeser-kurz-scharfkantig-ohne-fase-6-mm-19144060.html</u></span>](https://www.fraeser-shop.de/vhm-schaftfraeser-kurz-scharfkantig-ohne-fase-6-mm-19144060.html)

  - <span class="mark">Right 150 mm side of the vacuum table</span>

  - <span class="mark">Parameters</span>

    - <span class="mark">S24000</span>

    - <span class="mark">F11800 mm/min</span>

    - <span class="mark">f0.025 mm/tooth</span>

    - <span class="mark">Tool stickout 25 mm</span>

    - <span class="mark">Ae 6mm</span>

  - <span class="mark">Ap 1mm</span>

    - <span class="mark">No chatter</span>

  - <span class="mark">Ap 2 mm</span>

    - <span class="mark">Chatter</span>
