refaqt/aqtuator/docs/log/2026-04-24_tap-test-reciprocating-motion.md

# 2026-04-24 — Tap test reciprocating motion

**Role(s):** engineering

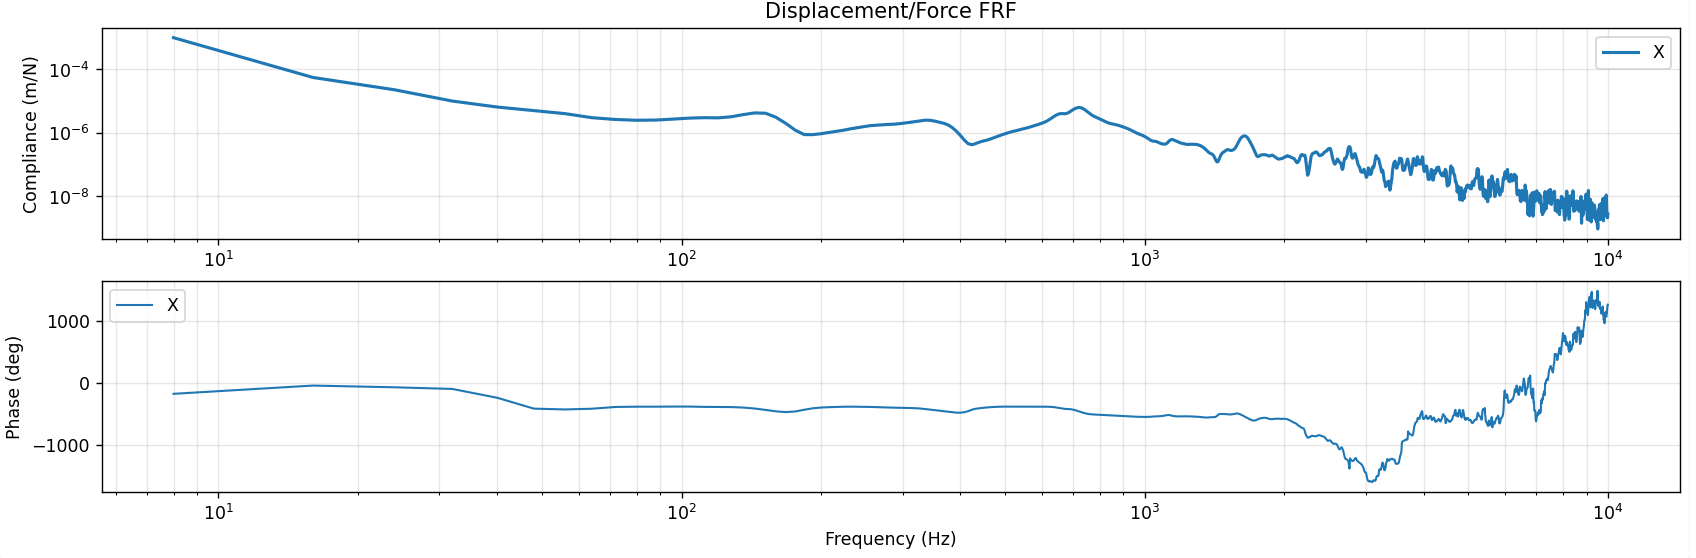
[picture p73: docs/log/images/2026-04-24-01.png]
- Tap test with reciprocating motion of the slide, flexible suspension, X315 Y315 Z60:

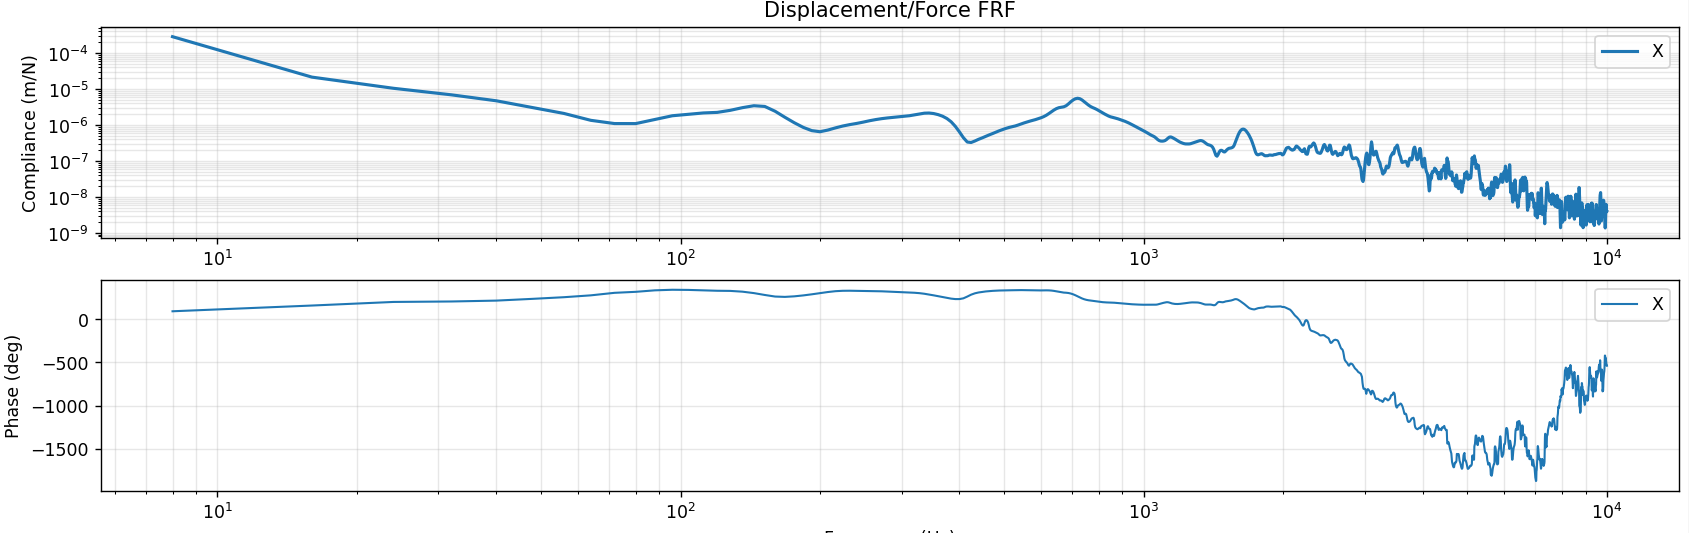
[picture p74: docs/log/images/2026-04-24-02.png]
> 

- Why don’t we see a lot more flexibility?

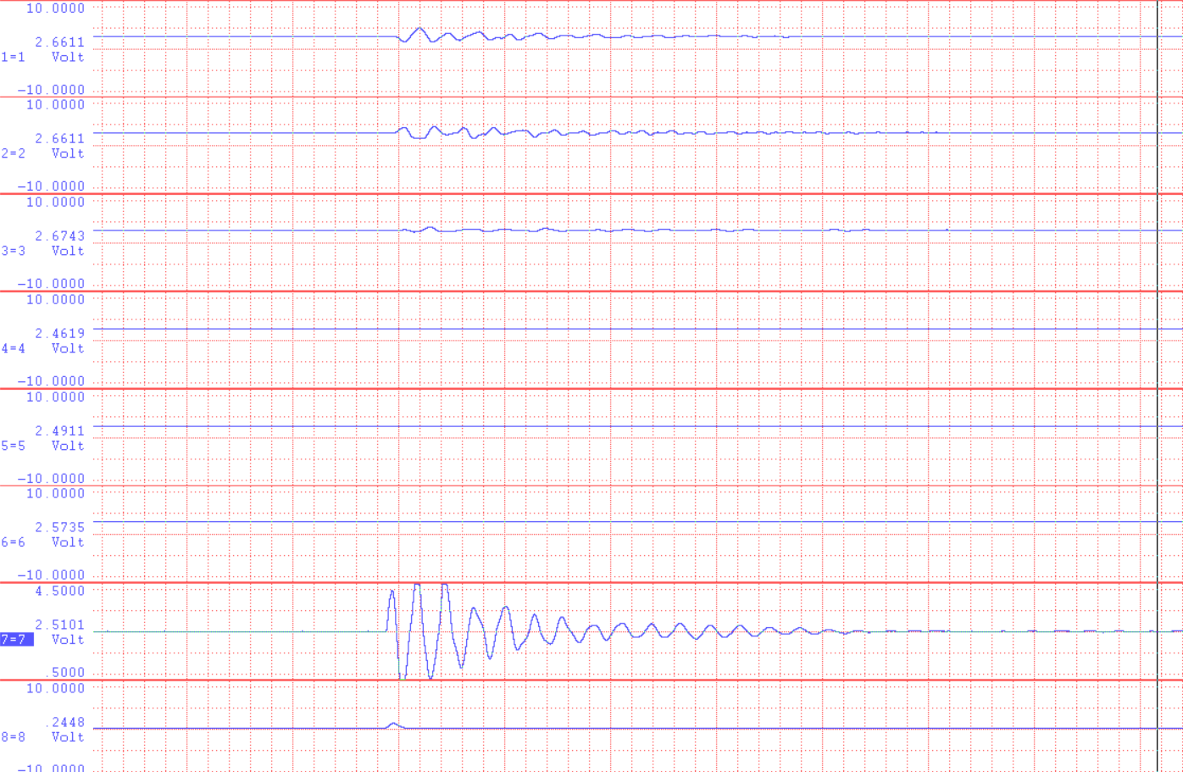
[picture p75: docs/log/images/2026-04-24-03.png]
  - Soft tap 

  - Hard tap\
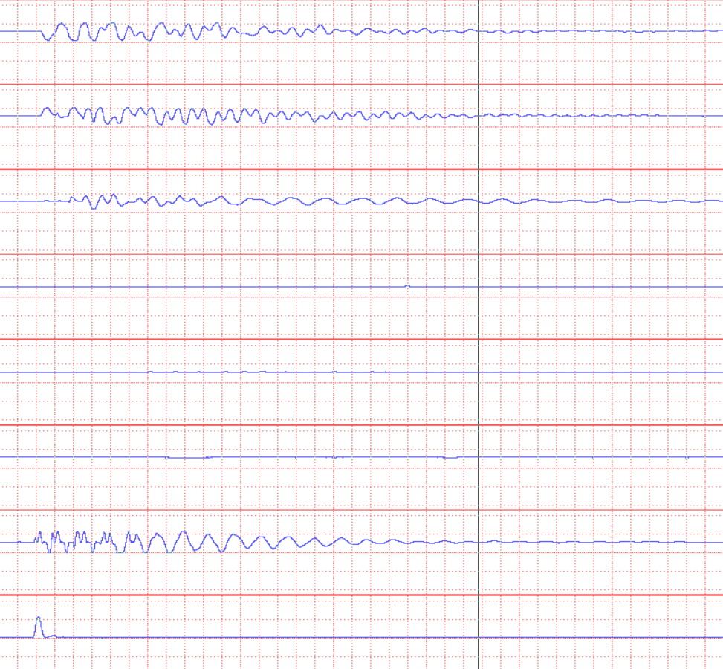
[picture p76: docs/log/images/2026-04-24-04.png]
    

  - The frequency is probably so low that we cannot see the acceleration.

  - Maybe this is why compliance goes up at low frequencies?

- How to test the difference in compliance between all the controllers then?
