refaqt/aqtuator/modules/compact-stage/simulation/results/end-stop-crash/payload-table.csv

payload_kg | com_height_mm | energy_J | bumpers_fully_in | peak_force_bumpers_N | peak_force_metal_N | peak_deceleration_g | block_p_max_N | block_fsl | read_head_m_s2 | base_pocket_mises_MPa | base_pocket_plastic_strain | base_band_mises_MPa | base_band_plastic_strain | base_lasting_dent_mm | payload_slip_use | payload_screw_force_N | payload_joint_opens | base_slip_use | forcer_slip_use
0.0 | 20.0 | 13.4182 | True | 4991.4874 | 0.0 | 103.9314 | 624.5706 | 14.0737 | 1011.9835 | 146.9309 | 0.0 | 0.0 | 0.0 | 0.0 | 0.0 | 0.0 | False | 0.5791 | 0.815
0.0 | 50.0 | 13.4182 | True | 4991.4874 | 0.0 | 103.9314 | 624.5706 | 14.0737 | 1011.9835 | 146.9309 | 0.0 | 0.0 | 0.0 | 0.0 | 0.0 | 0.0 | False | 0.5791 | 0.815
0.0 | 100.0 | 13.4182 | True | 4991.4874 | 0.0 | 103.9314 | 624.5706 | 14.0737 | 1011.9835 | 146.9309 | 0.0 | 0.0 | 0.0 | 0.0 | 0.0 | 0.0 | False | 0.5791 | 0.815
0.0 | 150.0 | 13.4182 | True | 4991.4874 | 0.0 | 103.9314 | 624.5706 | 14.0737 | 1011.9835 | 146.9309 | 0.0 | 0.0 | 0.0 | 0.0 | 0.0 | 0.0 | False | 0.5791 | 0.815
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
