refaqt/aqtuator/modules/compact-stage/simulation/results/end-stop-crash/base-stress.png

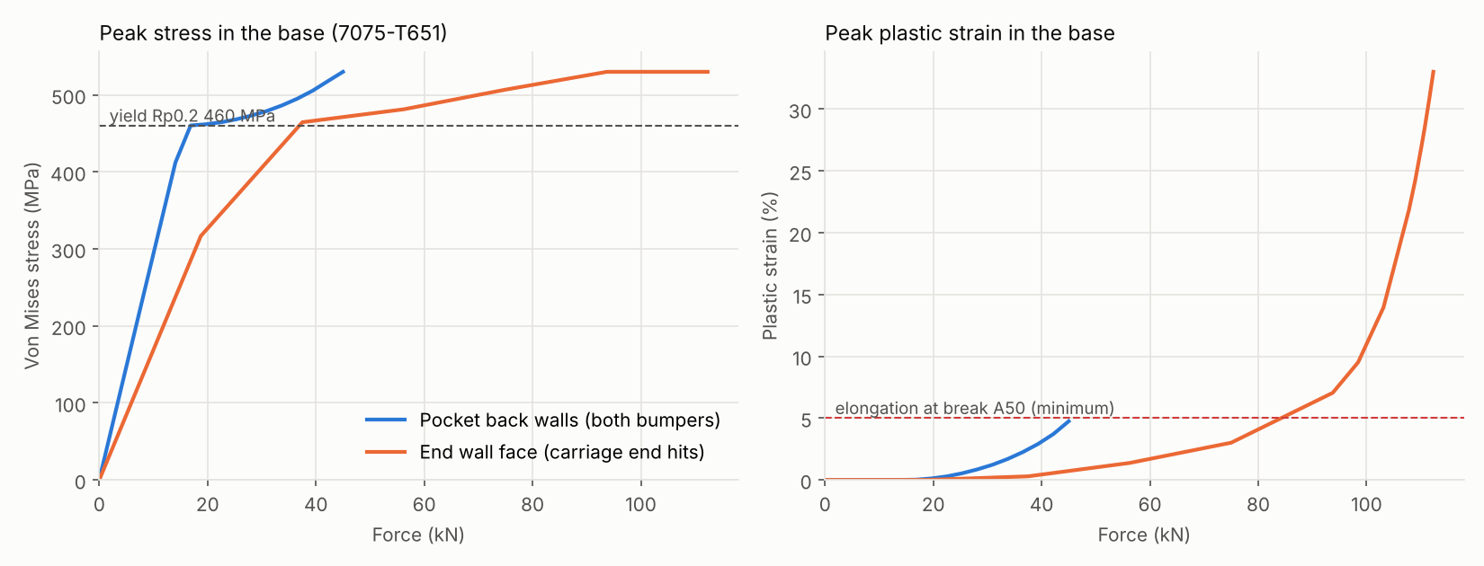
modules/compact-stage/simulation/results/end-stop-crash/base-stress.png
