refaqt/aqtuator/modules/compact-stage/simulation/results/end-stop-crash/payload-table.png

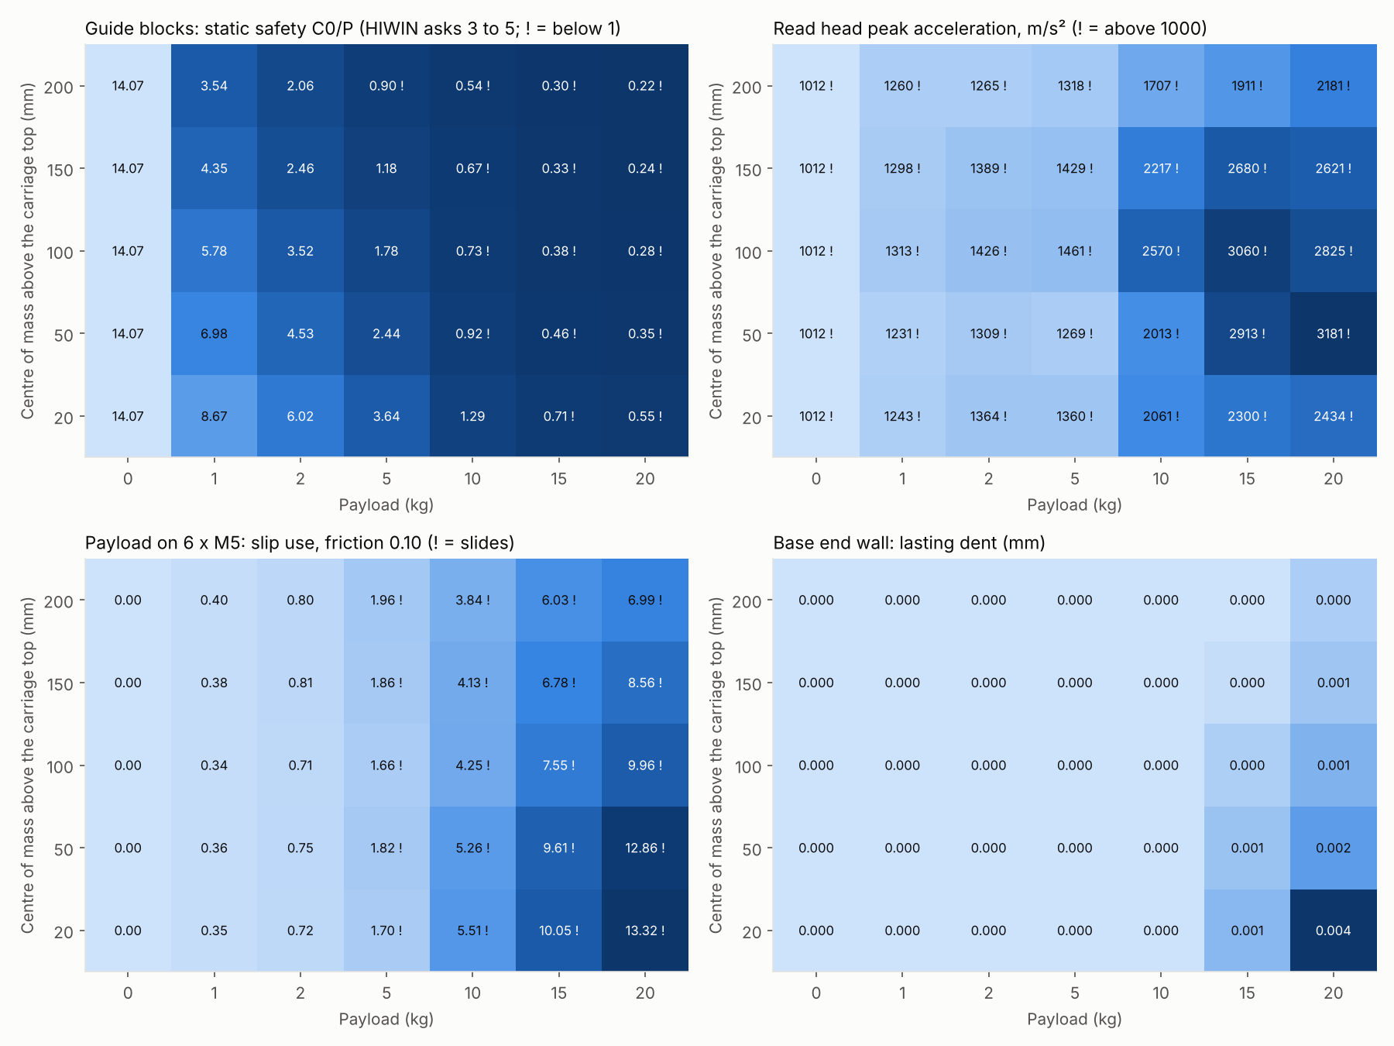
modules/compact-stage/simulation/results/end-stop-crash/payload-table.png
