refaqt/aqtuator/modules/compact-stage/simulation/results/scraper-fit/3d_corner_from_below.png

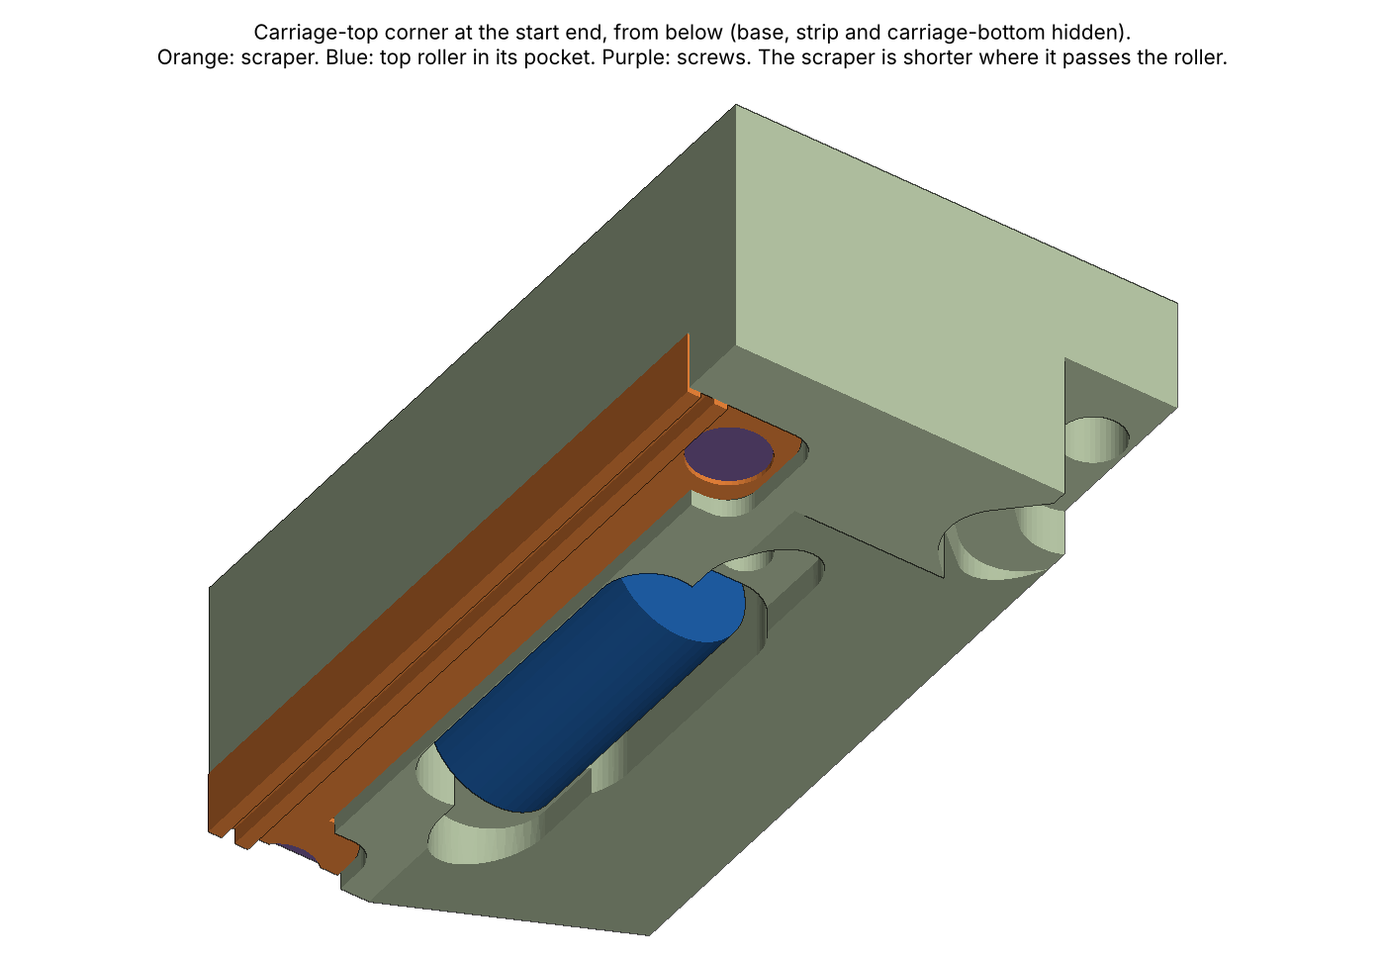
modules/compact-stage/simulation/results/scraper-fit/3d_corner_from_below.png
