refaqt/aqtuator/modules/compact-stage/simulation/results/scraper-fit/3d_scraper_from_below.png

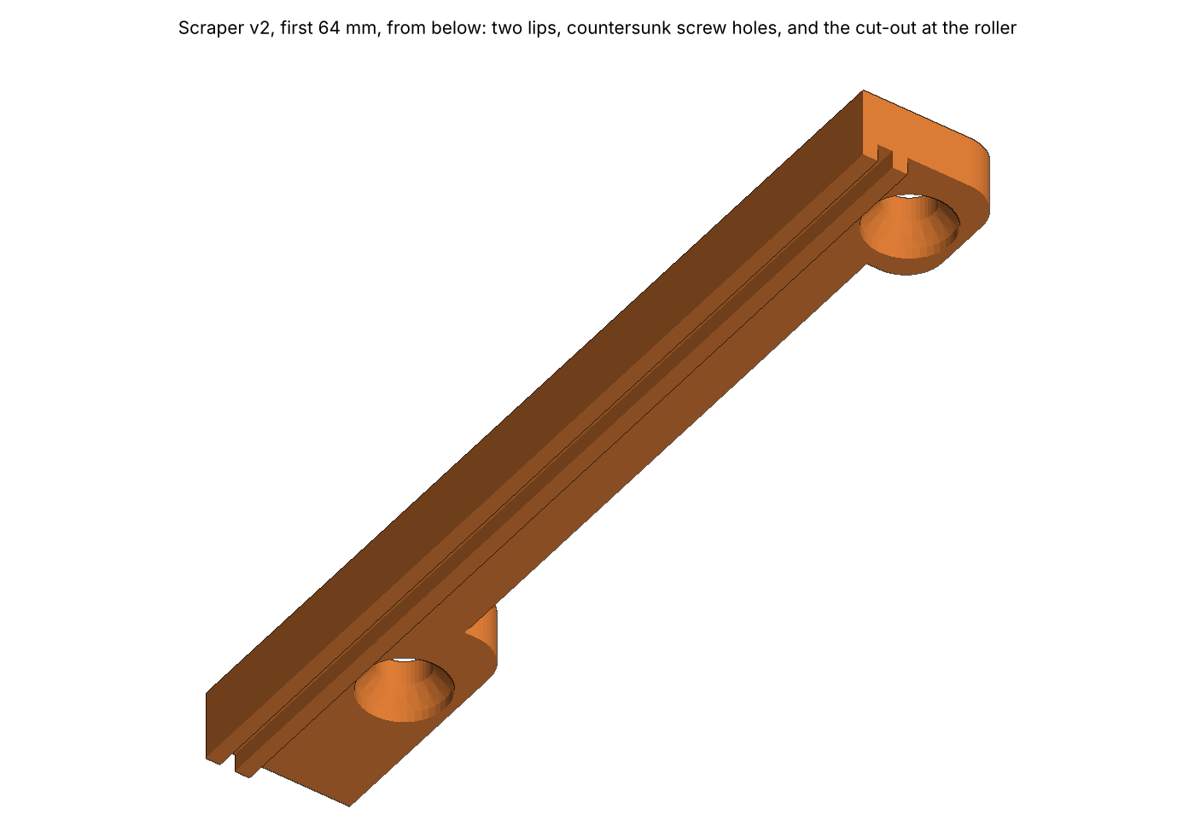
modules/compact-stage/simulation/results/scraper-fit/3d_scraper_from_below.png
