refaqt/aqtuator/modules/compact-stage/simulation/results/scraper-fit/section-B-B_C-C_x.png

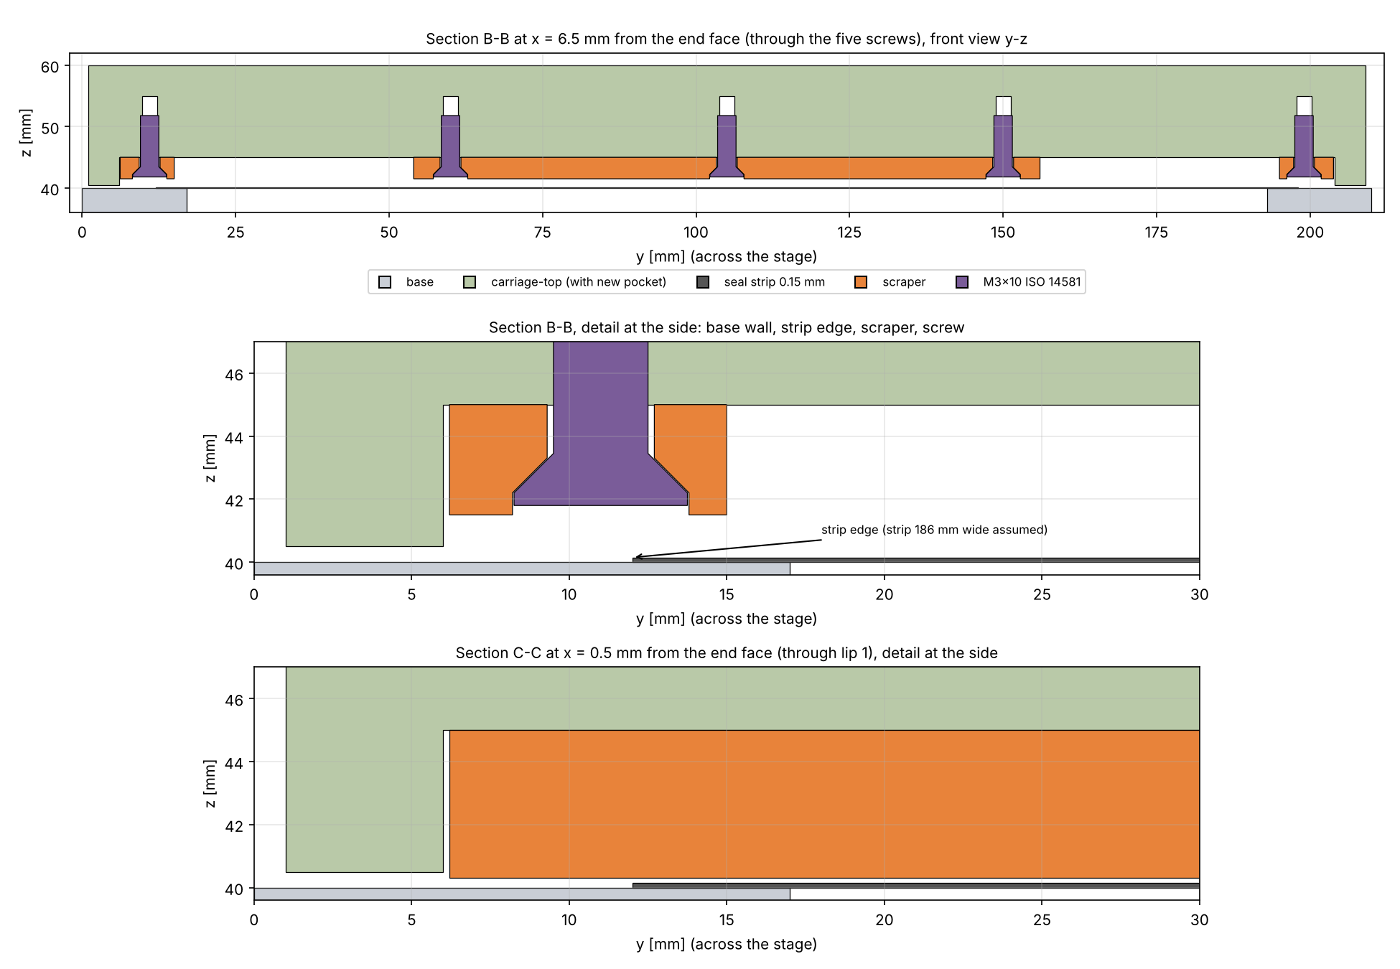
modules/compact-stage/simulation/results/scraper-fit/section-B-B_C-C_x.png
