refaqt/aqtuator/modules/compact-stage/simulation/results/scraper-fit/section-D-D_y34.5_roller.png

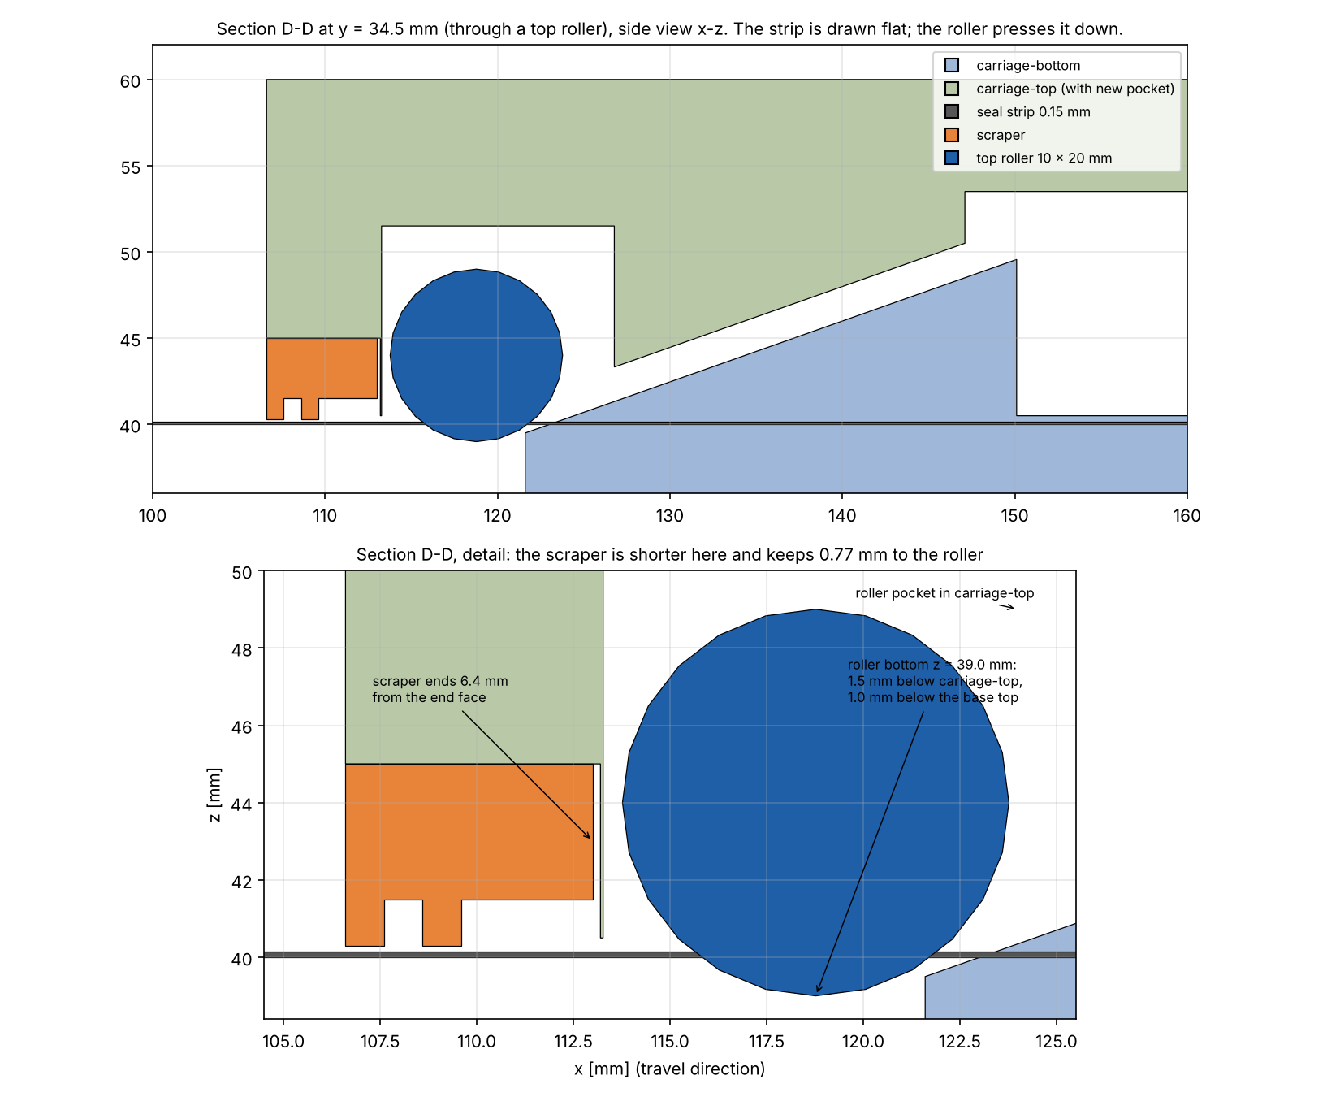
modules/compact-stage/simulation/results/scraper-fit/section-D-D_y34.5_roller.png
