refaqt/aqtuator/modules/compact-stage/simulation/results/strip-end-insert/spring_end.png

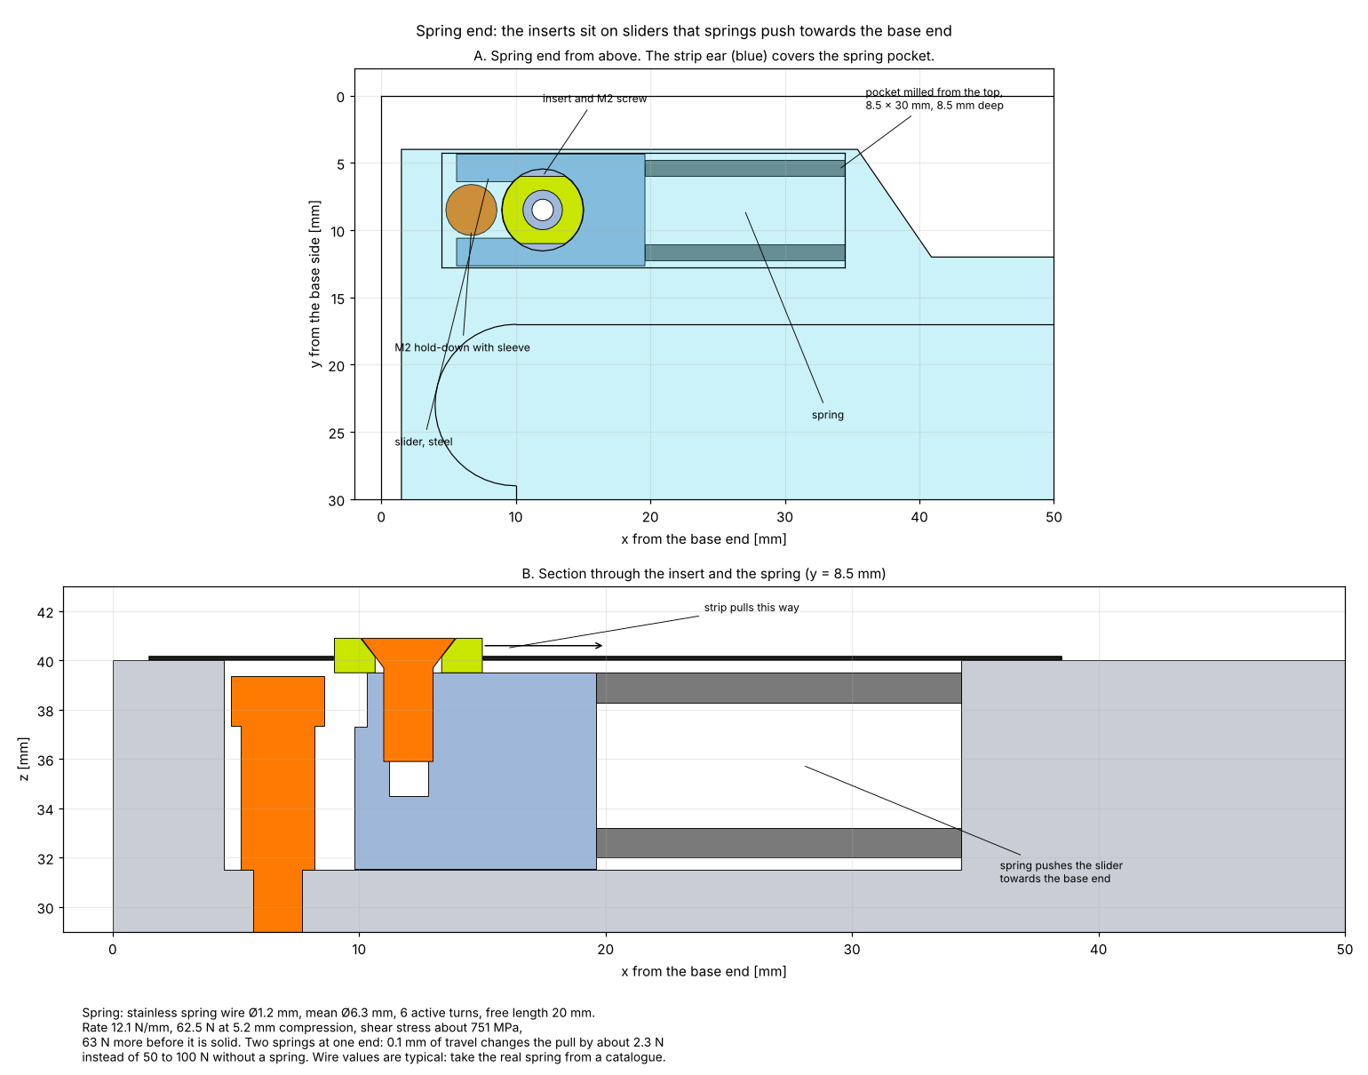
modules/compact-stage/simulation/results/strip-end-insert/spring_end.png
