refaqt/aqtuator/modules/compact-stage/simulation/results/strip-seal-fit/strip_fit.png

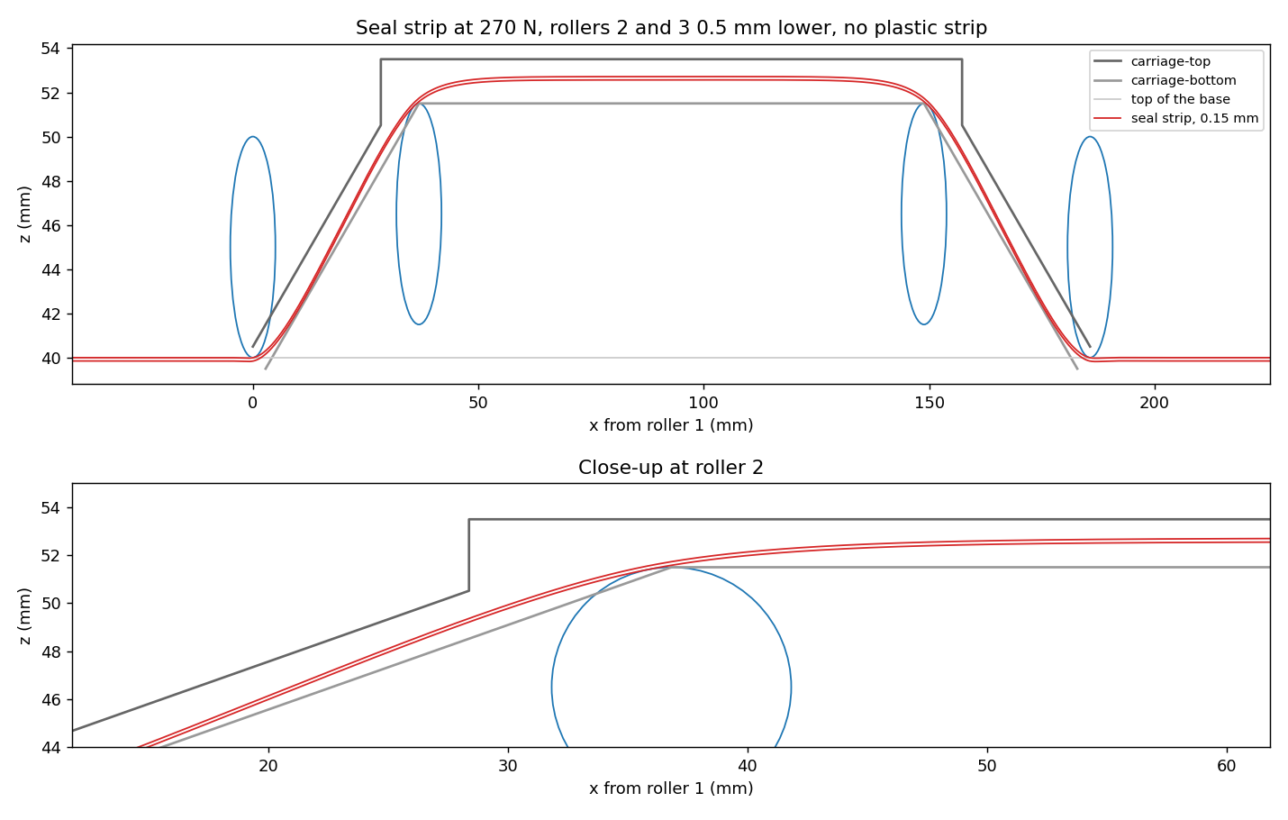
modules/compact-stage/simulation/results/strip-seal-fit/strip_fit.png
