refaqt/aqtuator/docs/decisions/2026-04-17_cansimple-node-id-decode-fix.md

# 2026-04-17 — Fix CANSimple node-id decode and store fresh torque+position pairs

**Context:** The servo-identification firmware filtered incoming CAN frames using an incorrect node-id mask (3 bits), and required torque+position frames to arrive within a 100 µs window. With normal cyclic intervals (e.g. 1–2 ms), this caused frequent acquisition restarts/clears and could yield “position always 0” at the host.\n**Decision:** Decode CANSimple node-id as a 6-bit field (\(0..63\)) and switch capture logic from “tight timing pair” to “store a sample only once both torque and position have updated since the last stored sample.”\n**Alternatives considered:** Increasing the 100 µs window, restarting acquisition on missing frames, or explicitly requesting frames from the microcontroller instead of relying on ODrive cyclic emissions.\n**Consequences:** Acquisition becomes robust to message spacing/jitter and no longer clears buffers on timing gaps; host serial protocol and 4-channel data format remain unchanged.
