refaqt/aqtuator/(commit log)

2025-11-06 moved opta-acquisition, added multisine, improved GUI
    [multisine_optimized.csv]
2025-11-14 Testing analog output (chokes at 20Hz)
2025-11-19 New specifications file for Arduino Giga
2025-11-19 Rebuilt code for Arduino Giga
2025-11-21 Solved bugs in output and acquisition
    [giga-acquisition.ino]
2025-11-21 Initialization of sequential flow
2025-11-24 initial sequential program (arduino goes into error state)
    [multisine_optimized_500Hz.csv]
2025-11-24 Created and succesfully tested test_analog_io.ino
    The test program can generate and acquire voltages for 6 channels at 10 kHz.
2025-11-24 Removed most serial communication but still error when starting acquisition.
    [giga-acquisition.ino]
2025-11-25 Working giga-acquisition.ino, but problems with retreiving data and stopping acquisition.
    [example_output.csv]
2025-11-25 Solved race condition when acquiring at 5000Hz
    [giga-acquisition.ino]
2025-11-25 Solved acquisition complete not detected after new acquisition
    [giga-acquisition.ino]
2025-11-27 Tried UART at high speed.
2025-12-01 Stil no working example for Arduino Giga with HAL
2025-12-10 Trying to set up CAN to ODrive
2025-12-10 Debugging CAN-BUS
2026-01-06 test-controllino-odrive working, test-odrive-can working
2026-01-07 major update with program for Controllino.
    Succesfully uploads csv, but then stuck when sending the output torque to Controllino through CAN.
    [multisine_4.0-800.0Hz_fs_8000.0Hz_df_1.0Hz_N2000.csv, multisine_optimized.csv, multisine_optimized_500Hz.csv]
2026-01-07 Improved flow.
2026-01-08 Adapted code for 4 analog inputs
    The analog inputs can only be 4 because otherwise we cannot sample at 8kHz. The correct calculation of x,y,z still needs to be adapted to the new setup.
2026-01-09 odrive servo identification
    [tf_torque_pos_20260109_132701.csv, tf_torque_pos_20260109_133245.csv, tf_torque_pos_20260109_133516.csv, tf_torque_pos_20260109_133657.csv, tf_torque_pos_20260109_133946.csv, tf_torque_pos_20260109_134157.csv, tf_torque_pos_20260109_134946.csv]
2026-01-12 Added plotting of raw signals before calculating frequency response
    [tf_torque_pos_20260109_132701.csv, tf_torque_pos_20260109_133245.csv, tf_torque_pos_20260109_133516.csv, tf_torque_pos_20260109_133657.csv, tf_torque_pos_20260109_133946.csv, tf_torque_pos_20260109_134157.csv, tf_torque_pos_20260109_134946.csv, tf_torque_pos_20260112_114128.csv]
2026-01-29 Change ADC gain
2026-02-05 using cyclic CAN messages
    Use cyclic CAN messages. Still problems with getting torque values
2026-02-06 Get position and torque from Odrive
2026-02-06 Measure loop time rate
    [tf_torque_pos_20260112_114128.csv, tf_torque_pos_20260112_114544.csv]
2026-03-19 Add PWM sine wave output test for Controllino Micro GPIO0
    Generates a configurable sine wave on the GPIO0 screw terminal (RP2040
    GPIO2) via PWM + RC filter. Uses the arduino-pico core API
    (analogWriteFreq/analogWriteRange/analogWrite) with a hardware repeating
    timer ISR for precise sine table stepping.
    Documents the PWM frequency vs. resolution trade-off and ripple spec
    (3.3V/2^12 target with 4 kHz RC filter), with all key parameters
    adjustable at the top of the file.
2026-03-19 Add filter optimizer
2026-03-25 Update PWM output mapping and timer duty updates
    Use D0 mapping for Controllino MICRO GPIO0 and move analogWrite to loop() to avoid doing driver updates in the repeating timer callback.
    Made-with: Cursor
2026-03-26 Switch Controllino identification to PWM->GPIO1 analog torque path
    Update Python workflow to prompt control mode, handle step/dir gating, and configure GPIO1 analog mapping; refresh docs and rules accordingly.
    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
2026-03-26 Add spindle controller integrator with anti-windup
    Implements a discrete integrator with hold-on-saturation when torque is clamped, and documents the standalone 8 kHz spindle controller behavior.
    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
2026-03-27 Limit Bode plots to multisine band and enforce CSV sample cap.
    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
2026-03-30 Hold 0 Nm at idle and gate ODrive analog endpoint.
    Adjust Controllino acquisition channels and Python processing to use torque_command and x_spindle, and update docs/ADR accordingly.
    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
2026-03-31 Instrument PWM debugging and verify ODrive GPIO1 state
    Add runtime-selectable RP2040 PWM strategies and ODrive GPIO1 analog-state checks so hardware behavior can be compared directly during identification runs.
    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
2026-05-29 Fix robust CAN capture and position output for servo ID
    Decode CANSimple node IDs with a 6-bit mask and store samples only when both torque and position have updated, avoiding acquisition restarts on timing gaps. Print position with higher precision and label Python plots in turns.
2026-05-29 Migrate servo identification to ODrive high-rate capture
    Replace Controllino CAN serial acquisition with odrive.utils high_rate_capture over USB. Remove the servo-identification Controllino sketch, bump odrive to 0.6.11.post0+, and update Workflow B documentation.
2026-08-21 chore(git): scope LFS to CAD and keep measurement data out of git
    The ignore rules covered *.csv and *.png globally but had no rule for
    *.WDH, so a single `git add data/` would have staged 1.28 GB of WinDaq
    captures (167 .WDH + 16 .json + 10 .txt) into history.
    - ignore data/ and the WinDaq extensions outright; measurement data moves
    to Google Drive, indexed by a committed manifest
    - drop the blanket *.csv / *.png rules, which also hid legitimate result
    figures, and replace them with targeted rules
    - anchor the generic Python rules (build/, lib/, dist/, var/, parts/) to
    the repo root so they cannot swallow firmware/<target>/lib/ later
    - add the doqs-prescribed FreeCAD and generated-ou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
2026-08-21 build(doqs): add doqs as a submodule at doqs/
    Pinned to 379c8e5, which adds the measurement/ and software/ folders this
    project needs. doqs has no tags, so a commit SHA is the only pin available.
    The path must be exactly doqs/ - scripts/naming_rules.py derives the machine
    root as __file__/../../.., so any other location silently breaks validation.
    Claude-Session: https://claude.ai/code/session_01R6UBPV9PYhFcoNNRs4ygSm
2026-08-21 feat(measurement): index 1.88 GB of measurement data held on Google Drive
    The measurement archive is 1 659 files and 1.88 GB, growing with every
    campaign. It cannot go in Git, and it does not fit the GitHub LFS free tier -
    which bills bandwidth as well as storage, so it would get more expensive
    exactly as the project matures.
    Instead the data stays on the "3 - Projects" shared drive, where it already
    lives, and Git holds a manifest describing it:
    - measurement/data-index.csv - one row per file with campaign, relpath, tier,
    bytes, sha256 and recorded_utc, plus metadata parsed from this project's
    filename conventions (axis, position, material, spindle_rpm, feed, ae/ap,
    tool, tap index,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
    [data-index.csv]
2026-08-21 refactor: move code into the doqs firmware/software/simulation layout
    src/ mixed three hardware generations, host code and embedded code, and dumped
    generated run artifacts next to sources. Everything moves to its doqs home.
    Firmware (functional names - doqs forbids naming a module after the board):
    src/controllino/main-controllino -> firmware/torque-excitation
    src/controllino/spindle-controller -> firmware/spindle-controller
    src/controllino/test-pwm-output -> firmware/pwm-output-test
    docs/reference-code/test-controllino-adc -> firmware/adc-test
    docs/specs/specifications-controllino.md -> firmware/torque-excitation/docs/
    Software - src/python becomes a real package under softw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
    [multisine_4-800Hz_fs8000Hz_N2000.csv]
2026-08-21 chore(cursor): point the agent rules at the new docs layout
    The rules told agents to read docs/mistakes.md, docs/decisions.md and
    docs/skills.md at the start of every task. All three were split into per-entry
    folders by the doqs restructure, so the instructions pointed at files that no
    longer exist.
    Also rewrites repo-profile.mdc, which claimed "This is a Python project" - the
    repo now holds Python, Arduino/C++, Octave and FreeCAD, and the layout is
    specified by doqs rather than improvised.
    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
2026-08-21 feat(measurement): index the whole testing root, not just one campaign
    The manifest covered "Machine FRF and stability" only, leaving the sibling
    folders on the shared drive undescribed - including the one loose capture that
    had been committed to git (noise_motor_accelerometers_1.WDH), which was not on
    the drive at all and was uploaded and checksum-verified during the migration.
    Now 1 700 files and 1.9 GB, every row classified: adds system-identification,
    high-speed-circular-motion, odrive-setup, cam-toolbits and controllino
    alongside the existing campaigns. Nothing is left "unclassified".
    The manifest is exactly reproducible from build_index.py at this commit.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
    [data-index.csv]
2026-08-24 docs(dev-log): add reluctance actuator investigation entry
    Claude-Session: https://claude.ai/code/session_01Ju7L8agWPcTPpu2mJxywNE
2026-08-27 arch(agents): mount refaqt-agents as .agents submodule
    Replace the vendored .agents copy with a git submodule pointing at
    https://github.com/refaqt/refaqt-agents.git so shared rules and skills
    update from the kit repo.
2026-08-31 docs(log): add Hiwin linear axis idle torque insight
2026-09-02 sim(actuator): size three short-stroke high-force concepts
    First-order feasibility for a two-sided 200 N, 0.1 mm, >10 Hz actuator
    in 50 x 50 x 20 mm under 100 EUR: PM-biased differential reluctance,
    flextensional piezo, and Lorentz plus flexure lever.
2026-09-02 docs(log): record short-stroke actuator concept findings
    Expand today's log with the three-concept feasibility numbers, the
    coupling-vs-inertial conclusion, and the 6-DOF envelope limit.
2026-09-02 sim(actuator): check Fluxthor catalog against reluctance Maxwell sizing
    The 204 N figure is unsaturated pole-face Maxwell stress (4.1 N/cm³), not
    packaged continuous force. Fluxthor Atlas, which advertises the highest EM
    force density, is 0.25–0.41 N/cm³. Treat 200 N reluctance as an upper bound,
    not a spec; two-gap MMF and snap-in flexure were also under-counted.
2026-09-16 feat(agents): check the tooling submodules out at session start
    A cloud session clones this repository without --recurse-submodules, so
    .agents/ and doqs/ arrive empty. Nothing warns about it: the folders exist,
    so an agent reads no rules, no skills and no doqs/docs/architecture.md, and
    cannot run doqs/scripts/validate_all.py.
    Add a SessionStart hook that runs the same two git calls as setup-tooling.sh:
    --init --recursive for the recorded pins, then --remote for doqs and .agents
    only. It checks the marker files rather than the exit code, because git can
    print "Skipping submodule", exit 0 and leave a folder empty. It never stops a
    session and always exits 0.
    .cursor/environment.json runs th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
2026-09-16 docs(tooling): align the repo with the current doqs template layout
    build_model.py is a per-module seed, not a root launcher, so
    install_root_tools.py never copies it. It is copied by hand into a
    module's cad/ and its build() replaced. This repo has no CAD module
    yet, so there is nothing to seed.
    Checked every other doqs template against this repository. The
    launchers, the licence kit, the agent-CAD config and the data-index
    columns are all current. What was stale was the documentation:
    - cad/README.md: FreeCAD skill moved to the agent kit, per-module
    sync_params.py moved to doqs/scripts/cad_sync_params.py. Added how
    to seed the first build_model.py.
    - .agents-local/rules/repo.md: same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
2026-09-16 feat(agents): name the language rule at session start
    The agent kit asks every agent to write in B2 English, in chat as well
    as in files. An agent that reads the rule once can still forget it
    while it writes. That happened in this session, and a person had to
    ask for plain English by hand.
    The session hook now prints one more line: where the rule lives. The
    hook output reaches the agent before it writes anything. The
    no-network branch prints a short version, because the file is missing
    there but the rule still holds.
    Each repository keeps its own copy of this hook, so doqs needs the
    same line. That change is refaqt/doqs#17.
    Claude-Sess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
2026-09-17 feat(tooling): adopt the one doqs command
    The doqs clean-up is merged. This repository now uses it.
    CI runs "python doqs/doqs.py check": the seven gates it already ran,
    plus three checks that committed generated files are current. Verified
    here before switching — all ten pass, so no doqs generate was needed.
    doqs.sh and doqs.bat are installed in the root next to syson.sh. They
    are doqs's files; doqs setup overwrites them when the template
    changes.
    The session hook gained one line from the template, the comment that
    now points at doqs/docs/using-doqs.md.
    The hook file STAYS COMMITTED, against what the plan said. doqs setup
    now ships it as a template and keeps our copy current, so deleti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
2026-09-17 docs(cad): write down how to connect FreeCAD to an agent
    The connection needed two things this computer did not have: the FreeCAD
    add-on, and a package download that this network allows. Both are now set
    up, and the steps are written down so the next person can repeat them.
    The Windows folder named in every guide is wrong for FreeCAD 1.1.
2026-09-18 docs(log): record the FreeCAD bridge setup on the second computer
    The onboarding steps left out the folder that FreeCAD only creates after
    its first add-on, so the add-on landed where FreeCAD never reads it. The
    same certificate problem that breaks downloads with uv also stops winget,
    which was not written down yet. Both halves of the bridge are now pinned
    to one version, because they talk over their own private protocol.
2026-09-18 refactor(modules): move each stage family into its own module
    AQTUATOR is now the root of a product line of linear stages, not a single
    chatter-suppression investigation. Each family is a plain folder under
    modules/, and becomes its own repository only when something concrete asks
    for it: an outside consumer, a separate release rhythm, different access
    rules, or a repository that has grown too heavy to clone.
    The measurement campaigns, the excitation firmware and the host software
    belong to the stage they serve, so they moved into the flexure ball-screw
    servo stage. They travel with that family if it is ever extracted.
    Folder names say what a stage is, not what it is called on a price list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
    [data-index.csv, multisine_4-800Hz_fs8000Hz_N2000.csv]
2026-09-21 Migrate qarve x-axis design to aquator
    [HGL15CA2R760ZBC2_ZZ_E2_FILE_1.stp, HGL15CAZBC_E2_FILE_2.stp, HGR15R418H.stp, MK2-120.STEP, MK2-180.STEP, MK2-300.STEP, MK21.STEP, guide-block.FCStd]
2026-09-21 cad(x-axis): read bought parts from the shared parts library
    The rail, the blocks and the linear motor were stored in this repository.
    They now live in STOQ, the shared parts library, mounted at modules/stoq.
    Both X-axis assemblies link them from there.
    cad/parts/ holds only parts we make ourselves from now on. A bought part
    goes in the library, where its part number, mass, specification, download
    address and checksum sit beside the model.
    Every solid in both assemblies was compared with the version before the
    move: volume, centre of mass and bounding box are unchanged.
    [HGL15CA2R760ZBC2_ZZ_E2_FILE_1.stp, HGL15CAZBC_E2_FILE_2.stp, HGR15R418H.stp, MK2-120.STEP, MK2-180.STEP, MK2-300.STEP, MK21.STEP, guide-block.FCStd]
2026-09-21 fix(ci): let the checks read the parts library's real CAD files
    The build server fetches large files for this repository only, never for
    a submodule. The parts library arrived as placeholders, so every checksum
    comparison against it failed.
2026-09-21 cad(x-axis): measure the models, and fix the tool that could not
    The geometry check has never worked on a real model. It asked every
    shape for its centre of mass using a property FreeCAD does not offer on
    a shape made of several pieces, which is what almost every object in a
    design is. It wrote an empty file and then failed the model on it.
    This updates the shared toolkit to the fix (refaqt/doqs#32) and records
    the first real measurements of all five models: 48 objects, no errors.
    A change that moves geometry now shows up in a pull request.
2026-09-22 sim(strip-seal): size the seal strip and its rollers from supplier data
    The sealing strip is bent by four carriage rollers every time the carriage passes. Nobody sells a linear stage with published fatigue data for that strip, so the numbers now come from strip and steel belt makers who do publish measured values.
    This replaces two earlier estimates that were wrong. The first used textbook constants and was about forty times too pessimistic. The second assumed the strip is bent one way only, which this carriage does not do.
    Claude-Session: https://claude.ai/code/session_01GtiLV2XC2Cx7eUm8MLv7cL
2026-09-22 sim(strip-seal): size the strip on the radius it really takes
    The earlier model treated the roller diameter as the bending radius, so it
    reported 1312 MPa on the 14 mm rollers and asked the design to fit 60 mm
    rollers above the carriage. The carriage drawing shows the strip turns only
    about twelve degrees at each roller. At that angle a 0.1 mm strip bridges a
    14 mm roller instead of wrapping it, and the real stress is 57 to 362 MPa.
    The fatigue limit was also read at 0.25 mm and used for a 0.1 mm strip. The
    maker publishes two thicknesses, and their trend gives about 1019 MPa.
    The rollers stay at 14 mm. What the design controls is the ramp length, and
    the strip becomes a wear part replaced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
2026-09-22 fix(session): the first step runs even when no hook can
    A cloud session that opened this repository together with doqs and refaqt-agents
    left `.agents/`, `doqs/` and `modules/stoq/` empty for the whole session, and
    said nothing about it.
    Claude Code reads `.claude/settings.json` from the session's own project folder
    only. A session with several repositories opens the folder above them, so the
    `SessionStart` entry here was never read and the hook never started. It printed
    nothing, and an empty folder looks exactly like a filled one. The network was
    fine. Nothing was broken; nothing ran.
    Underneath sat a second fault: the hook trusted `$CLAUDE_PROJECT_DIR`, which in
    that layout holds the par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
2026-09-22 chore(deps): point the shared tooling at its merged version
    The session-hook fix is on the doqs main branch now, so this machine pins
    that instead of the version it was reviewed against.
    This also closes a trap this branch carried while the two pull requests were
    open. `install_root_tools.py` overwrites `.claude/hooks/session-start.sh` from
    the doqs template, and the old pin still held the old template, so running
    `bash setup-tooling.sh` would have quietly reverted the hook. With the new pin
    the two files are identical, and the installer reports the launchers as already
    current.
    No repository file changes.
    Claude-Session: https://claud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
2026-09-23 docs(simulation): estimate the motor field at the encoder and a shield
    The magnetic encoder beside the X-axis linear motor must stay below 1 mT.
    This adds a field model of the magnet track, the results with and without
    a steel shield, and a log entry with the next steps.
    Claude-Session: https://claude.ai/code/session_0171t6Aa7Hd1VXi5jkeZrij7
2026-09-25 docs(log): survey drives and a motion controller for the MK21 stages
    Claude-Session: https://claude.ai/code/session_01P3EnRhy1Y5hSuoRUgoRS9J
2026-09-25 sim(strip-seal): model the 0.25 mm strip radius, pull and 304 option
    304 cannot hold a 30 mm radius at 0.25 mm. 301 is exactly at its
    fatigue limit there. Pull makes the bend tighter, and a strip fixed at
    both ends would be pulled far too hard by the carriage.
    Claude-Session: https://claude.ai/code/session_01RZApWrUZQKg7u2zPKph8dK
2026-09-28 docs(log): record the 150 mm strip width and clamped ends
    Claude-Session: https://claude.ai/code/session_01RGy5WvxcvQuWbiXYdckFqt
2026-09-28 Add a web page to design the seal strip and its screw preload
    The page draws the strip over the four rollers at scale, with the force
    on each roller, and shows the pull, the arch height between rollers 2
    and 3, the tightest radius, the stress and the fatigue life. A slider
    sets the travel of the countersunk preload screw.
    The solver is the strip-seal-preload one, ported to JavaScript and
    checked against it. The magnet strips are now an elastic bed, so the
    force on rollers 1 and 4 no longer depends on the grid. A Pages
    workflow publishes only this page.
    Claude-Session: https://claude.ai/code/session_01DpsX7c4cfVqWA4JzbtWEit
2026-09-28 sim(cutting-force-rejection): add a controller vs cutting force page
    A new web page shows how much the stage moves when a milling cutter
    pushes on it. You set the force, the cutter, the spindle speed, the
    stage mass and the controller loop rate. The page tunes the controller
    for a 30 degree phase margin and shows the open loop with its margins,
    the compliance in um/N, the stiffness in N/um, the stage position over
    time, and the vibration against spindle speed. All transfer functions
    are in discrete time.
    The vibration comes from a time simulation that also sees the motion
    between samples, so it still holds above half the loop rate. A check
    script tests the tuning and compares the simulation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
2026-09-28 sim(cutting-force-rejection): show controller force and power
    The page now shows the force the controller puts out, at the start of
    the cut and in the steady state, next to minus the cutting force. Two
    new charts against spindle speed show the controller force per newton
    of cutting force (N/N) and the controller power (W). Power is shown at
    the force set on the page, because it grows with the square of the
    force and has no fixed value per newton.
    The check script compares the force ratio with the transfer function,
    and the mean power with an exact steady-state solution at the samples.
    Claude-Session: https://claude.ai/code/session_018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
2026-09-28 feat(cutting-force): compare a linear motor with a ball-screw servo
    The page now shows three drives side by side: a linear motor, and a
    BLDC motor with a coupling and a ball screw, read at the motor or at the
    stage. Each case can be switched on and off. The optional one-sample
    computation delay is removed, because it will not be there in practice.
    Claude-Session: https://claude.ai/code/session_01P8yNu8KGT4jnR9m9hTLKBc
2026-09-28 feat(cutting-force): add the axial stiffness of screw, nut and bearing
    The ball-screw drive is now three masses: motor, screw and stage. The
    screw shaft, the nut and the fixed bearing form a second spring between
    the screw and the stage, with catalogue defaults. This replaces the
    rigid-screw assumption, which made the ball screw look far too stiff.
    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
2026-09-28 feat(cutting-force): tune every drive with robust rules and real damping
    The ball-screw controllers came very close to instability: the loop
    gain was near 1 where the phase was near or below -180 degrees. Each
    drive is now tuned so that the sensitivity peak stays at or below
    6 dB, the phase margin at or above 30 degrees and the gain margin at
    or above 6 dB, also with each resonance 15 % off the model. The linear
    motor uses the same rules. The coupling and axial damping ratios drop
    to 0.02, with sources and ranges.
    Claude-Session: https://claude.ai/code/session_017iversCf4yw8qecAdEBhbQ
2026-09-29 feat(cutting-force): show where chatter starts for each drive
    The page now shows the stability lobes and the depth of cut that is
    stable at every spindle speed, relative to the collocated ball screw.
    Claude-Session: https://claude.ai/code/session_0132QbZrNUUUQeU7U1m2hM2o
2026-09-29 docs(log): explain why a lighter stage is less stiff
    Claude-Session: https://claude.ai/code/session_01LKHSurqwQDNVdo9kwruACi
2026-09-29 docs(log): check Servotronix drives for a faster position loop
    No Servotronix drive reaches 10 kHz. The CDHD2 already has an 8 kHz
    position controller, and its successor CDHD2S is the model to buy.
    Claude-Session: https://claude.ai/code/session_01UHSb3rTqQ51L6DxrgFH8ru
2026-09-29 docs(log): search non-Israeli drives with an 8 kHz loop and free filters
    Claude-Session: https://claude.ai/code/session_014DLyBwhX8Wt591pbp7xJe7
2026-09-29 docs(log): compare encoder converters and SSI or BiSS-C drives
    Claude-Session: https://claude.ai/code/session_01VQNry3ku5GofM6nTKJQzaS
2026-09-29 docs(log): rank encoder options for new units only
    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
2026-09-29 arch(motor-drive): write the servo drive requirements in SysML
    Future drive searches can cite each requirement by a short name
    instead of repeating the list in every log entry.
    Claude-Session: https://claude.ai/code/session_01WCEFbcaCCuN5Q46Q84uU98
2026-09-29 arch(motor-drive): make the encoder requirement follow the stage encoder
    The position loop must now be at least 4 kHz, and faster is a
    preference. Hall sensors and the thermal sensor type are marked as
    not known.
    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
2026-09-30 docs(log): check if the CDHD2S velocity loop can run our own controller
    The velocity loop has a mode with free polynomials and two free
    second order filters. Our controller fits, but the number format is
    not published, and the free mode only exists in the older CDHD2
    command manual. Servotronix must confirm both. All other drive
    requirements pass from the CDHD2S manual.
    Claude-Session: https://claude.ai/code/session_01EcrzTHwPQU3LZm7NLe81c9
2026-09-30 docs(log): no Delta ASDA-A3 drive is confirmed to meet the requirements
    The closest drive runs our linear motor, but it needs Delta's converter
    box for the 1 Vpp encoder, and its position loop rate is not published.
2026-09-30 docs(decisions): try the Servotronix polynomial velocity controller
    We will put our own controller in the velocity loop of the drive,
    using the free polynomial controller (mode 3). We buy the CDHD2S-003
    if Servotronix confirms it has mode 3, else the legacy CDHD2-003.
    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
2026-09-30 docs(decisions): make the Delta ASDA-A3 the fallback drive
    If the Servotronix CDHD2 does not work, we move to the Delta
    ASD-A3-0421-E with its 1 Vpp converter box. Delta must first confirm
    the position loop rate, and we must accept the converter box.
2026-09-30 docs(decisions): buy the CDHD2S-0032AEC2 to try the polynomial controller
    The decision now names the exact drive: the CDHD2S with 3 A rms,
    220 VAC single phase and EtherCAT. The flyer's "EC2/AP1" lists two
    versions; we need EC2, because AP1 has no EtherCAT. Servotronix must
    still confirm the polynomial controller on the CDHD2S.
    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
2026-09-30 arch(requirements): add the linear stage requirements
    Size, accuracy, speed, force, load and screw hole grid for the linear
    motor stage, as STG-01 to STG-14.
    Claude-Session: https://claude.ai/code/session_01MjapKdeqzkiwc3DhapGmy4
2026-09-30 arch(requirements): set the stage to 3 m/s, 180 N and 500 N
    The drive requirements now use 3 m/s. The encoder signal then reaches
    150 kHz, and the drive needs at least 320 V on its DC bus to give 180 N
    at that speed.
    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
2026-09-30 arch(compact-stage): add the stage parts, assembly and interfaces
    The old X axis models are removed; they will not be used again. The
    compact stage now owns the linear motor stage: its requirements, five
    parts we make, one assembly, and an interface for every pair of parts
    that touch. A new repository rule asks for such an interface every time
    a part is added or connected.
    [base.FCStd, carriage-bottom.FCStd, carriage-top.FCStd, compact-stage.FCStd, linear-guide-x.FCStd, linear-scale-mount.FCStd, sealing-clamp.FCStd, sealing-strip.FCStd]
2026-10-01 fix(compact-stage): put each part's Body inside a Part container
    The new CAD rules need a Part container on top of every part file, so an
    assembly can insert and place the part as one object. The assembly links
    now point at the Part containers.
    [base.FCStd, carriage-bottom.FCStd, carriage-top.FCStd, compact-stage.FCStd, sealing-clamp.FCStd, sealing-strip.FCStd]
2026-10-01 feat(compact-stage): model the base block and the guide pockets
    The base is a 420 x 210 x 40 mm block. Two pockets cut the space for the guides.
    [base.FCStd]
2026-10-01 refactor(compact-stage): build the other parts as Parts, not Bodies
    The carriages, the sealing parts and the assembly now use Parts.
    [carriage-bottom.FCStd, carriage-top.FCStd, compact-stage.FCStd, sealing-clamp.FCStd, sealing-strip.FCStd]
2026-10-01 feat(compact-stage): add pockets for the linear motors in the base
    Motor segments vary in length, so milled reference features are not possible. The motors will be aligned with locating pins.
    [base.FCStd]
2026-10-02 feat(compact-stage): add guide rail holes and alignment tabs to the base
    The base gets threaded holes for the two guide rails and short tabs at
    the side walls that align them. The reference rail lies against two
    tabs; the second rail against one, and the carriage sets its direction
    during assembly. The base is now 440 mm long. The low ribs between the
    rail floors and the motor floor are removed, so no corner touches the
    rail ends. The rails and their interface are now in the architecture.
    [base.FCStd]
2026-10-02 feat(compact-stage): add the linear encoder requirements
    Ten hard requirements, ENC-01 to ENC-10, so an encoder search can cite each one.
    Claude-Session: https://claude.ai/code/session_015jcFRJoip5jeZJATckEG7f
2026-10-02 docs(decisions): the ODrive is a test drive only
    The ODrive S1 was only a tool for tests on the Mekanika Pro. We will not
    use it in future developments. This note adds a decision record and says
    so in the README, the architecture overview, the onboarding guide, the
    compact-stage README and the agent rules. Old logs stay as they are.
    Claude-Session: https://claude.ai/code/session_01F8kNNEWwW65oNzLhSRDEs7
2026-10-02 feat(compact-stage): add the encoder head angle requirement
    ENC-11 compares the angle the encoder allows with the angle the stage gives, in roll, pitch and yaw. The stage values have no number yet.
    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
2026-10-02 feat(compact-stage): allow 1 Vpp or BiSS-C for the encoder
    ENC-04 now accepts a 1 Vpp sine and cosine output or a BiSS-C output, incremental or absolute.
    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
2026-10-02 docs(drives): add servo drive selection overview and comparison table
    One page lists every servo drive from the drive searches next to the
    requirements DRV-01 to DRV-09, with data sheet links, prices and notes.
    No numbers were researched again. It also flags two open points: the
    CDHD2S bus voltage against DRV-04, and the 4 kHz drives that were
    dropped under the old 8 kHz limit.
    Claude-Session: https://claude.ai/code/session_01G21zc7vm2JZzwrtb3cdwGM
2026-10-02 docs(log): add one table that compares all linear encoders considered
    The table lists open encoders from RSF, Numerik Jena, AMO, Heidenhain and
    Lamotion, plus the earlier candidates, against the ENC-01 to ENC-11 requirements.
    Claude-Session: https://claude.ai/code/session_01JFGMPebY69MjGPZBGuECd1
2026-10-06 feat(compact-stage): add mounting holes for the Maxwell motor in the base
    [base.FCStd]
2026-10-06 fix(compact-stage): update the base measurements for the motor holes
    The automatic check failed because the base model changed but its
    measurement file did not. The file now describes the saved model.
2026-10-06 docs(log): check all Heidenhain open encoders against current data sheets
    The Heidenhain rows came from the 06/2021 catalogue, because the site
    blocked downloads. They now come from the 02/2025 catalogue and the
    product sheets up to 07/2026. New models are added. None of them meets
    the encoder requirements.
2026-10-06 arch(compact-stage): require Bode plot tuning in the drive software
    The drive must come with setup software that measures the axis and
    shows Bode plots of the transfer function. This is new requirement
    DRV-10. The position loop limit was already 4 kHz, so it stays.
    Claude-Session: https://claude.ai/code/session_01F9m4YXxxEeEu4g1nAMdvK3
2026-10-06 docs(drives): check every drive for a Bode plot tuning tool
    Two drives now meet all ten hard requirements on paper: the Kollmorgen
    AKD and the Copley Xenus Plus. The chosen Servotronix drive does not
    meet the new tuning requirement as documented, because its software
    shows gain only, without phase.
    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
2026-10-06 docs(drives): make Kollmorgen AKD and Copley Xenus Plus the candidates
    Servotronix is rejected because it is an Israeli company. The Delta
    ASDA-A3 stays the fallback. The rule against Israeli suppliers is now
    written down for every drive search.
    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
2026-10-06 docs(encoders): move the linear encoder table to its own page
    The table grew inside a log entry. It now has its own page, like the
    servo drive overview. No number changed.
    Claude-Session: https://claude.ai/code/session_0179bBvGqzQnxyRSCxj5wrws
2026-10-06 feat(compact-stage): add mounting frames for the linear guide rails
    The base gets two frames, one on the first hole of each rail row, at the
    bottom of the rail pocket. They follow the hole sketch and the pocket
    depth. The stoq library moves to the rail version with its own frame.
    [base.FCStd]
2026-10-07 docs(log): name the best linear encoder and record known prices
    The Renishaw TONiC has the most margin on paper. Only some prices are
    public, so the final choice waits for quotes.
    Claude-Session: https://claude.ai/code/session_01By59ZP6PdRThGTwj1YbjwF
2026-10-07 feat(compact-stage): place the guide rails in the stage assembly
    Both HGR15 rails now sit on the base, on the hole rows and the pocket
    floor. The stored measurements of the assembly and the base are written
    again, so the CAD check passes.
    [base.FCStd, compact-stage.FCStd]
2026-10-07 chore(stoq): use the newest parts library with the HIWIN block frame
    The HGL15 block now has its own coordinate system and its original
    colours. setup-tooling keeps machine modules on their recorded commit,
    so the record must move by hand: 2fe6cb5 -> bf9eec5.
2026-10-07 docs(log): how to mount the encoder scale tape in the base pocket
    Claude-Session: https://claude.ai/code/session_013VftxfH5N7Lb1kkF1gb414
2026-10-07 feat(compact-stage): place the carriage blocks on the guide rails
    Four HGL15 blocks now sit on the two HGR15 rails, two on each rail.
    The stored measurements of the assembly and the base are written
    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
    [base.FCStd, compact-stage.FCStd]
2026-10-07 feat(compact-stage): fix two MK2-180 motor stators to the base
    The base has a mounting frame on the first motor hole of each stator.
    Each stator is held by one fixed joint between its own frame and the
    frame in the base. All stator holes line up with the base holes. The
    stage now uses the stoq version that gives the stators their frames.
    [base.FCStd, compact-stage.FCStd]
2026-10-09 docs(decisions): lay the encoder tape with a printed dummy guide block
    Claude-Session: https://claude.ai/code/session_01UE1Srfc1cu6VJAyuEx5MDM
2026-10-09 feat(compact-stage): add a first draft of the bottom carriage
    The plate has sloped ends and side tabs for stiffness. The tab screws
    cannot be reached yet, because they go in from below. The carriage is
    in the assembly but not yet fixed to the rail blocks.
    [base.FCStd, carriage-bottom.FCStd, compact-stage.FCStd]
2026-10-09 feat(compact-stage): let the carriage sides pass the base block
    Both ends of the bottom carriage now have a cut on the underside. The
    sides no longer hit the base block and can go down through the gap
    between the base and the strip seal.
    [carriage-bottom.FCStd]
2026-10-09 feat(compact-stage): make the bottom carriage stiffer
    Two solid side walls replace the side tabs. The bottom of both walls
    is cut away, so the walls do not hit the base.
    [carriage-bottom.FCStd]
2026-10-12 fix(compact-stage): round the side cutouts of the bottom carriage
    The cutouts in the side walls now have rounded corners. There are no
    sharp edges left, so the part is safer to handle and less likely to
    crack at the corners.
2026-10-12 feat(compact-stage): add locating chamfers to the bottom carriage
    Large chamfers on the sides of the bottom carriage will seat the top
    carriage. A countersunk screw will pull the top carriage against them.
    One chamfer is left clear on purpose, so the top carriage sits in
    exactly one position. This stops it from slowly shifting under large
    loads. The matching chamfers on the top carriage will come in a later
    change.
2026-10-12 feat(compact-stage): add roller pockets to the bottom carriage
    The bottom carriage now has pockets that hold the rollers.
2026-10-12 fix(compact-stage): update the stored measurements of the bottom carriage
    The stored measurements of the bottom carriage described the old shape,
    so the CAD check failed. They now match the saved model again. The model
    itself did not change.
2026-10-12 feat(compact-stage): add the linear motor pocket to the bottom carriage
    The log entry also records three open problems: little room for the
    motor cable, little room for cooling, and the option to make the
    carriage thicker on the bottom side. Nothing was changed for them yet.
2026-10-12 docs(log): water cooling fittings and MK21 heat at 200 N
    Claude-Session: https://claude.ai/code/session_01Ve2EPwFFVZvKcK3cRhWFMG
2026-10-12 docs(log): idea for a motor cable path in the bottom carriage
    Claude-Session: https://claude.ai/code/session_0184YTVEM8CyE4VrtGz1FWSs
2026-10-12 feat(compact-stage): add a cooling channel under the linear motor
    The channel is 1 mm deep, 4 mm wide and fully driven by seven named
    sizes. Its two ends sit side by side, so one connector on top of the
    carriage can feed it from any side. The second step of the motor
    pocket is now as wide as the first one.
2026-10-12 docs(log): add the reading head cable slot to the cable path idea
    Claude-Session: https://claude.ai/code/session_01Pg58BHAyQrrxUqMDJHoyhv
2026-10-13 chore(submodules): update the stoq parts library to the latest main
    Brings in four merged stoq changes: the HIWIN EGR15U rail, the HIWIN EG
    rail QE block, the MK21 forcer part, and a fix for the MK2 stator hole
    pitch. .agents and doqs were already at their latest main.
2026-10-13 docs(log): other makers for the QE15 guide blocks and EGR15U rail
    Claude-Session: https://claude.ai/code/session_015m8qmWda392ff1KGReM7eF
2026-10-13 feat(compact-stage): fit the bottom carriage to the QEH15SA blocks
    The guide blocks now sit in a pocket, so the carriage could grow from
    15 mm to 20 mm thick for more stiffness. Some holes still cut into
    other features and some walls are too thin. The next version fixes
    those.
2026-10-13 fix(compact-stage): clear most feature clashes in the bottom carriage
    The previous version had holes that cut into other features and walls
    that were too thin. Most of those clashes are now fixed.
2026-10-13 fix(compact-stage): update the bottom carriage fingerprint
    The model was saved in FreeCAD after the last fingerprint, so the CAD
    check failed. The fingerprint now matches the saved model.
2026-10-13 docs(log): choose a round connector for the MK21 motor cable
    Claude-Session: https://claude.ai/code/session_01JbmSY4HRv9FN7XCyLF7fAw
2026-10-13 feat(compact-stage): add slots for the MK21 motor cable
    The bottom carriage now has slots for the cable of the MK21 motor.
    The fingerprint was updated so the CAD check matches the saved model.
2026-10-14 docs(log): log the Saho Robot call on encoder parts and MK21 connector
    Claude-Session: https://claude.ai/code/session_01Jw4K2MHU6bqzDe23914AXk
2026-10-14 feat(compact-stage): fit the guide rails, blocks and forcer together
    The base and the bottom carriage now have mounting frames for the
    EGR15U rails, the four QEH15SA blocks and the MK21 forcer. The rails
    are 130 mm apart, the same as the blocks. The carriage clears the
    base walls by 1 mm at the sides and 0.5 mm on top. The forcer pocket
    depth is now a formula, so it no longer breaks when the carriage
    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
2026-10-14 feat(compact-stage): narrow the base to 200 mm and put the rails 138 mm apart
    The base is now 200 mm wide, and the pocket between its walls is
    174 mm wide. Each rail moved 4 mm outward, so the rails are 138 mm
    apart. The bottom carriage grew to 198 mm, so its guide blocks still
    sit on the rails. The forcer stays in the middle. All clearances are
    the same as before: 1 mm at the sides and 0.5 mm on top.
    Some carriage sketches held frozen edge copies that did not follow a
    width change. They now link to the carriage outline, so the next
    width change will not break the model.
2026-10-19 docs(log): DGSMARTWIN AKS drive checked for the MK21 with EnDat 2.2
    What changed
    A log entry names the AKS drive to use with the MK21 motor and an EnDat 2.2 encoder.
    Why
    The user asked which drive in the DGSMARTWIN catalog fits, and whether its control loop is fast enough.
    Result
    The AKS-4D52AECAB fits on current, voltage and encoder. The catalog gives no loop rate, so the drive stays not confirmed until the maker answers.
    Claude-Session: https://claude.ai/code/session_016ZTFsPaNhzKJX91bobuTZb
2026-10-19 docs(log): AKS catalog traced to the Servotronix CDHD manual
    The AKS drive log entry has a new section. It compares the DGSMARTWIN catalog with the Servotronix CDHD manual.
    The user could not find the AKS drives on the maker's web site and asked if they are rebranded.
    The catalog tables are copied from the CDHD manual, but the connectors, switching frequency and alarm list differ. The loop rate stays not confirmed.
    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
2026-10-19 req(encoder): any protocol the chosen drive reads is allowed
    The encoder output rule now says only this: the chosen servo drive for the linear motor must read the encoder directly. For an absolute encoder, BiSS-C, EnDat 2.2 and other serial protocols are all allowed. The drive rule, the encoder selection page and a new decision record say the same.
    The old rule allowed only 1 Vpp and BiSS-C. It rejected good EnDat 2.2 encoders, for example Heidenhain LIC, even when the drive reads EnDat 2.2.
    Encoders that failed only on the protocol must be judged again against the drive candidates.
    Claude-Session: https://cla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
2026-10-19 docs(log): DGSMARTWIN SA32 absolute encoder, order list and supplier questions
    A new log entry names the encoder to order from the DGSMARTWIN catalog: read head SA32EH05A-MC (EnDat 2.2, 0.05 µm step), scale tape SA32-L300-MC, and extension cable E-FN09-26-L05-TC1 for the AKS drive. It checks the SA32 against our encoder requirements and lists 15 questions for the supplier.
    The user wants an absolute encoder with EnDat allowed. The catalog lists no scale applicator and no end clamps, and many deciding numbers are missing.
    The SA32 is on the short list as "not confirmed". The encoder and drive rules were not changed again: commit 775f38e on branch claude/nifty-hamilt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
2026-10-19 feat(compact-stage): make the forcer pocket smaller, away from the cable
    The pocket now fits the motor with 1 mm of space and can be cut with a
    6 mm end mill. The motor and its pocket moved 16 mm away from the cable
    end, so there is room for a cable slot. The wall to the slanted end face
    stays above 1 mm.
2026-10-19 feat(compact-stage): widen the base to 210 mm and the carriage to 208 mm
    The base is 210 mm wide. The pocket for the rails and the motor is
    2 mm wider, and the side walls are 4 mm thicker. The rails stay 138 mm
    apart, in the middle of the base.
    The bottom carriage is 208 mm wide. The part that goes into the base
    pocket is 2 mm wider, so the screw counterbores of the guide blocks now
    have 1 mm of material to its side. The slanted end faces reach 5 mm over
    each base wall, so the seal strip has enough overhang. The shoulders
    take the rest. All spaces to the base are checked and still clear.
    The base is now exactly at the 210 mm width limit of the stage.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
2026-10-19 Compare low-cost eddy current sensors for the stage error test
    ## What changed
    A new page compares eddy current displacement sensors for the error motion
    test of the linear stages. A log entry records the search and the choices.
    ## Why
    We want to measure how the carriage shifts and tilts as it moves, with one
    sensor and a steel straight-edge. The sensor and driver must cost less than
    500 euro.
    ## Result
    No new set under 500 euro passes every requirement on a data sheet number.
    The short list is Miran ML33 (cheapest, shop data only), Baumer IPRM 12,
    used Keyence or Panasonic sets, and Micro-Epsilon DT3005. Every sensor
    needs our own calibration on the straight-edge.
    ## Technical detail
    New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
2026-10-19 Add ACTUSTECH eddy current sensors to the sensor overview
    The displacement sensor page now has a table with every ACTUSTECH eddy
    current sensor, read from the maker's own manuals. A wrong row that ruled
    out the E202 is removed.
    You asked us to look at ACTUSTECH and to judge its sensors on resolution
    only.
    The E202 controller with the EU1S probe is the best sensor on paper:
    0.02 µm resolution and below ±1 µm error over its 1 mm range. ACTUSTECH
    publishes no prices, so we must ask for a quote. The only price hint is an
    unsourced blog estimate of 5,000 to 15,000 yuan.
    Changed: docs/displacement-sensor-selection.md,
    docs/log/2026-10-19_e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
2026-10-19 feat(compact-stage): fix the forcer pocket ends and add two contact pads
    The forcer pocket in the bottom carriage now has flat end walls. The
    ledge at both ends is gone. The space above the lower step of the
    forcer is 1 mm again. The forcer moved 1 mm toward the cable end, so the
    wall to the slanted end face stays above 1 mm (now 1.11 mm).
    The forcer now touches its side wall at two pads of 10 mm, one near
    each end. This gives a clearer position than one long wall. The corner
    notches now end smoothly on the side step, without a thin edge.
2026-10-19 feat(compact-stage): raise the carriage-bottom top to 28.5 mm for a 10 mm cable pocket
    The cable pocket at the side of the bottom carriage is now 10 mm deep,
    up from 5 mm. To keep a 2 mm floor over the shoulders, the carriage is
    2.5 mm taller. The screw counterbores keep their floors, so no screw
    length changes. The stage is now 52.5 mm high (limit: 60 mm).
2026-10-19 cad(compact-stage): save the carriage and the assembly again with the taller carriage
    The geometry is the same as in the last commit. The files were saved
    again in FreeCAD, so the stored fingerprints now match the new files.
2026-10-20 Add a web page to size the end dampers of the compact stage
    The page takes the moving mass, the acceleration stroke, the maximum
    force and the motor data. It finds the impact speed after a runaway,
    sizes a damper with the force law F = c·vⁿ, and plots force, speed and
    energy along the damper stroke. A check script tests the model, CI runs
    it, and the Pages workflow publishes the page at /damper/.
    Claude-Session: https://claude.ai/code/session_014pUto8kTKkSLQEUeQPHvwP
2026-10-20 docs(drives): record that no Kinco servo drive meets the requirements
    Claude-Session: https://claude.ai/code/session_014bvUtsWQUwEakT9tWKMtop
2026-10-20 feat(compact-stage): make the bottom carriage 1 mm lower for the 8.3 mm cable
    The MK21 forcer cable is 8.3 mm thick, not 10 mm. The cable needs less
    room, so the bottom carriage top is now at 27.5 mm, down from 28.5 mm.
    The stage is now 51.5 mm high (limit: 60 mm).
2026-10-20 docs(log): correct which parts moved in the compact-stage assembly
    The whole carriage and all four blocks moved 0.5 mm, not one block.
2026-10-20 docs(damper): list the real cases of a hard impact on the end damper
    The damper page assumes a full runaway at 3.80 m/s with the motor
    pushing. That needs a drive that ignores its own speed limit. The new
    log entry lists the realistic cases and the energy at each speed, and
    proposes a smaller design case.
    Claude-Session: https://claude.ai/code/session_01T1PaDpoQqnHHzJmMxjfgXd
2026-10-20 feat(damper): add a drive speed limit, 2 m/s by default
    The team decided that the stage needs 2 m/s, not 3 m/s. The damper page
    now lets the carriage speed up only to the speed limit of the drive. At
    2 m/s the damper takes 10 J instead of 36 J. A limit of 0 still shows
    the full runaway.
    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
2026-10-20 feat(damper): add a polyurethane bumper as a second type of end stop
    The damper page now asks first which end stop to calculate: an oil
    damper or a short polyurethane bumper. A bumper saves travel, and the
    page shows when it is strong enough and how hard it stops the carriage.
    Claude-Session: https://claude.ai/code/session_01BjbWj66AgUgvN55oED45Lr
2026-10-20 docs(log): compare systems that record three encoders at the same time
    A new page compares systems that read at least three encoders (1 Vpp, EnDat 2.2 or BiSS-C) at the same time and record position against time. A log entry records the search.
    We want to record the position of three encoders against time and export the data.
    Beckhoff EtherCAT terminals, the HEIDENHAIN EIB 741 and S.E.A. modules in an NI CompactRIO are the main routes. No single box does everything with no programming.
    ## What to do next
    Choose the encoder signal, then ask HEIDENHAIN and Beckhoff for quotes.
    Claude-Session: https://c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
2026-10-20 Update maximum motor force in damper model
2026-10-20 Increase maximum motor force to 670 N
2026-10-20 sim(compact-stage): stress analysis of the bottom carriage that runs
    The analysis now lives in its own case in the compact stage module, not
    in the part file. A script reads the part, builds the analysis, and runs
    the solver. Straight middle nodes on the mesh stop the solver error.
    First result: 200 N moves the carriage 0.004 mm, at 5 MPa.
2026-10-20 chore(submodules): move stoq to its latest main
    stoq now includes the new LAMotion ABS encoder parts: read head, scale
    and end clamps (stoq PR #16). The .agents and doqs pins were already
    on their latest main, so they do not change.
2026-10-20 Damper page: bumper force follows the ACE curve, not a straight line
    The bumper on the damper sizing page now has a choice of four force
    curves. The default is fitted to the force-stroke graph that ACE
    publishes for the TUBUS TA37-16: the force rises fast from zero and then
    flattens out. A constant force, a linear spring and a free power law are
    also there. For the TA22-10 at 2 m/s, the peak force falls from 2.14 kN
    (linear) to 1.77 kN. A constant force would give 1.15 kN.
    The "870 N to 90,000 N" on the ACE page is the range of the whole TA
    family, not the force of one bumper. The log and the README say so.
    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
2026-10-20 feat(compact-stage): mount the linear encoder head, scale and clamps
    The LAMOTION read head now sits on the bottom carriage, 0.8 mm from the
    scale, as the data sheet asks. The head pocket is deeper, so the head
    clears the second guide rail by 1 mm, and the head is centred in the
    pocket. The scale and its end clamps sit on the inside of the base wall.
    The parts library moves to the version where the scale and clamps show
    in FreeCAD.
2026-10-20 chore(submodules): move doqs to its latest main
    doqs now opens CAD models that were saved without the FreeCAD window as
    visible (refaqt/doqs#49). modules/stoq was already at its latest main.
2026-10-21 feat(compact-stage): screw the two carriage halves together
    carriage-top now sits on carriage-bottom in the assembly, held by six
    M4 screws. The threaded holes in carriage-bottom are blind, because the
    base is only 0.5 mm under them. The centre hole of carriage-top is gone,
    because the sealing strip runs between the two halves there.
2026-10-21 docs(log): find where the end bumpers fit in the compact stage
    The TA22-10 does not fit. Two TA17-7 per end fit between the guide block
    rows, if the guide blocks move 10 or 20 mm closer together.
    Claude-Session: https://claude.ai/code/session_01FhaG1ptsqCy2T4NTyDuiU6
2026-10-22 docs(log): check the AKD2G order code against the Kollmorgen catalog
    The catalog type key confirms every part of AKD2G-SPE-6V03S-A1F3-0000-A. The "-A" connector set
    does not include the X23 encoder plug. The catalog gives a 125 µs position loop, but the
    installation manual gives 250 µs. We keep 250 µs until Kollmorgen answers in writing.
    Claude-Session: https://claude.ai/code/session_018yhCtpu3bRMXVm6QsB6kNF
2026-10-22 docs(log): choose inductive limit switches and cables for the compact stage
    The compact stage now has a parts list with two autosen AI052 limit
    switches and two autosen AA068 cables. The log entry compares the
    cheaper normally closed sensors and cables found in European web shops.
    Claude-Session: https://claude.ai/code/session_0136vAL4B9bkGUdaVKqJjuws
2026-10-22 feat(compact-stage): four ACE TA17-7 end stop dampers on the carriage
    One damper sits at each corner of the two carriage ends, held by an M4
    square nut in a slot in carriage-bottom. The slots are now 9 mm deep, so
    the damper axis is 29.5 mm above the base floor and the dampers clear
    the magnet track by 1.4 mm. The depth and the four mounting frames come
    from a new Params sheet. The damper at "a, start" still hits the motor
    cable stub, and the guide blocks must move closer together.
2026-10-22 chore(stoq): move the parts library pin to the merged ACE damper
    The library now holds the ACE TA17-7 damper that the compact stage
    assembly uses, so the assembly no longer needs a local copy.
2026-10-22 chore(doqs): move the doqs pin to the library lookup fix
    doqs now finds the real parts library in modules/stoq, not a test
    library inside doqs itself. Without it, the check failed on every parts
    list row that names a library part, like the ACE damper.
2026-10-22 cad(compact-stage): move the guide blocks 10 mm closer together
    The end stop dampers can now press in fully: each block keeps 2.55 mm
    of rail at full press. The read head pocket and the cable paths follow
    the blocks, so they keep their 5 mm wall. The usable travel is still
    206 mm, which is 14 mm short of the 220 mm that the length rule asks for.
2026-10-22 cad(compact-stage): damper pockets in the base, roller pockets on the slope
    The base end walls get a 7 mm deep pocket for each damper, and the guide
    blocks move 10 mm closer again. The stage now has 220 mm of usable
    travel, which meets the length rule, and the dampers can press in fully.
    The sealing strip roller pockets sit on the slope edge again. The slope
    is longer and less steep, so it stays clear of the forcer pocket. The
    read head moved 2 mm, so both walls around its pockets are 3 mm. The
    encoder scale moved with it.
2026-10-22 cad(compact-stage): top carriage slope follows the bottom carriage
    The slanted faces under carriage-top kept an old angle of about 24°.
    They now read the slope length, slope height and carriage length from
    carriage-bottom, so both slopes stay parallel with a 2 mm gap.
2026-10-22 cad(compact-stage): fingerprints match the files saved on closing FreeCAD
    FreeCAD saved the four compact-stage files again when its window
    closed. Only the save time and the view changed. The shapes are the
    same, so only the fingerprint checksums and some decimals moved.
2026-10-22 Add a printed scraper design for each end of the carriage
    The scraper sits in a 10 mm pocket in carriage-top and is held by five
    M3 countersunk screws. Two lips stop 0.15 mm above the seal strip. A new
    case reads the CAD files, checks that nothing overlaps, and draws the
    sections, side views and 3D views. The pocket is not in the CAD file yet.
    Claude-Session: https://claude.ai/code/session_015KSdMQ3hwWmQSAcisrCkFZ
2026-10-22 cad(compact-stage): roller pockets in the top carriage
    carriage-top now has four pockets for the sealing strip rollers, at
    the low end of its slanted faces. The pockets, axle slots and axle
    screw holes read every size from carriage-bottom, so both carriages
    stay the same. The axle slots point inward, as in carriage-bottom.
    A top roller keeps only 0.32 mm to carriage-bottom. The strip
    thickness still has to be checked against this gap.
2026-10-22 Keep the carriage scrapers clear of the new top rollers
    The top rollers in carriage-top reach 7.2 mm from the end face, so the
    first scraper would have hit them. The scraper now has a cut-out at each
    roller and keeps 0.77 mm to it; the pocket in carriage-top follows the
    same shape. The screws moved away from the rollers. The rollers stick out
    1.5 mm below carriage-top, 1.25 mm below a flat strip.
    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
2026-10-27 chore(stoq): update to the version with the RSF MC 15 encoder
    stoq now includes the RSF MC 15 absolute linear encoder (refaqt/stoq#20).
    doqs was already at the newest version, so its pin does not change.
2026-10-27 cad(compact-stage): RSF MC 15 encoder replaces the LAMOTION encoder
    The compact stage now uses the RSF AK MC 15 B read head and the MC 15 MK
    steel tape with a 220 mm measuring length. The LAMOTION head, scale and
    end clamps are gone; the RSF tape needs no clamps.
    - The head fits the existing carriage pocket. Only its two screw holes
    moved 0.2 mm, for the 0.55 mm air gap that RSF asks.
    - The tape moved up 2.25 mm and now runs the other way, so it lines up
    with the head sensor. Its measuring length is centred on the travel.
    - No part touches the encoder at either end of the travel.
    - The travel between the dampers is 222 mm, 2 mm more than the
    measuring length. The limit switches must s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
2026-10-27 chore(stoq): update to the version with the 240 mm RSF tape
2026-10-27 cad(compact-stage): 240 mm RSF tape covers the full carriage travel
    The 220 mm tape was 8 mm too short at each end when both dampers are
    fully pressed. The 240 mm tape covers the full travel, with 2 mm to
    spare at each end. The gap and the alignment of the head did not
    change, and no new parts touch.
2026-10-27 Make carriage-top visible in the assembly
2026-10-27 cad(compact-stage): fingerprints match the hand-saved top carriage
    The top carriage and the assembly were saved by hand in FreeCAD, so
    their recorded measurements no longer matched the files. The checks
    failed. The measurements are now written again from the saved files.
    No shape changed.
2026-10-28 cad(compact-stage): top carriage slanted edges can be milled
    The slanted edges had inside corners that a milling cutter cannot
    make. They are now shaped so the part can be milled. The outside size
    did not change. The fingerprint is written again from the saved file.
2026-10-28 cad(compact-stage): new roller pocket shape with R 3.5 corners
    The sealing strip roller pockets in both carriages now have a narrow
    part and a wide part. The end-side gap to the roller is 0.5 mm, and a
    26 x 7 mm wide part keeps 0.46 mm to the roller end corners. All pocket
    corners are R 3.5. Rollers, axle slots and axle screws did not move.
2026-10-28 docs(compact-stage): ways to close the gap at the carriage sides
    The carriage floats 0.5 mm above the base walls, and nothing closes this
    gap at the sides. This log entry shows how other makers and patents close
    it, and sketches three ways to do it in the compact stage within the
    210 mm width limit.
    Claude-Session: https://claude.ai/code/session_0154kx6XTmaFrxWPShUo5SEP
2026-10-28 docs(compact-stage): clamp the seal strip ends on the end face of the base
    Each strip end stays flat over the end wall, bends down over a rounded
    edge, and is clamped by three thin plates in shallow pockets in the end
    face. Nothing stands above the strip, so the scraper and the carriage
    pass over it, and the base stays 440 mm long. The pull is set by force
    at fitting. A fit check on the CAD geometry finds no overlap. It also
    shows that the top rollers hit the end wall when the dampers press in.
    Claude-Session: https://claude.ai/code/session_0154kx6Yr8W6ciauYAaf2jM2
2026-10-28 docs(compact-stage): strip end clamp that works from the top only
    Version 2 of the strip end clamp. Three steps are milled from the top
    into each end wall. The strip tab hangs on the pins of a small bar, and
    two vertical screws pull the bar down to set the pull. The strip can be
    loosened and taken out from the top, and the base needs no hole from
    the side. Version 1 needed access from the end and side holes, so it is
    dropped. The fit check on the CAD geometry finds no overlap.
    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
2026-10-28 chore(stoq): update to the version with hidden mounting frames
    Claude-Session: https://claude.ai/code/session_0154kx6ayv83ms4in2vjUwy9
2026-10-28 feat(strip-seal): page uses the current roller places and a 0.15 mm strip
    The defaults now follow the compact-stage CAD: rollers 36.83 and 112 mm
    apart, a 13 mm lift, a 186 mm wide strip. The solver also no longer stops
    at very high pulls.
    Claude-Session: https://claude.ai/code/session_0154kx6Z2mxktqFv8LHm1LTv
2026-10-28 docs(compact-stage): 0.15 mm seal strip, and the insert concept for its ends
    The seal strip is now 0.15 mm thick: in the requirements model, in a new
    decision record, and in the scraper fit check. Version 3 of the strip end
    clamp checks the insert concept: an insert with a flange and a nut, pulled
    by a countersunk screw, with a groove milled from the top. It fits, and
    the scraper lips step back around it. The strip model, now with the
    carriage faces as walls, shows that 125 N does not keep the strip off
    carriage-top, and that the pull is very sensitive to the hole positions.
    Claude-Session: https://claude.ai/code/session_0154kx6Yr8W6ci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
2026-10-28 feat(strip-seal): model the carriage channel, plastic ceiling and friction
    The strip now runs between the slopes and under the ceiling of the two
    carriage halves, as in the CAD, with rollers that stick out 0.5 mm. The
    page shows the friction on the carriage for four plastics. A slower
    contact method takes over when the fast one goes round in a circle.
    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
2026-10-28 docs(compact-stage): record the strip end concept of Niels Bosmans
    The log now shows his own drawing of the strip end, with notes: two
    inserts per strip end, each pressed into a hole in the strip by a
    countersunk screw that sits a little off centre, so tightening the screw
    pulls the strip. The earlier misreading (one insert with a nut, on the
    centre line) and its fit check are removed. The strip model for the
    0.15 mm strip stays, as its own case.
    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
2026-10-28 fix(strip-seal): plastic strip on the ceiling is a short pad in the middle
    The plastic used to cover the whole ceiling from roller 2 to roller 3.
    It is now a pad of a set width (10 mm to start), centred between
    rollers 2 and 3. Beside it the ceiling is bare aluminium.
    Claude-Session: https://claude.ai/code/session_0154kx6Zr551fhndbx5g2c7E
2026-10-28 docs(compact-stage): check the corner insert concept against the CAD
    The strip end concept of Niels Bosmans is built from his drawing and
    checked against the base, both carriage halves, the scraper and the top
    rollers. It fits. Sunk flush with the strip, the insert clears
    everything, even in a crash. As drawn, it is hit by the scraper lips and
    carriage-top at the end of the travel. A membrane model shows that the
    pull is even under the carriage, but the strip middle near the ends
    carries almost no pull and may wrinkle beside the inserts.
    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
2026-10-28 docs(compact-stage): corner pockets and a spring end for the strip inserts
    The carriage passes over the strip insert on its way to the end of the
    travel. A shallow corner pocket in carriage-top and scraper lips that
    step back behind the insert clear it. The insert moves over the strip
    ear, so the lip stays off the strip where it rises towards the carriage
    slope. At one strip end, springs on sliders set the pull by force, so
    hole tolerances, temperature and settling hardly change it.
    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
2026-10-28 feat(compact-stage): seal strip rollers on flanged ball bearings
    Each of the eight rollers is now a 2 x 28 mm dowel pin, two NSK F692ZZ
    flanged bearings, two M2 washers and a sleeve cut from 10 x 2 mm tube.
    A plastic roller on the pin would add 35 to 52 N of drag; the bearings
    add about 0.2 N. The rollers are in the assembly, the BOM and the
    architecture model. The bought parts come from the stoq branch
    claude/seal-strip-roller-parts.
    Claude-Session: https://claude.ai/code/session_0154kx6Xquaf62fqZ4w4Xxbt
2026-10-28 feat(compact-stage): axle slots 1 mm deeper, rollers stick out 0.5 mm
    The axle slots in both carriage halves are now 5.5 mm deep. The pin lies
    on the slot floor, so each roller sticks out 0.5 mm, as the seal strip
    page assumes. The rollers were placed again; nothing overlaps.
    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
2026-10-29 fix(compact-stage): carriage top shows its roller pockets again
    The carriage-top Body did not end on its last feature, so the roller
    pockets were missing. The model was fixed by hand. The fingerprint is
    measured again from the saved file, so the CAD check passes.
2026-10-29 docs(log): how to make the seal strip and keep its edges free of burrs
    Records the material, the cutting and edge finishing processes, and the
    finding that the corner ears make the long edges a cut edge.
    Claude-Session: https://claude.ai/code/session_0154kx6XUuXcj1ZtAZcRcTWy
2026-10-29 feat(compact-stage): two stages screw together as a cross table
    The base has twelve M5 clearance holes and a 0.5 mm recess in its
    bottom face, so only two strips touch the machine. The top carriage
    has twelve M5 blind threaded holes in four rows. The outer rows match
    the base of a second stage turned by 90 degrees. The top carriage also
    has a 0.5 mm recess in the middle, so the load rests only on the face
    around it. No hole breaks through into a pocket.
2026-10-29 feat(compact-stage): seal strip preloaded in the assembly, with its screws
    The 0.15 mm seal strip is drawn in its preloaded state, with the carriage
    in the middle. Seal strip rollers 2 and 3 sit 0.5 mm lower, and the pull is
    270 N: the strip touches neither carriage half, and its fatigue life is
    infinite with 32 % margin (limit extrapolated to 0.15 mm).
    - Base: strip pocket and magnet ring pocket (Niels Bosmans); preload
    screws 6.5 mm from the ends, magnet ring cut in two around them; strip
    pocket 186 mm wide.
    - Strip 185.6 mm wide, 0.2 mm room on each side; build script reads the
    shape from the new strip-seal-fit case.
    - Two ISO 10642 preload screws (taken out after fitting) and four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
2026-10-30 fix(compact-stage): round the magnet ring split corners so they can be milled
    The split corners were sharp, so no cutter could make them. They are now 4 mm radii.
2026-10-30 fix(compact-stage): counterbore so the strip preload screws can go down
    The preload screw cones rested on the base, so the screws could not be tightened
    to pull the seal strip.
2026-10-30 feat(compact-stage): slots for the seal strip corner screws
    The four corner holes of the seal strip are now slots along the travel:
    4.5 mm wide, 1 mm centre to centre, centred on the screw. The strip can
    slide 0.5 mm each way under the screw collars, so the preload can be
    adjusted more. The preload holes do not change.
    - New parameter strip_corner_slot_l = 1 mm.
    - Strip rebuilt and saved, with a new fingerprint. No overlap with the
    six screws in the assembly.
2026-10-30 feat(compact-stage): corner screws 1 mm in, and the seal strip as cut
    - The four corner screws of the seal strip sit 6 mm from the base ends
    (were 5 mm): base holes (new named constraint corner_screw_x), the
    screws in the assembly and the strip slots moved together.
    - The strip file now also holds the flat strip as cut, a parametric Body
    with fully constrained sketches. It is 441.95 mm long: the climb over
    the rollers adds 3.98 mm, the 270 N pull takes 0.02 mm off. The
    assembly still shows only the bent strip.
    - No overlaps with the screws; the rollers touch the strip as before.
2026-11-04 feat(compact-stage): room for the seal strip to slide at the ear steps
    The corner slots let the strip slide 0.5 mm each way, but the 45° ear
    steps kept only 0.28 mm along X to the base. The steps now sit half a
    slot length further out, so 0.2 mm is left at the full slide.
2026-11-04 fix(drive): check the Agito drive against the RSF BiSS C encoder
    The encoder changed to the RSF AK MC 15 B (BiSS C) on 2026-10-27, but
    the drive requirements still described the old 1 Vpp encoder. The
    requirements, the Agito log entry and the email now use the RSF head.
    A mistake note records why the old encoder was used.
    Claude-Session: https://claude.ai/code/session_0154kx6a78g9bGa51VyTQKuP
2026-11-04 docs(drive): keep Agito Akribis and Akribis Systems apart; CASD note
    The drive list now has separate rows for Agito Akribis Systems Ltd.
    (Israel), Akribis Systems Pte Ltd (Singapore) and Googol. A new log
    entry records that the Akribis CASD looks like a Servotronix CDHD.
    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
2026-11-05 fix(compact-stage): no alignment tab at the second guide rail
    The second rail had one tab, and the carriage also sets its line during
    assembly. So the rail had one constraint too many. The tab is removed.
    The reference rail keeps its two tabs. The architecture text and the log
    say the same.
2026-11-05 docs(log): check the HIWIN ED1 drive against the drive requirements
    The E2 cannot be delivered in Europe, so the E1 (ED1) was checked
    instead. Best fit: ED1F-EN-0422-01-00 with the ESC-SS-S02 box.
    Claude-Session: https://claude.ai/code/session_0154kx6ZHmsEGJx7i7jGXcnH
2026-11-05 feat(compact-stage): magnet strips in the ring pocket of the base
    The parts library now has the magnet tape that holds the seal strip
    down. The library is updated to that version, and six strips are in
    the compact stage assembly: two long strips (417.5 mm) on the long
    sides of the magnet ring and four short strips (80 mm) in the end legs.
    They lie adhesive face down on the ring floor. No part overlaps.
    The bill of materials has two new rows (MEC-007, MEC-008); order three
    0.5 m rolls per base. The architecture has a new interface for the ring
    pocket and a new part, MagnetStrip.
2026-11-05 docs(drive): mark the MK21 thermal sensor as known
    The MK21 heat sensor is three PTC thermistors in series. The motor
    model now holds its resistance values, and the drive requirement for
    the motor heat sensor uses them. Two drives that waited for the sensor
    type now pass that requirement.
    Claude-Session: https://claude.ai/code/session_0154kx6Y7wjsi2e92Pidi45M
2026-11-05 feat(compact-stage): magnet strips on base frames, screws on joints
    The short magnet strips lay over the damper slots in the end walls of
    the base. They are now 21.5 mm long, four in each end leg, each on a
    piece of solid floor. The new length is in the parts library.
    The base has ten new frames, one for each magnet strip, and each strip
    is held to its frame by a joint. The six seal strip screws are held to
    their holes in the base by joints too. None of these parts has to be
    moved by hand any more when the base changes.
    Bill of materials: 8 short strips instead of 4; still 3 rolls per base.
2026-11-06 feat(compact-stage): preload counterbore in the base is 6 mm wide
    The counterbore under the seal strip preload screws is now 6 mm wide,
    up from 5 mm. The depth stays 2.48 mm. The wall to the magnet pockets
    is now about 0.9 mm.
2026-11-06 docs(compact-stage): preliminary CE assessment and drive safety requirements
    A first CE check of the compact stage, with a list of dangers and what to change. The drive now
    has three new hard requirements: CE mark, certified Safe Torque Off, and motor stops on faults.
    The stage will be sold to labs and companies that build it into their own machines. They need a
    drive with safety features, and we need to know what the stage design still lacks.
    ## What to check
    The end stops are too weak for 3 m/s. The RSF read head shows no limit outputs in its manual.
    <details>
    <summary>Technical notes</summary>
    - New: docs/compact-stage-ce-assessment.md.
    - motor-drive.sysml: DRV-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
2026-11-06 docs(compact-stage): drive safety check against the new CE requirements
    The CE assessment now has a table of the eight drives on the list, checked against the new
    safety requirements in the makers' own manuals. A log entry records the work.
    Niels asked whether his drive options have the safety features the stage needs.
    The Copley XEL has no certified Safe Torque Off. No drive is confirmed on all three new hard
    requirements, mainly because no Declaration of Conformity or safety certificate was seen.
    - docs/compact-stage-ce-assessment.md: drive table and sources.
    - docs/servo-drive-selection.md: short note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
2026-11-06 feat(compact-stage): water cooling of the forcer, sealed with standard O-rings
    The forcer cooling channel now has a seal, a connection to two hoses,
    a hose route to the side, and a clamp that closes the side exit.
    - carriage-bottom: narrower cooling channel (3 mm tool, ends turned to
    the middle of the carriage), groove for a standard 90 x 2 NBR 70
    O-ring around it, pocket and two ports for the cooling block, two
    countersunk M2.5 screw holes from below, a hose slot beside the motor
    cable, the motor cable bend moved 5 mm (radius 35 mm), and two M3
    holes in the side face for the clamp. All new pocket corners can be
    milled with a 6 mm cutter.
    - New printed cooling block (SLA): two 5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
2026-11-09 docs(compact-stage): CE assessment for the Machinery Regulation, limit switches removed
    The CE assessment now follows the Machinery Regulation (EU) 2023/1230, which applies from
    20 January 2027. It explains payload and speed as design limits, why the stage is safe without
    limit switches, and when Safe Torque Off must work and how to make it compliant. A new stage
    requirement says the end stops must stop the worst case. The limit switches left the parts list.
    Niels confirmed the encoder has no limit signal, and the stage will be sold after January 2027.
    The largest payload has no number yet. The end stops still allow only about 2.3 m/s at 5 kg.
    <deta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
2026-11-09 docs(compact-stage): payload against speed table, damper overload, earthing
    The CE assessment now has a table with the speed limit to lock in the drive for each payload. It
    explains what happens when the dampers are overloaded, and how the carriage is earthed through
    the forcer. The drive has a new preference: settings locked with a password.
    Niels will set and lock the top speed in the drive for each customer, and asked whether an
    overload is a safety problem and how to earth the carriage.
    The moving mass of 4.2 kg is an estimate from the CAD; weigh the first carriage. MAXWELL must
    confirm that the motor cable's earth wire connects to the forcer bod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
2026-11-09 docs: record the DGSMARTWIN answers and stop with them for now
    DGSMARTWIN answered on 2026-11-09. The AKS drive still has no loop rate
    ("minimum communication cycle: 1 ms" is not one), and its documents are
    mostly in Chinese. The SA32 encoder costs CNY 5,500 and comes with no
    manual or CAD model. We do not continue with them for now.
2026-11-09 feat(compact-stage): parametric cooling block with Festo fittings and new cable clamps
    The printed cooling block is now built from FreeCAD features with every size
    from the module parameters. It runs to the side face, where a head holds two
    Festo NPQH-D-M5-Q4-P10 push-in fittings in tapped M5 threads. Four M2.5
    screws hold it. Two small cable clamps replace the side clamp. The O-rings,
    fittings, hose stubs and screws are in the assembly and the parts list, and
    the parts library points at the stoq version that holds them.
    Review fixes follow in the next commit.
2026-11-09 fix(compact-stage): review fixes for milling, printing and the cable clamps
    - The cooling block has one flat top face to print on. Its head hangs down,
    and a short drop joins each passage to its M5 thread.
    - One countersunk screw near the side face instead of two.
    - The cable clamps sit in the existing cable slots, flush with the side
    face, with square corners and 0.1 mm of room on each side.
    - The deeper part of the motor cable slot has half-round ends, so a mill can
    cut it.
2026-11-10 feat(compact-stage): add the end-stop crash study and the FEM install
    Adds a script that installs FreeCAD, Gmsh and the CalculiX solver on
    Linux, and a first version of the crash study of the compact stage.
    The study files are ready; the results follow in the next commit.
    Claude-Session: https://claude.ai/code/session_0154kx6ZShtMJoLZuBQf8wcR
2026-11-10 fix(compact-stage): stress analysis finds the moved guide block seats
    The bottom carriage changed on 2026-11-09. The guide block seats grew to
    35 x 58 mm and the top corner load edges to 7 mm, so the analysis could
    not find its faces. The new run bends 0.0044 mm and peaks at 7.5 MPa.
    Claude-Session: https://claude.ai/code/session_0154kx6bFPYyCf3RZeYmFFHZ
2026-11-10 feat(compact-stage): results of the end-stop crash study at 2 m/s
    A crash at 2 m/s with the motor pushing is survivable with no payload,
    borderline at 1 kg (read head over its rating), and breaks the stage with
    a second stage on top. The 7075 base keeps a dent of 0.004 mm at most.
    Adds the summary, the payload table, the log entry and a link from the CE
    assessment.
    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
2026-11-10 feat(compact-stage): interactive results page for the end-stop crash study
    A web page that shows one crash case at a time: the verdict against each
    limit, the models and their inputs, time plots, the payload map and the
    checks that the numbers hold together. The 3D stress data follow in the
    next commit, when the new stress run is done.
    Claude-Session: https://claude.ai/code/session_0154kx6akppi2TW6wWD2FA7A
2026-11-10 feat(compact-stage): 3D stress fields of the base for the crash page
    The new stress run of the base, with the full field of every load step,
    and the mesh check. The page now also says that the peak stress depends
    on the mesh by about 13 %, because it sits at a sharp inner corner.
    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
2026-11-10 feat(compact-stage): second check of the lasting dent, and the log entry
    The stress run is repeated with an elastic material. The difference of
    the two runs gives the lasting dent a second way. It agrees with the
    study: a few micrometres at most in every case.
    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
2026-11-10 docs(log): a linear motor of any brand fits the HIWIN table
    Claude-Session: https://claude.ai/code/session_0154kx6axpQ2ABfLeo3ttnJb
2026-11-11 sim(hard-turning): add a page that checks hard turning on two stages
    The page works out the stiffness at the tool tip of a cross slide made
    of two stacked compact stages, and the depth of cut where chatter
    starts in hardened steel. It reuses the motor loop and the lobes of the
    cutting force page.
    Claude-Session: https://claude.ai/code/session_0154kx6awodFVwjRZPG5drdJ
