refaqt/aqtuator/(notices)

Notices in the files:
docs/log/2026-09-29_drives-below-800-euro-per-axis.md:
Openness | Open source (GPLv3). The loops are small blocks of C code, so we can add a biquad filter block
docs/log/2026-09-25_linear-stage-drive-and-motion-controller-survey.md:
IgH EtherLab, with its Simulink target | Limited by the PC and network card | Free (GPL), plus MATLAB if you use Simulink | C, or a Simulink model
SOEM on real-time Linux | Limited by the PC and network card | Free (GPLv3) or commercial | C
